OrbitalCommons/gumstick/current-df40-connectors/docs/antenna/ABRACON-QUESTIONS.md

> Historical Abracon proposal, superseded by the Pulse integration in INTEGRATION.md. Do not use these old coordinates or part numbers for assembly.

# Vendor clarification draft — not sent

We are integrating ACAG0201-2450-T into a 20 × 44.15 mm four-layer Wi-Fi PCB, with the antenna at the 20 mm end. Please provide current reference Gerber/DXF/CAD and confirm:

1. The 2025-09-20 component datasheet p.5 land pattern specifies 0.6 / 0.8 / 0.6 mm across the two pads. The p.6 reference drawing appears to label the central spacing as 0.7 mm. Which copper edges does that dimension measure, and which exact pad/cutout geometry should a new design use?
2. Exact layer-by-layer ground/feed polygons, PCB-edge datum, antenna body/pad position, and allowed ground connection geometry. Is the 3 × 5 mm envelope valid with the current antenna revision, and what are the minimum ground-plane dimensions?
3. Confirm marked-end/pad-1 input orientation in top-view placement CAD and tape/reel orientation for assembly.
4. Are the March 2025 EVB matching notes still applicable after the September 2025 product update? Please provide the latest EVB stackup and S-parameters or tuning guidance.
5. Suitability at the short edge of a 20 × 44.15 mm board, with a mating carrier below the module but the antenna end overhanging that carrier. Any additional minimum separation or enclosure guidance?

We understand final matching values require measurement on our assembled geometry.
