OrbitalCommons/gumstick/current-df40-connectors/fab/bom/module-bom.csv

Refs | Value | Footprint | Qty | DNP
C1 | 3.3pF | Module:C1_CAPC1005X60 | 1
C2 | 3.3pF | Module:C2_CAPC1005X60 | 1
C6 | 12pF | Module:C6_CAPC1005X60 | 1
C7 | 12pF | Module:C7_CAPC1005X60 | 1
C32 | 1uF | Module:C32_CAPC1005X60 | 1
C33 | 10uF | Module:C33_C_0603_1608Metric | 1
C34 | 10uF | Module:C34_C_0603_1608Metric | 1
C35 | 0.1uF | Module:C35_CAPC1005X60 | 1
C37 | 0.1uF | Module:C37_CAPC1005X60 | 1
C38 | 0.1uF | Module:C38_CAPC1005X60 | 1
C39 | 0.1uF | Module:C39_CAPC1005X60 | 1
C40 | 0.1uF | Module:C40_CAPC1005X60 | 1
C41 | 0.1uF | Module:C41_CAPC1005X60 | 1
C42 | 0.1uF | Module:C42_CAPC1005X60 | 1
C43 | 10uF | Module:C43_C_0603_1608Metric | 1
C44 | 0.1uF | Module:C44_CAPC1005X60 | 1
C45 | 10uF | Module:C45_C_0603_1608Metric | 1
C46 | 0.1uF | Module:C46_CAPC1005X60 | 1
C48 | 0.1uF | Module:C48_CAPC1005X60 | 1
C49 | 0.1uF | Module:C49_CAPC1005X60 | 1
C50 | 0.1uF | Module:C50_CAPC1005X60 | 1
C52 | 0.1uF | Module:C52_CAPC1005X60 | 1
C60 | 10uF / 10V | Module:C60_C_0603_1608Metric | 1
C61 | 22uF / 10V | Module:C61_C_0603_1608Metric | 1
C62 | 1uF / 6.3V | Module:C62_C_0603_1608Metric | 1
C63 | 1uF / 6.3V | Module:C63_C_0603_1608Metric | 1
C66 | 1uF / 6.3V | Module:C66_C_0603_1608Metric | 1
C67 | 22uF / 10V | Module:C67_C_0603_1608Metric | 1
D1 | FC-B1010RGBT-HG | Module:D1_RGBLED | 1
J1 | DF40C(2.0)-40DS-0.4V(51) | Module:J1_DF40C_40DS_2mm | 1
J2 | DF40C-40DP-0.4V(51) | Module:J2_DF40C_40DP | 1
J3 | U.FL-R-SMT-1(01) | Module:J3_U.FL_Hirose_U.FL-R-SMT-1_Vertical | 1
L1 | 100ohm @100MHz | Module:L1_L_0603_1608Metric | 1
L2 | 100ohm @100MHz | Module:L2_L_0603_1608Metric | 1
L3 | 2.2nH | Module:L3_INDC1006X60N | 1
L4 | 2.2uH | Module:L4_L_XFL3012_222MEC | 1
R3 | 0R | Module:R3_RESC1005X40 | 1
R20 | 10kR | Module:R20_RESC1005X40 | 1
R22 | 10kR | Module:R22_RESC1005X40 | 1
R28 | 10kR | Module:R28_RESC1005X40 | 1
R29 | 10kR | Module:R29_RESC1005X40 | 1
R62 | 100kR | Module:R62_R_0402_1005Metric | 1
R64 | 75kR | Module:R64_R_0402_1005Metric | 1
R65 | 24kR | Module:R65_R_0402_1005Metric | 1
U1 | ESP32-S2FH4 | Module:U1_QFN56_ESP32-S2FH4_EXP-M | 1
U2 | iCE40UP5K-SG48 | Module:U2_ICE40-QFN | 1
U3 | TPS62160DGKR | Module:U3_VSSOP-8_3x3mm_P0.65mm | 1
U4 | TLV75512PDBVR | Module:U4_SOT-23-5 | 1
Y1 | 40MHz / CL10pF | Module:Y1_JGHC_S2240000101050 | 1
