OrbitalCommons/gumstick/programming-carrier/fab/bom/carrier-bom.csv

Comment | Designator | Quantity | Footprint | MPN | LCSC Part # | Supplier URL
4.7uF | C1,C2 | 2 | Carrier:C_0603_1608Metric | CL10A475KO8NNNC | C19666 | https://www.lcsc.com/product-detail/C19666.html
100nF | C3,C10,C11,C12,C13,C14,C15,C16,C17,C18 | 10 | Carrier:C_0603_1608Metric | CC0603KRX7R9BB104 | C14663 | https://www.lcsc.com/product-detail/C14663.html
GREEN | D1,D2,D10,D11,D12,D13,D14,D15,D16,D17,D18,D19,D20,D21,D22,D23,D24,D25,D26,D27,D28,D29,D30,D31,D32,D33,D34,D35,D36,D42,D43,D44,D45,D46,D47,D48,D49,D50,D51,D52,D53,D54,D55,D56,D57,D58,D59,D60,D61,D62,D63,D64,D65,D66,D67,D68,D69,D70,D71 | 59 | Carrier:LED_0603_1608Metric | XL-1608SYGC-06 | C965805 | https://www.lcsc.com/product-detail/C965805.html
RED | D74,D75,D76 | 3 | Carrier:LED_0603_1608Metric | KT-0603R | C2286 | https://www.lcsc.com/product-detail/C2286.html
500mA PTC | F1 | 1 | Carrier:Fuse_1206_3216Metric | 1206L050/15YR | C151162 | https://www.lcsc.com/product-detail/C151162.html
DF40C-40DP-0.4V(51) | J1 | 1 | Carrier:J1_Module_v1_Mate | DF40C-40DP-0.4V(51) | C424643 | https://www.lcsc.com/product-detail/C424643.html
DF40C(2.0)-40DS-0.4V(51) | J2 | 1 | Carrier:J2_Module_v1_Mate | DF40C(2.0)-40DS-0.4V(51) | C597934 | https://www.lcsc.com/product-detail/C597934.html
USB-C USB2 | J3 | 1 | Carrier:USB_C_Receptacle_HRO_TYPE-C-31-M-12 | TYPE-C-31-M-12 | C165948 | https://www.lcsc.com/product-detail/C165948.html
5.1kR | R1,R2 | 2 | Carrier:R_0603_1608Metric | 0603WAF5101T5E | C23186 | https://www.lcsc.com/product-detail/C23186.html
2.2kR | R3 | 1 | Carrier:R_0603_1608Metric | 0603WAF2201T5E | C4190 | https://www.lcsc.com/product-detail/C4190.html
1kR | R4,R5,R10,R11,R12,R13,R14,R15,R16,R17,R18,R19,R20,R21,R22,R23,R24,R25,R26,R27,R28,R29,R30,R31,R32,R33,R34,R35,R36,R42,R43,R44,R45,R46,R47,R48,R49,R50,R51,R52,R53,R54,R55,R56,R57,R58,R59,R60,R61,R62,R63,R64,R65,R66,R67,R68,R69,R70,R71,R74,R75,R76 | 62 | Carrier:R_0603_1608Metric | 0603WAF1001T5E | C21190 | https://www.lcsc.com/product-detail/C21190.html
100kR | R110,R111,R112,R113,R114,R115,R116,R117,R118,R119,R120,R121,R122,R123,R124,R125,R126,R127,R128,R129,R130,R131,R132,R133,R134,R135,R136,R142,R143,R144,R145,R146,R147,R148,R149,R150,R151,R152,R153,R154,R155,R156,R157,R158,R159,R160,R161,R162,R163,R164,R165,R166,R167,R168,R169,R170,R171,R174,R175,R176 | 60 | Carrier:R_0603_1608Metric | 0603WAF1003T5E | C25803 | https://www.lcsc.com/product-detail/C25803.html
BOOT / RUN | SW1 | 1 | Carrier:SW_SPDT_CK_JS102011SAQN | JS102011SAQN | C221660 | https://www.lcsc.com/product-detail/C221660.html
RESET / GPIO46 INPUT | SW2,SW3 | 2 | Carrier:SW_SPST_TL3342 | TL3342F160QG | C2886898 | https://www.lcsc.com/product-detail/C2886898.html
AP2112K-3.3 | U1 | 1 | Carrier:SOT-23-5 | AP2112K-3.3TRG1 | C51118 | https://www.lcsc.com/product-detail/C51118.html
USBLC6-2SC6 | U2 | 1 | Carrier:SOT-23-6 | USBLC6-2SC6 | C7519 | https://www.lcsc.com/product-detail/C7519.html
SN74LVC541APWR | U3,U4,U5,U6,U7,U8,U9,U10,U11 | 9 | Carrier:TSSOP-20_4.4x6.5mm_P0.65mm | SN74LVC541APWR | C113281 | https://www.lcsc.com/product-detail/C113281.html
