OrbitalCommons/gumstick/current-df40-connectors/3dmodels/ACAG0201-2450.step

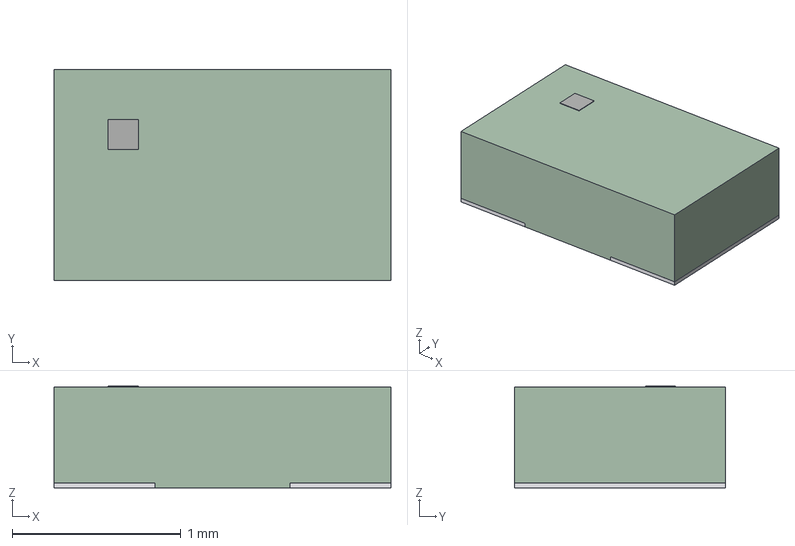
[picture p10: CAD file, 2026-09-26]
current-df40-connectors/3dmodels/ACAG0201-2450.step
2.00 x 1.25 x 0.604 mm
nominal_body
terminal_1
terminal_2
top_orientation_mark
