OrbitalCommons/gumstick/current-df40-connectors/fab/module.step

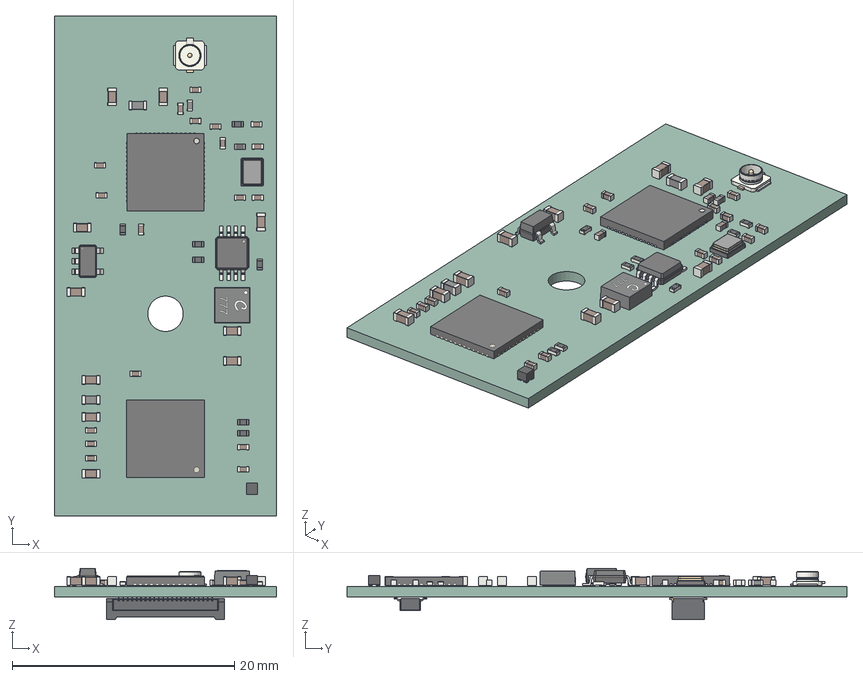
[picture p11: CAD file, 2026-10-06]
current-df40-connectors/fab/module.step
20.0 x 45.0 x 4.62 mm
L_0603_1608Metric x 2
C_0402_1005Metric x 18
SOT-23-5
C_0603_1608Metric x 10
R_0402_1005Metric x 8
U.FL_Hirose_U.FL-R-SMT-1_Vertical
VSSOP-8_3x3mm_P0.65mm
a48c614c-8773-11ed-8f9d-58fb8493fcfb_part
a48c63fe-8773-11ed-8f9d-58fb8493fcfb_part
a48c65a2-8773-11ed-8f9d-58fb8493fcfb_part
a48c66d8-8773-11ed-8f9d-58fb8493fcfb_part
QFN-48-1EP_7x7mm_Pitch0.5mm
Crystal_SMD_2520-4Pin_2.5x2.0mm
XFL3012
black_package
terminal_1
terminal_2
terminal_3
terminal_4
L_0402_1005Metric
DF40C_40DP
DF40C_2_0_40DS
module_PCB
