OrbitalCommons/gumstick/current-df40-connectors/renders/current-df40-connectors.stl

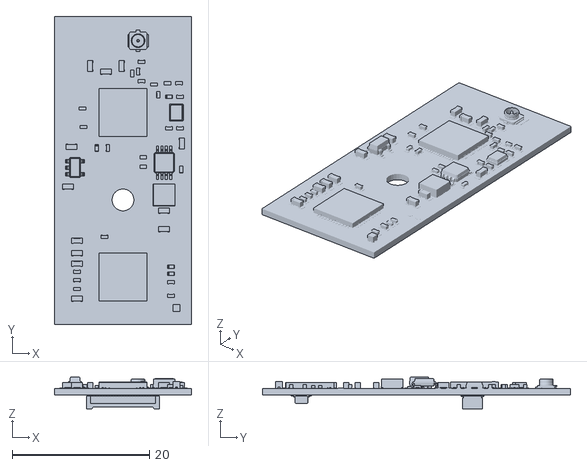
[picture p12: CAD file, 2026-10-20]
current-df40-connectors/renders/current-df40-connectors.stl
20.0 x 45.0 x 4.62
