OrbitalCommons/gumstick/future-m2-goldfingers/3dmodels/FC-B1010RGBT-HG_approx.step

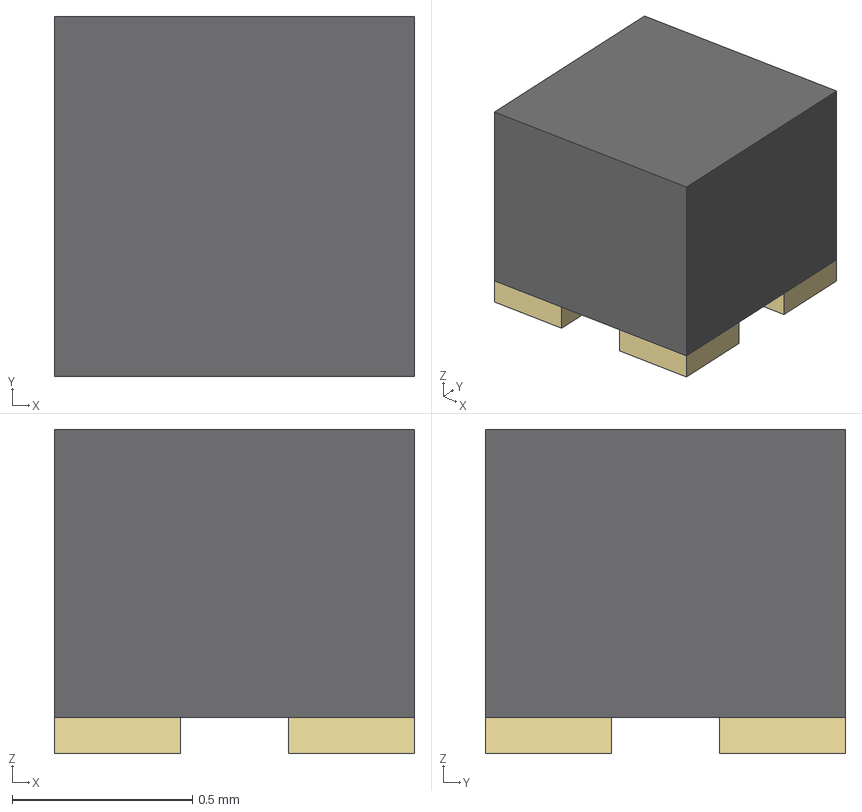
[picture p13: CAD file, 2026-10-08]
future-m2-goldfingers/3dmodels/FC-B1010RGBT-HG_approx.step
1.00 x 1.00 x 0.9 mm
black_package
terminal_1
terminal_2
terminal_3
terminal_4
