OrbitalCommons/gumstick/future-m2-goldfingers/renders/future-m2-goldfingers.stl

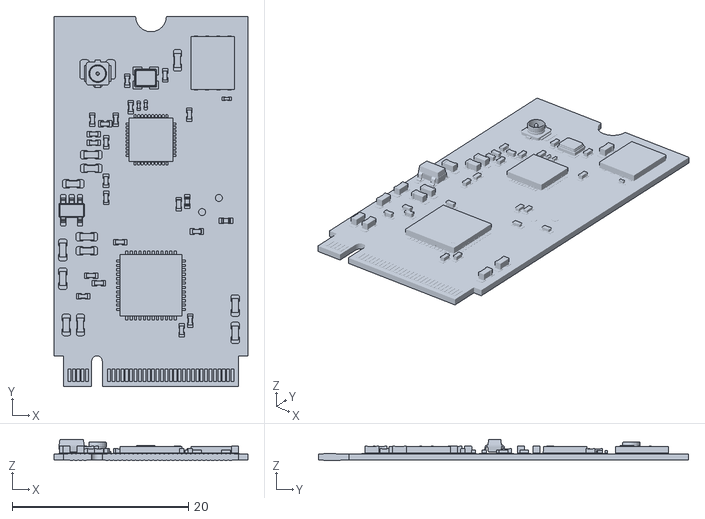
[picture p14: CAD file, 2026-10-20]
future-m2-goldfingers/renders/future-m2-goldfingers.stl
22.0 x 42.0 x 2.40
