OrbitalCommons/gumstick/programming-carrier/3dmodels/DF40C_40DP.step

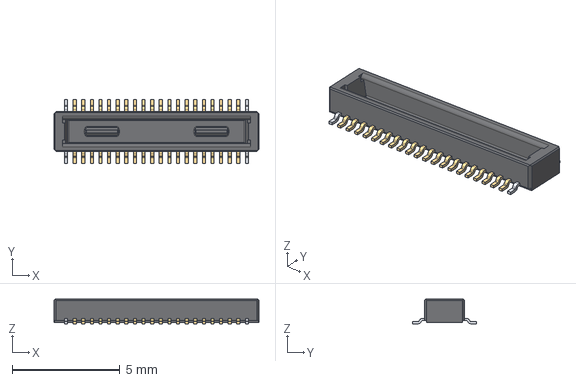
[picture p15: CAD file, 2026-09-26]
programming-carrier/3dmodels/DF40C_40DP.step
9.52 x 2.97 x 1.14 mm
