OrbitalCommons/gumstick/programming-carrier/renders/programming-carrier.stl

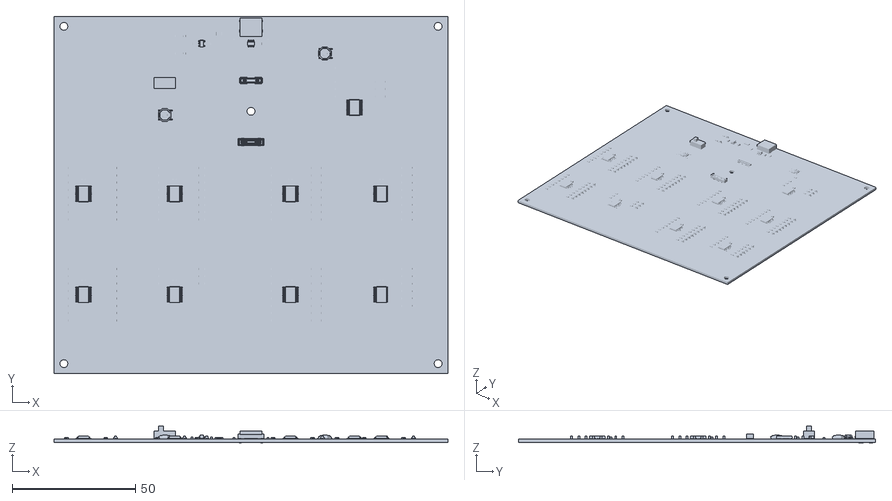
[picture p16: CAD file, 2026-10-20]
programming-carrier/renders/programming-carrier.stl
160.0 x 145.0 x 6.74
