OrbitalCommons/gumstick/current-df40-connectors/3dmodels/ANT2012LL00R2400A.step

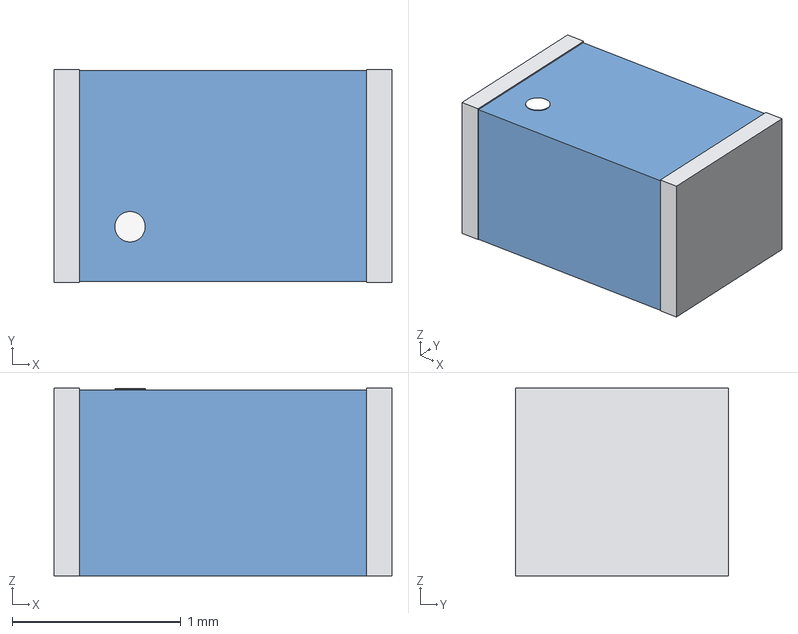
[picture p17: CAD file, 2026-09-26]
current-df40-connectors/3dmodels/ANT2012LL00R2400A.step
2.00 x 1.26 x 1.11 mm
ceramic
terminal_1
terminal_2
feed_mark
