OrbitalCommons/gumstick/programming-carrier/3dmodels/USB_C_HRO_envelope.step

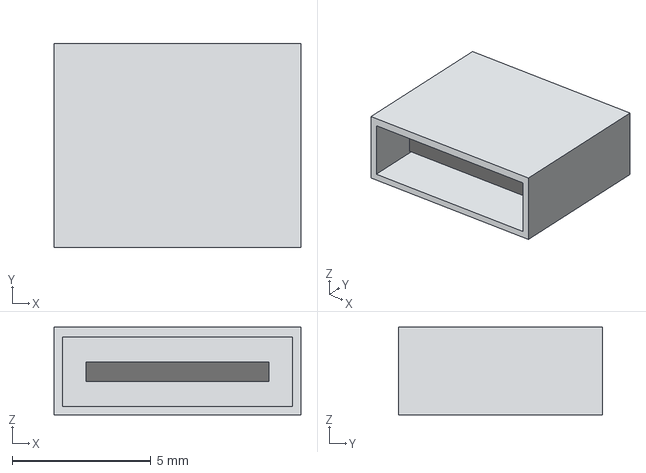
[picture p18: CAD file, 2026-09-26]
programming-carrier/3dmodels/USB_C_HRO_envelope.step
8.90 x 7.35 x 3.16 mm
shield
tongue
