OrbitalCommons/gumstick/current-df40-connectors/3dmodels/XFL3012_approx.step

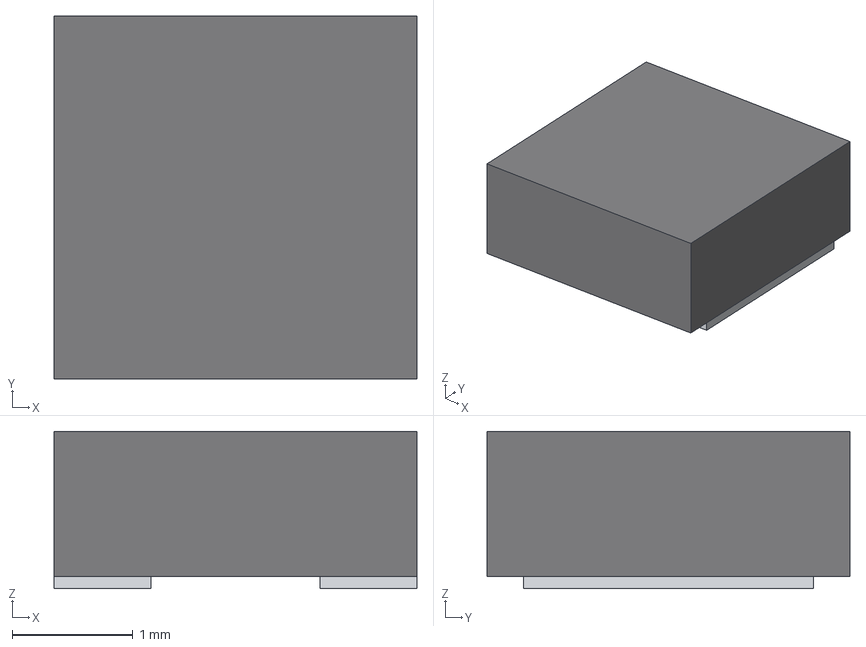
[picture p19: CAD file, 2026-09-26]
current-df40-connectors/3dmodels/XFL3012_approx.step
3.00 x 3.00 x 1.30 mm
molded_body
terminal_1
terminal_2
