OrbitalCommons/gumstick/programming-carrier/3dmodels/CK_JS102011SAQN_envelope.step

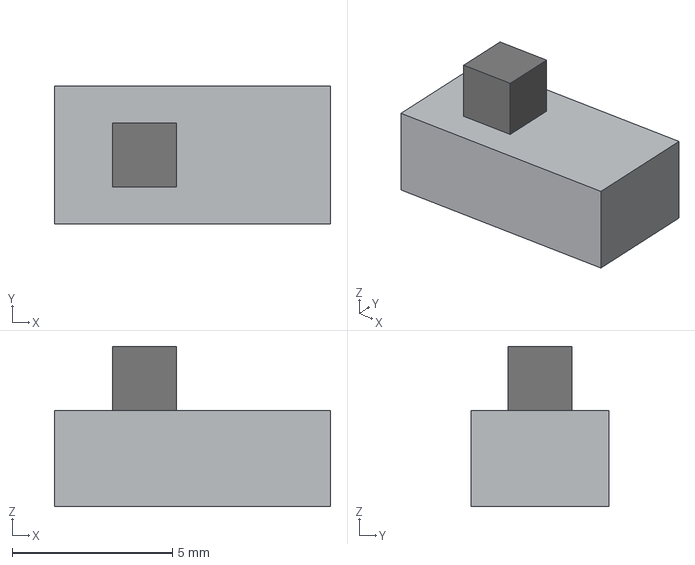
[picture p20: CAD file, 2026-09-26]
programming-carrier/3dmodels/CK_JS102011SAQN_envelope.step
8.60 x 4.30 x 5.00 mm
actuator
