OrbitalCommons/gumstick/programming-carrier/3dmodels/DF40C_2_0_40DS.step

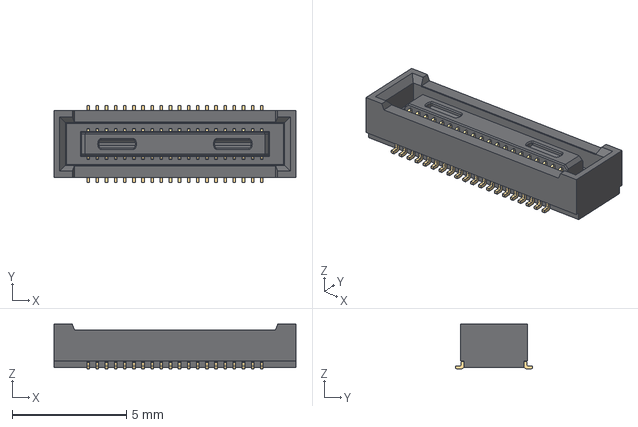
[picture p21: CAD file, 2026-09-26]
programming-carrier/3dmodels/DF40C_2_0_40DS.step
10.6 x 3.38 x 1.95 mm
