OrbitalCommons/gumstick/current-df40-connectors/fab/ASSEMBLY-STATUS.md

# Engineering exports — external U.FL only, 2026-09-26

BOM/CPL, Gerbers/drills, schematic PDF and model regenerated together. Chip antenna and selector branches removed; 47 purchased placements remain. Use jlcpcb/BOM_module.csv with jlcpcb/CPL_module.csv. J3 supplier ID remains unresolved. Validate assembly orientation, mating cable clearance, actual impedance stackup and RF performance before release. An external antenna is required. See ../docs/antenna/INTEGRATION.md.
