OrbitalCommons/gumstick/future-m2-goldfingers/docs/module-schematic.pdf

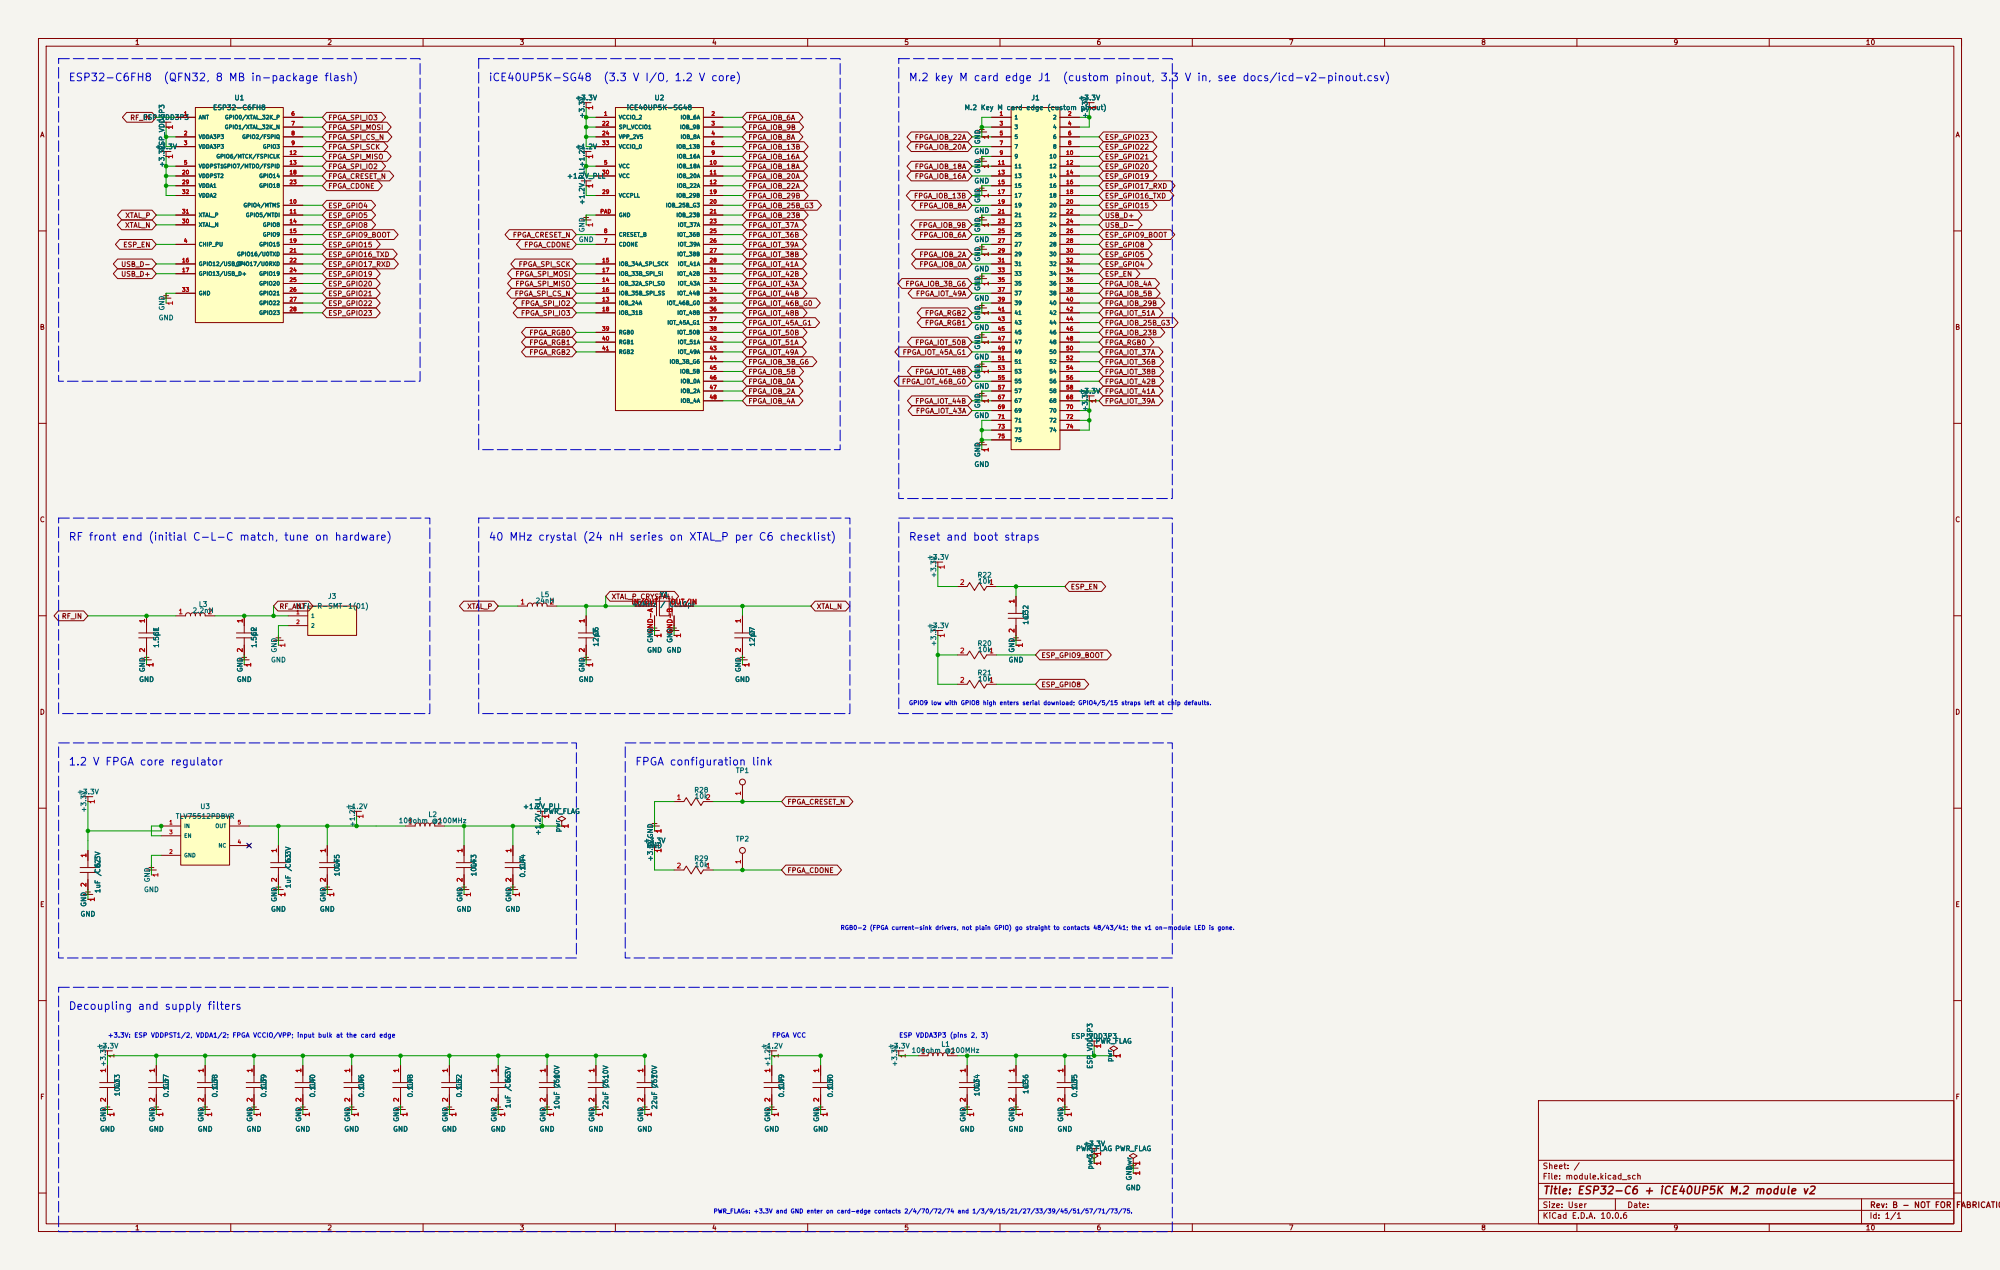
[picture p22: page 1]

ESP32-C6FH8 (QFN32, 8 MB in-package flash)

M.2 key M card edge J1 (custom pinout, 3.3 V in, see docs/icd-v2-pinout.csv)

J1 M.2 Key M card edge (custom pinout) 1

RF front end (initial C-L-C match, tune on hardware)

40 MHz crystal (24 nH series on XTAL_P per C6 checklist)

Reset and boot straps

GPIO9 low with GPIO8 high enters serial download; GPIO4/5/15 straps left at chip defaults. RGB0-2 (FPGA current-sink drivers, not plain GPIO) go straight to contacts 48/43/41; the v1 on-module LED is gone. FPGA VCC FPGA configuration link

Decoupling and supply filters

1 2 C67 22uF / 10V pwr 1 PWR_FLAG +3.3V 1 pwr 1 PWR_FLAG GND1 GND GND1 GND GND1 GND
