OrbitalCommons/gumstick/current-df40-connectors/fab/module-schematic.pdf

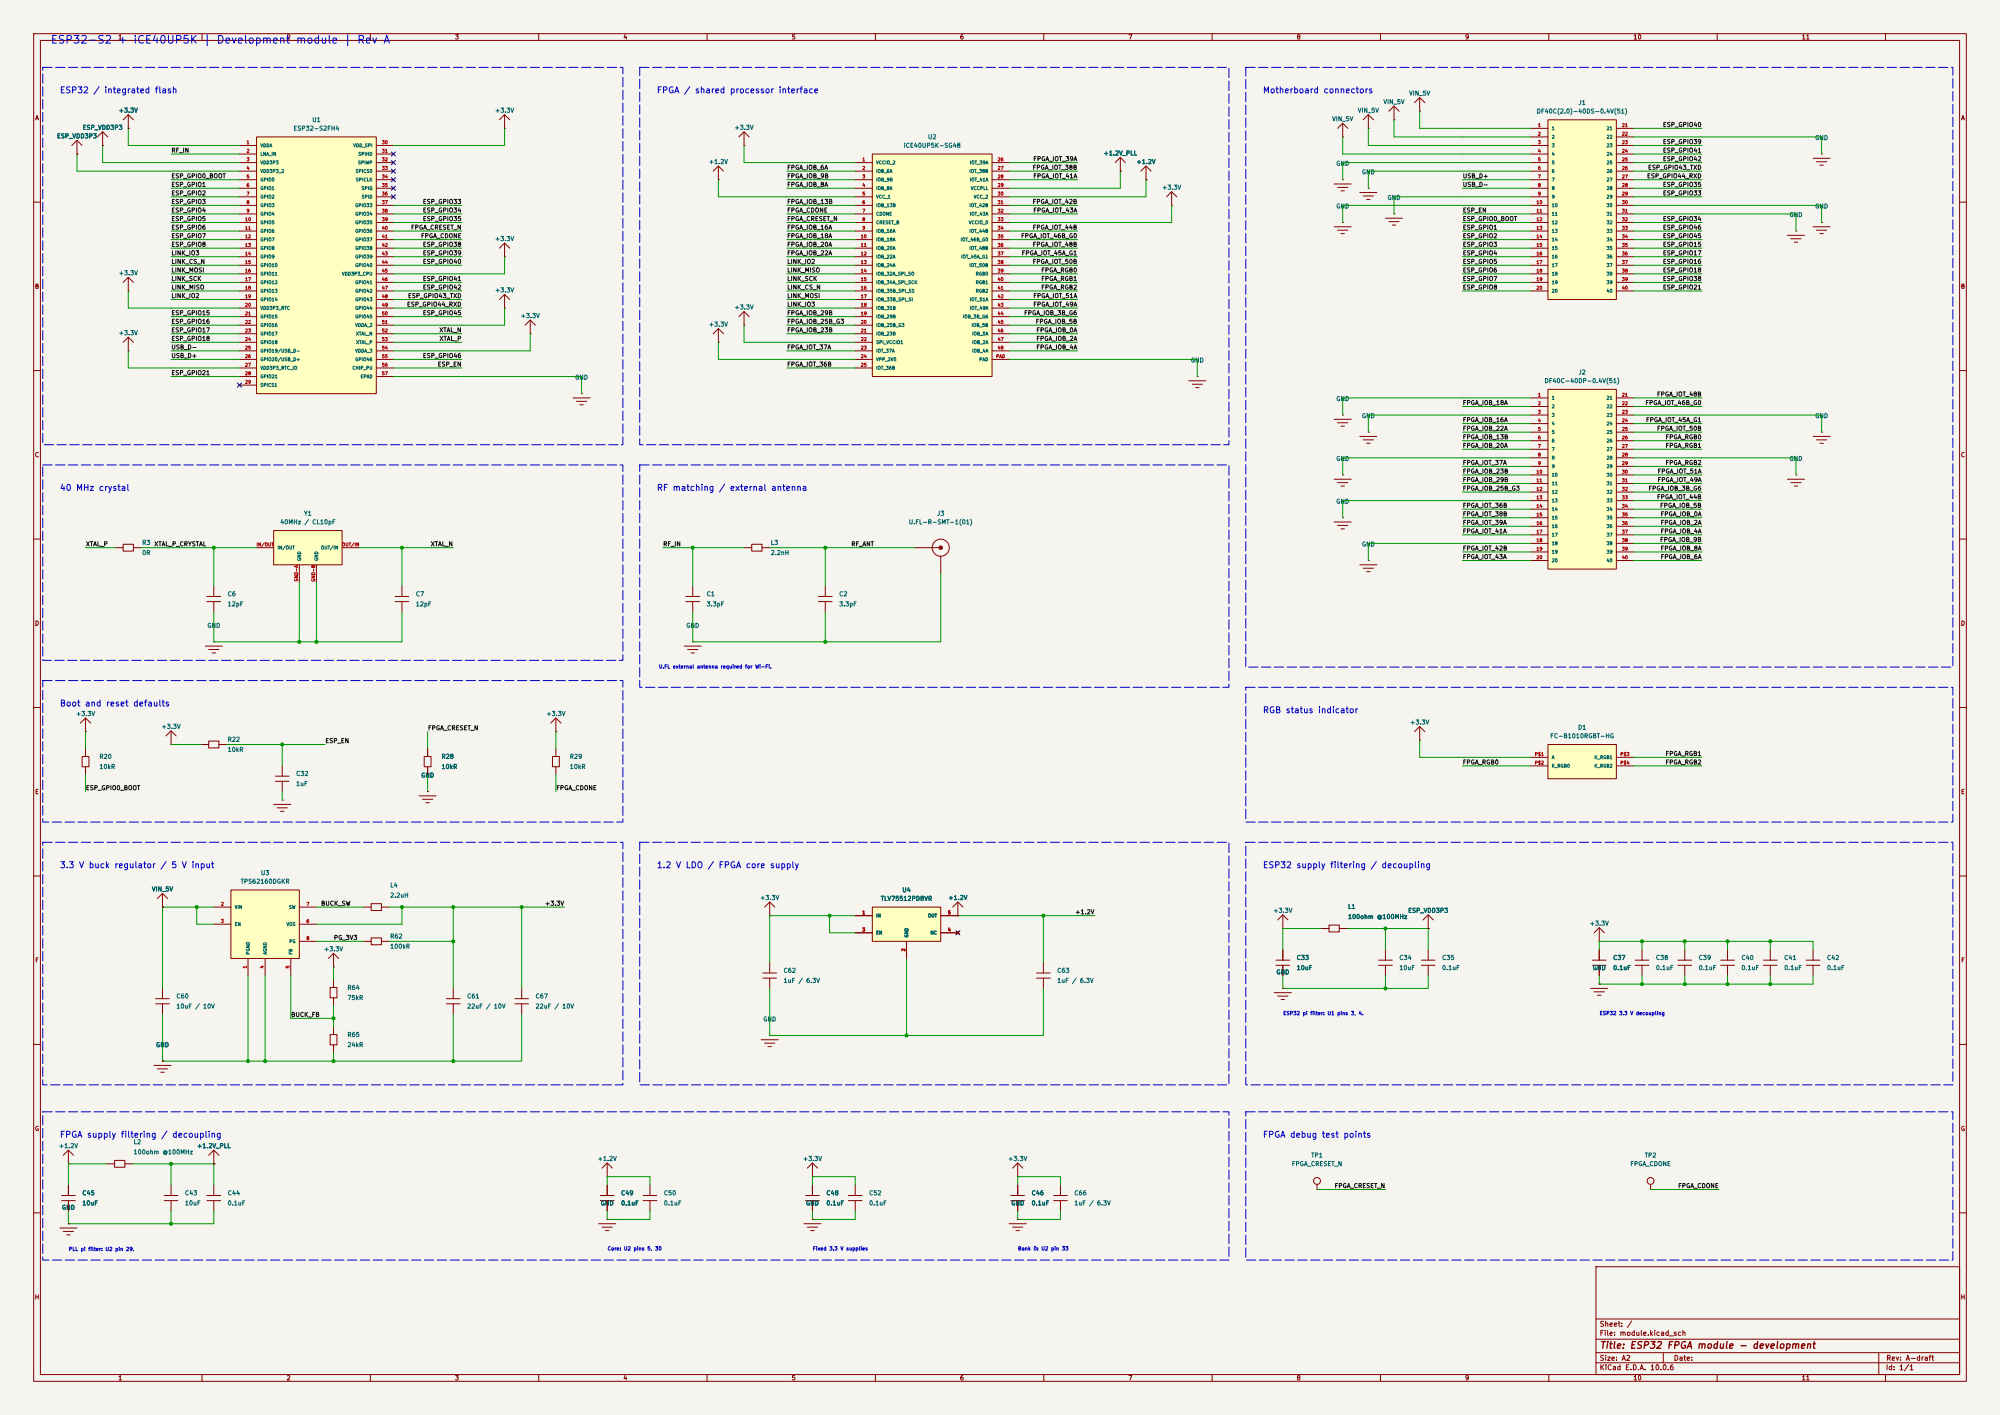
[picture p23: page 1]

Boot and reset defaults

ESP32 3.3 V decoupling PLL pi filter: U2 pin 29.

Fixed 3.3 V supplies FPGA supply filtering / decoupling

Sheet: /
File: module.kicad_sch
Title: ESP32 FPGA module - development

Size: A2 | Rev: A-draft
KiCad E.D.A. 10.0.6 | Id: 1/1
