OrbitalCommons/gumstick/future-m2-goldfingers/module.kicad_pcb

## KiCad design future-m2-goldfingers/module.kicad_pcb (2026-10-09)

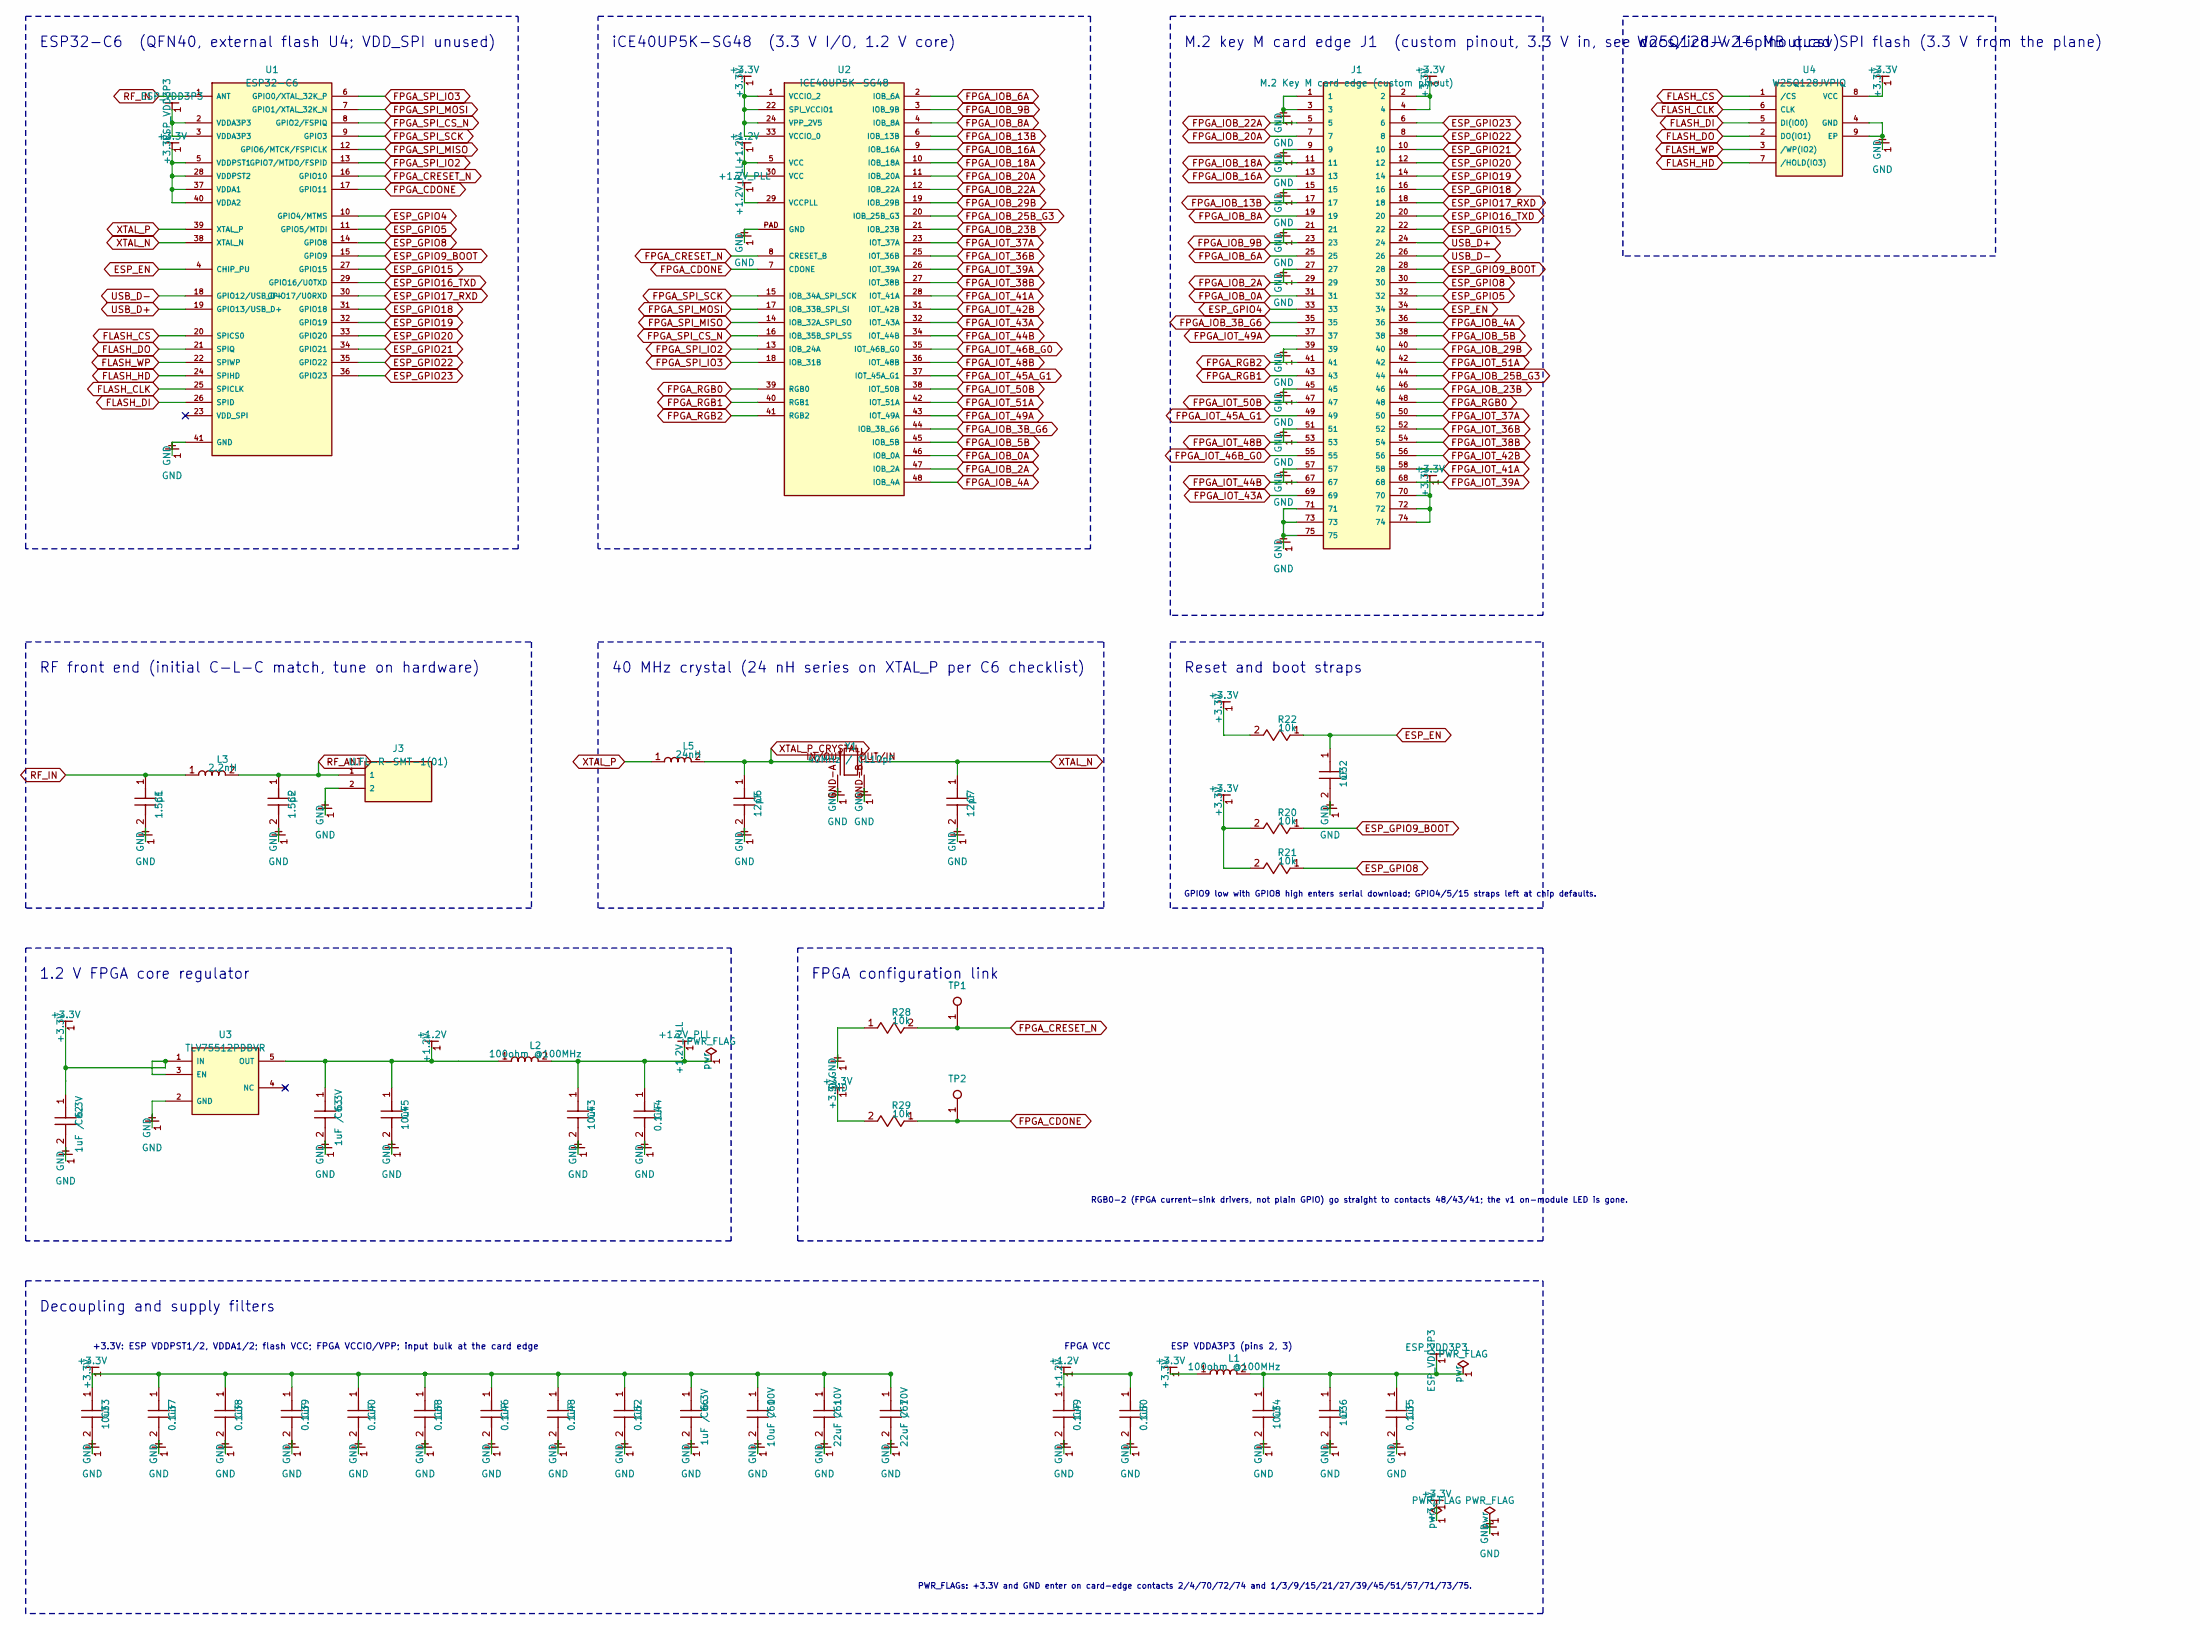
[picture p24: schematic module.kicad_sch, ESP32-C6 + iCE40UP5K M.2 module v2]

Parts:
C1, C2: 1.5pF; C_0402
C6, C7: 12pF; C_0402
C32, C36: 1uF; C_0402
C33, C34, C43, C45: 10uF; C_0603
C35, C37, C38, C40, C44, C46, C48, C49, C50, C52: 0.1uF; C_0402
C39, C68: 0.1uF; C_0201
C60: 10uF / 10V; C_0603
C61, C67: 22uF / 10V; C_0603
C62, C63, C66: 1uF / 6.3V; C_0603
J1: M.2 Key M card edge (custom pinout); M2_CardEdge_KeyM_2242
J3: U.FL-R-SMT-1(01); UFL_Vertical
L1, L2: 100ohm @100MHz; L_0603
L3: 2.2nH; L_0402
L5: 24nH; L_0201
R20, R21, R22, R28, R29: 10k; R_0402
TP1: FPGA_CRESET_N; TestPoint_0p8
TP2: FPGA_CDONE; TestPoint_0p8
U1: ESP32-C6; QFN-40-1EP_5x5mm_P0.4mm_EP3.3x3.3mm
U2: iCE40UP5K-SG48; ICE40-QFN
U3: TLV75512PDBVR; SOT-23-5
U4: W25Q128JVPIQ; WSON-8-1EP_6x5mm_P1.27mm_EP3.4x4.3mm
Y1: 40MHz / CL10pF; Crystal_2520_4pin

Connections:
+1.2V: C45.1, C49.1, C50.1, C63.1, L2.1, U2.5 (VCC), U2.30 (VCC), U3.5 (OUT)
+1.2V_PLL: C43.1, C44.1, L2.2, U2.29 (VCCPLL)
ESP_EN: C32.1, J1.34, R22.1, U1.4 (CHIP_PU)
ESP_GPIO4: J1.33, U1.10 (GPIO4/MTMS)
ESP_GPIO5: J1.32, U1.11 (GPIO5/MTDI)
ESP_GPIO8: J1.30, R21.1, U1.14 (GPIO8)
ESP_GPIO9_BOOT: J1.28, R20.1, U1.15 (GPIO9)
ESP_GPIO15: J1.22, U1.27 (GPIO15)
ESP_GPIO16_TXD: J1.20, U1.29 (GPIO16/U0TXD)
ESP_GPIO17_RXD: J1.18, U1.30 (GPIO17/U0RXD)
ESP_GPIO18: J1.16, U1.31 (GPIO18)
ESP_GPIO19: J1.14, U1.32 (GPIO19)
ESP_GPIO20: J1.12, U1.33 (GPIO20)
ESP_GPIO21: J1.10, U1.34 (GPIO21)
ESP_GPIO22: J1.8, U1.35 (GPIO22)
ESP_GPIO23: J1.6, U1.36 (GPIO23)
ESP_VDD3P3: C34.1, C35.1, C36.1, L1.2, U1.2 (VDDA3P3), U1.3 (VDDA3P3)
FLASH_CLK: U1.25 (SPICLK), U4.6 (CLK)
FLASH_CS: U1.20 (SPICS0), U4.1 (/CS)
FLASH_DI: U1.26 (SPID), U4.5 (DI(IO0))
FLASH_DO: U1.21 (SPIQ), U4.2 (DO(IO1))
FLASH_HD: U1.24 (SPIHD), U4.7 (/HOLD(IO3))
FLASH_WP: U1.22 (SPIWP), U4.3 (/WP(IO2))
FPGA_CDONE: R29.1, TP2.1, U1.17 (GPIO11), U2.7 (CDONE)
FPGA_CRESET_N: R28.2, TP1.1, U1.16 (GPIO10), U2.8 (CRESET_B)
FPGA_IOB_0A: J1.31, U2.46 (IOB_0A)
FPGA_IOB_3B_G6: J1.35, U2.44 (IOB_3B_G6)
FPGA_IOB_4A: J1.36, U2.48 (IOB_4A)
FPGA_IOB_5B: J1.38, U2.45 (IOB_5B)
FPGA_IOB_6A: J1.25, U2.2 (IOB_6A)
FPGA_IOB_8A: J1.19, U2.4 (IOB_8A)
FPGA_IOB_16A: J1.13, U2.9 (IOB_16A)
FPGA_IOB_20A: J1.7, U2.11 (IOB_20A)
FPGA_IOB_23B: J1.46, U2.21 (IOB_23B)
FPGA_IOB_25B_G3: J1.44, U2.20 (IOB_25B_G3)
FPGA_IOB_29B: J1.40, U2.19 (IOB_29B)
FPGA_IOT_36B: J1.52, U2.25 (IOT_36B)
FPGA_IOT_37A: J1.50, U2.23 (IOT_37A)
FPGA_IOT_38B: J1.54, U2.27 (IOT_38B)
FPGA_IOT_41A: J1.58, U2.28 (IOT_41A)
FPGA_IOT_42B: J1.56, U2.31 (IOT_42B)
FPGA_IOT_43A: J1.69, U2.32 (IOT_43A)
FPGA_IOT_45A_G1: J1.49, U2.37 (IOT_45A_G1)
FPGA_IOT_46B_G0: J1.55, U2.35 (IOT_46B_G0)
FPGA_IOT_49A: J1.37, U2.43 (IOT_49A)
FPGA_IOT_51A: J1.42, U2.42 (IOT_51A)
FPGA_RGB0: J1.48, U2.39 (RGB0)
FPGA_RGB1: J1.43, U2.40 (RGB1)
FPGA_SPI_CS_N: U1.8 (GPIO2/FSPIQ), U2.16 (IOB_35B_SPI_SS)
FPGA_SPI_IO2: U1.13 (GPIO7/MTDO/FSPID), U2.13 (IOB_24A)
FPGA_SPI_IO3: U1.6 (GPIO0/XTAL_32K_P), U2.18 (IOB_31B)
FPGA_SPI_MISO: U1.12 (GPIO6/MTCK/FSPICLK), U2.14 (IOB_32A_SPI_SO)
FPGA_SPI_MOSI: U1.7 (GPIO1/XTAL_32K_N), U2.17 (IOB_33B_SPI_SI)
FPGA_SPI_SCK: U1.9 (GPIO3), U2.15 (IOB_34A_SPI_SCK)
RF_ANT: C2.1, J3.1, L3.2
RF_IN: C1.1, L3.1, U1.1 (ANT)
USB_D+: J1.24, U1.19 (GPIO13/USB_D+)
USB_D-: J1.26, U1.18 (GPIO12/USB_D-)
XTAL_N: C7.1, U1.38 (XTAL_N), Y1.OUT/IN
XTAL_P: L5.1, U1.39 (XTAL_P)
XTAL_P_CRYSTAL: C6.1, L5.2, Y1.IN/OUT

Notes on the sheet:
ESP32-C6 (QFN40, external flash U4; VDD_SPI unused)
W25Q128JV 16 MB quad SPI flash (3.3 V from the plane)
iCE40UP5K-SG48 (3.3 V I/O, 1.2 V core)
M.2 key M card edge J1 (custom pinout, 3.3 V in, see docs/icd-v2-pinout.csv)
RF front end (initial C-L-C match, tune on hardware)
40 MHz crystal (24 nH series on XTAL_P per C6 checklist)
Reset and boot straps
GPIO9 low with GPIO8 high enters serial download; GPIO4/5/15 straps left at chip defaults.
1.2 V FPGA core regulator
FPGA configuration link
RGB0-2 (FPGA current-sink drivers, not plain GPIO) go straight to contacts 48/43/41; the v1 on-module LED is gone.
Decoupling and supply filters
+3.3V: ESP VDDPST1/2, VDDA1/2; flash VCC; FPGA VCCIO/VPP; input bulk at the card edge
FPGA VCC
ESP VDDA3P3 (pins 2, 3)
PWR_FLAGs: +3.3V and GND enter on card-edge contacts 2/4/70/72/74 and 1/3/9/15/21/27/39/45/51/57/71/73/75.

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
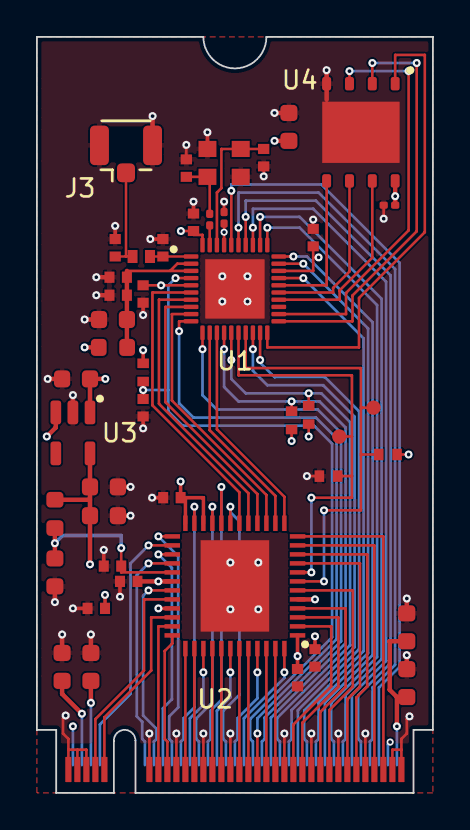
[picture p25: board future-m2-goldfingers/module.kicad_pcb from above]

Board: 4 copper layers, 22.0 x 42.0 mm, 46 parts (0 on the bottom side), 73 nets.
