OrbitalCommons/gumstick/current-df40-connectors/module.kicad_pcb

## KiCad design current-df40-connectors/module.kicad_pcb (2026-10-06, an earlier design)

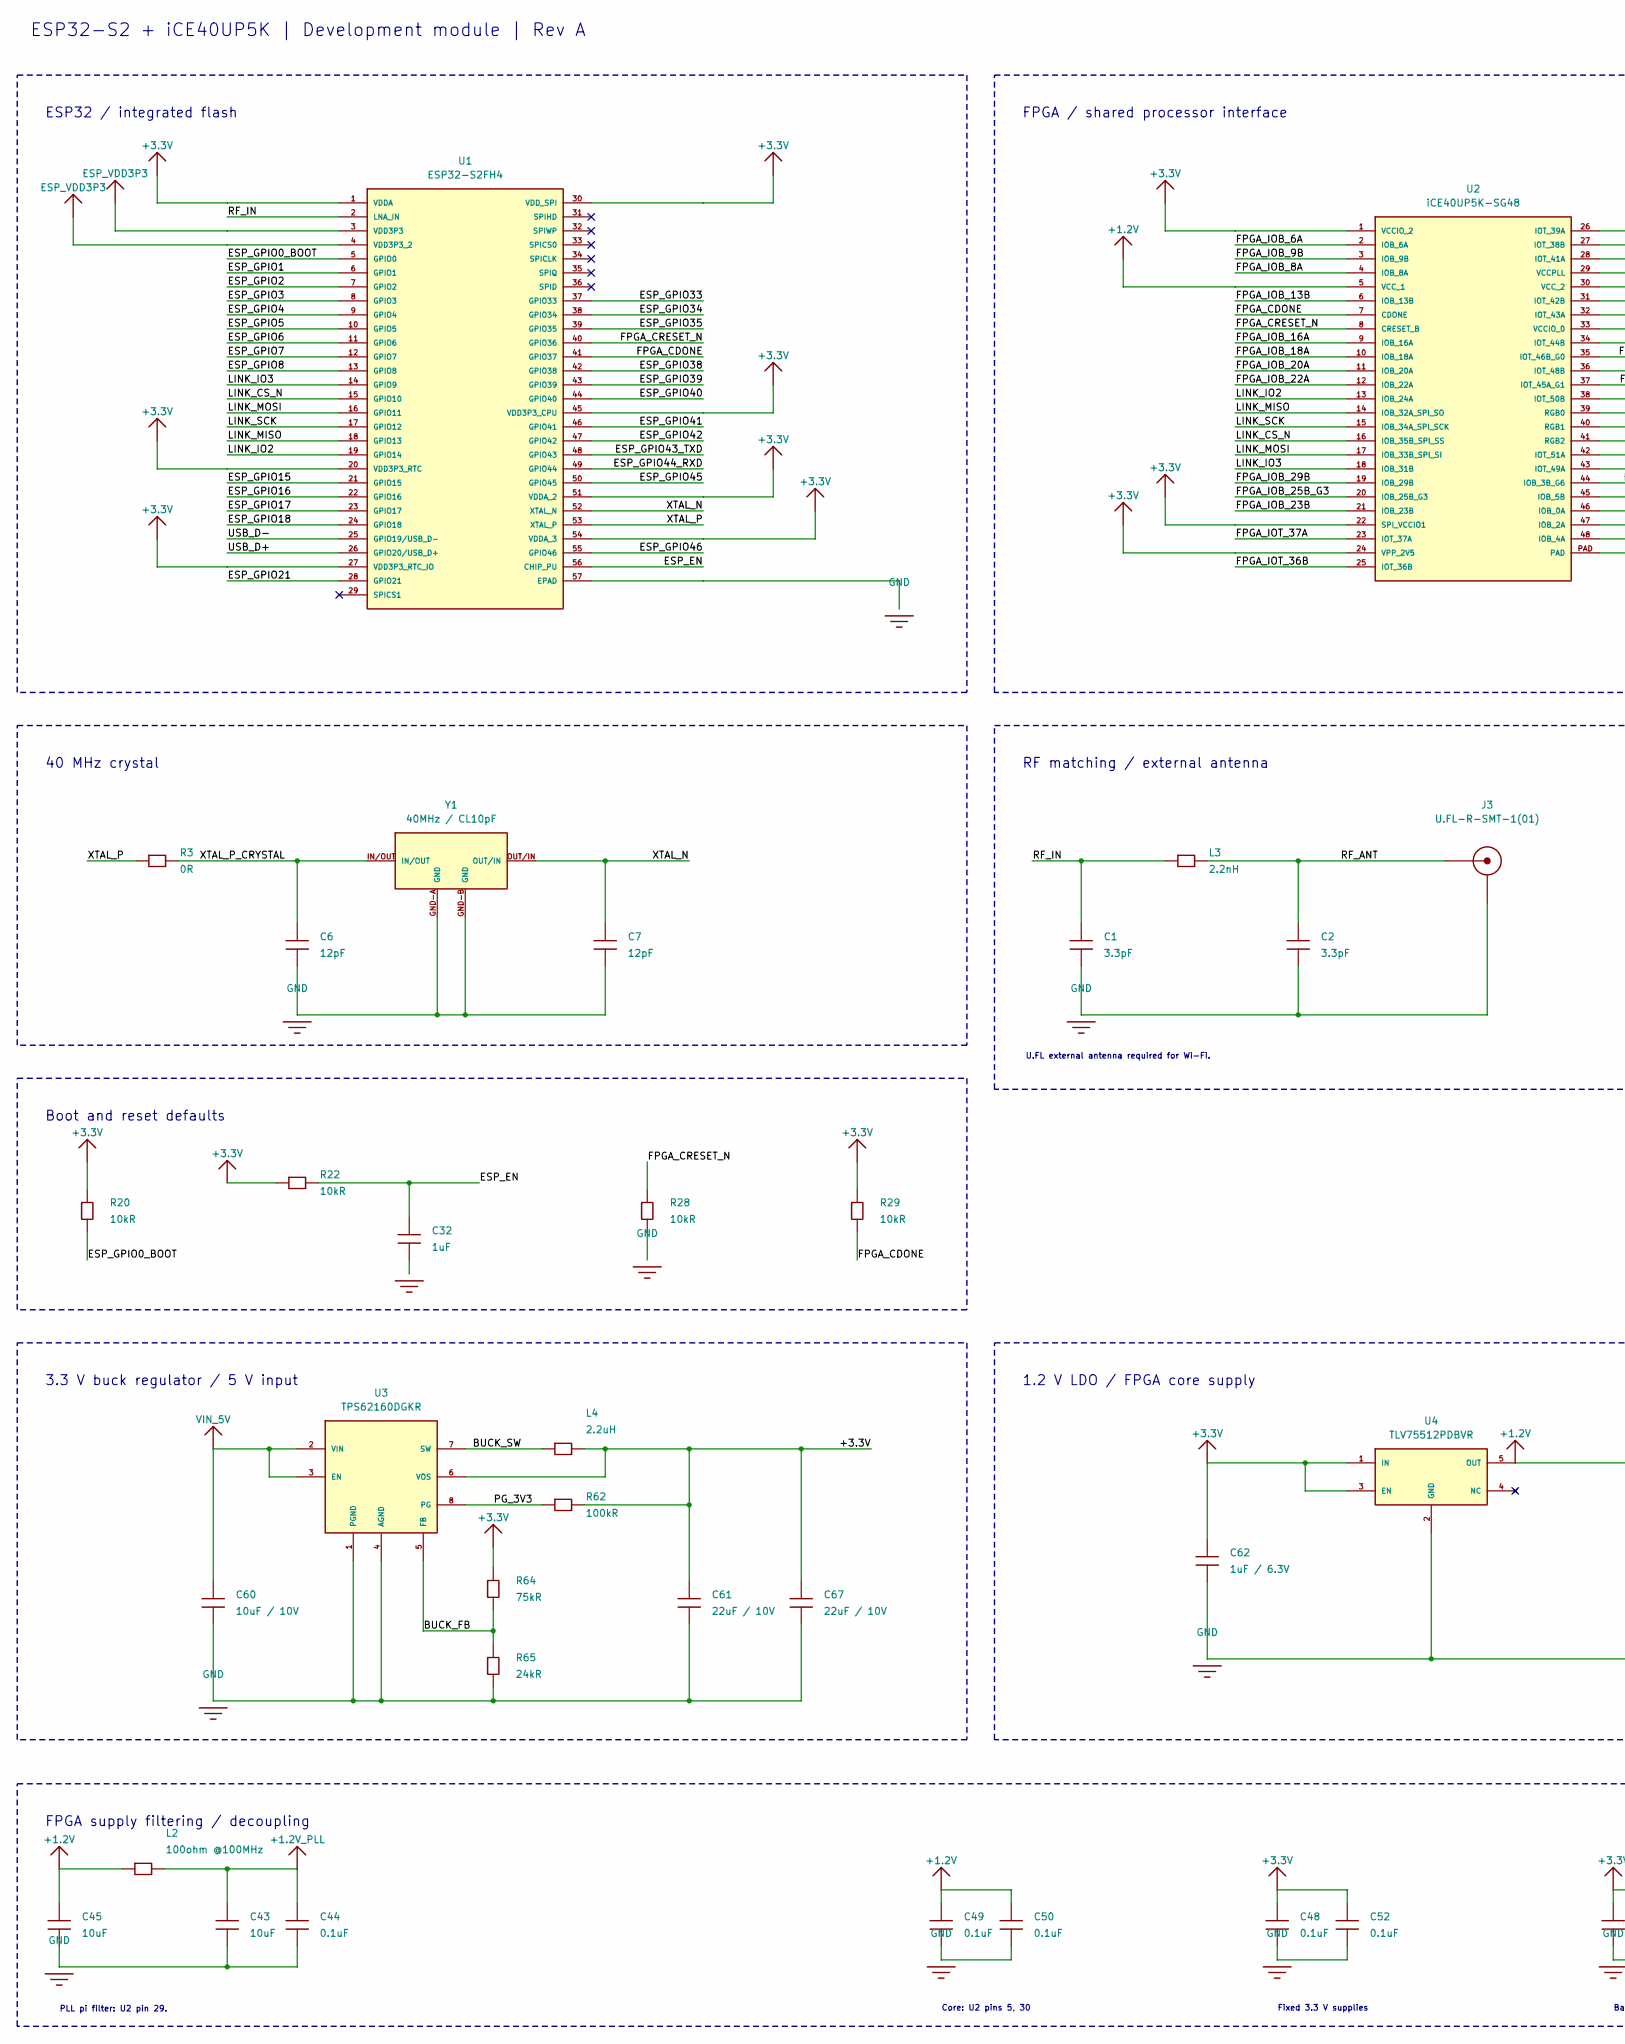
[picture p26: schematic module.kicad_sch, ESP32 FPGA module - development, part in row 1, column 1]

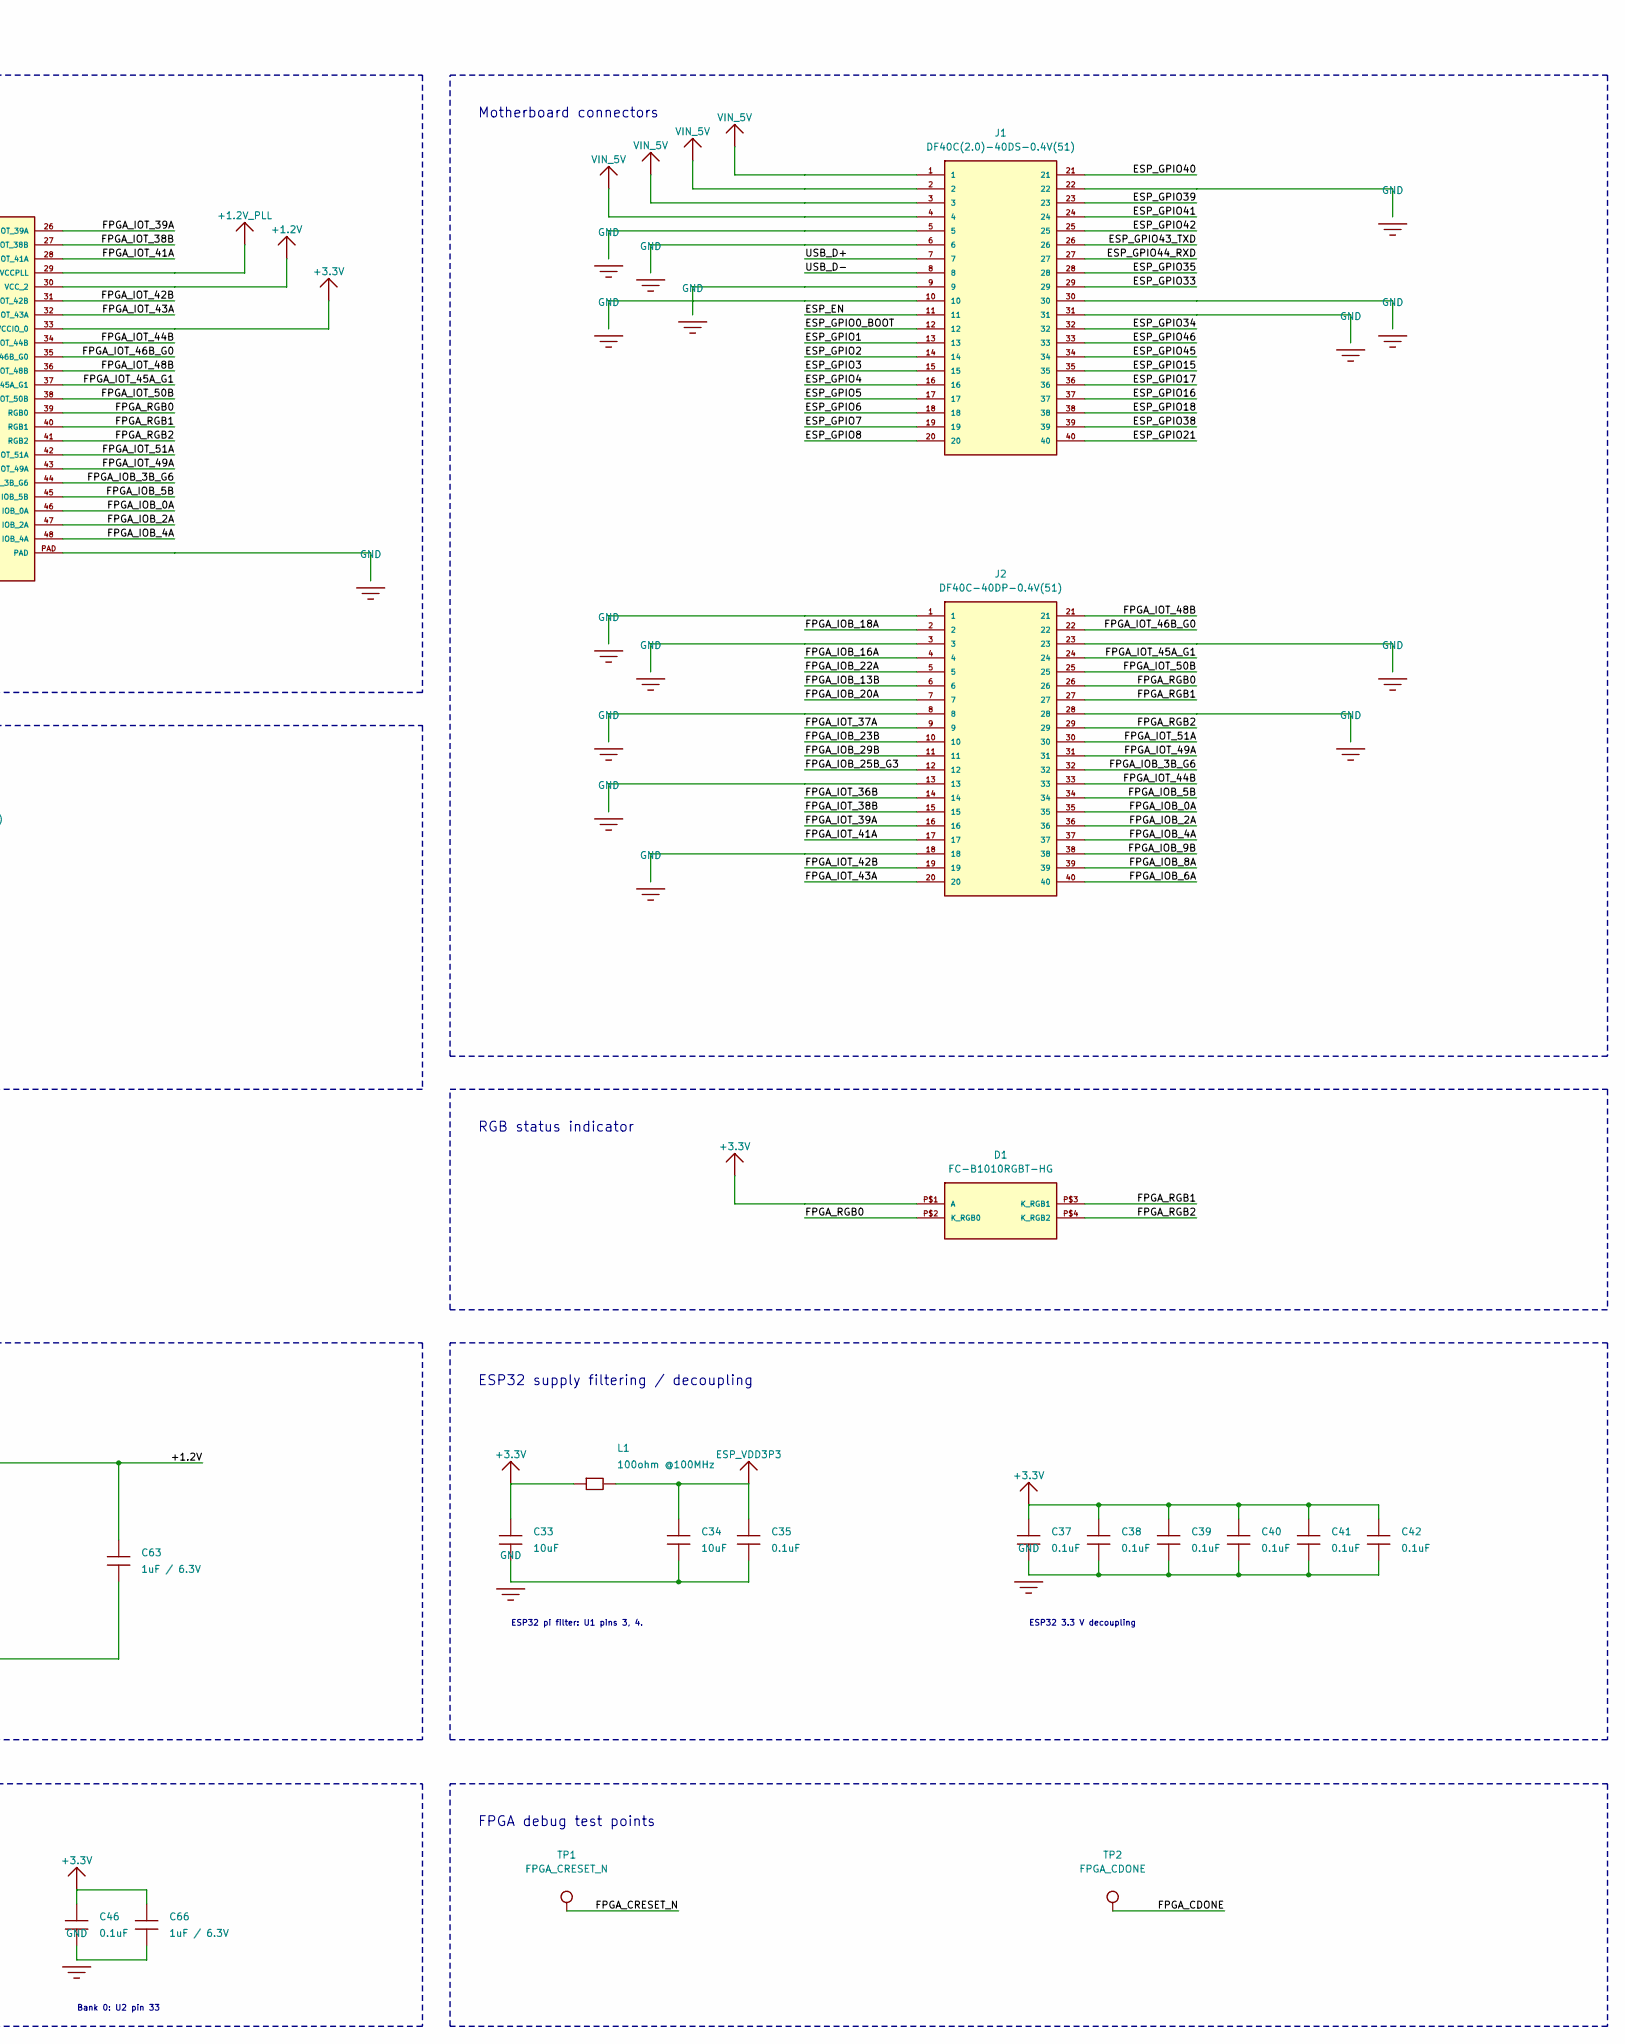
[picture p27: schematic module.kicad_sch, ESP32 FPGA module - development, part in row 1, column 2]

Parts:
C1: 3.3pF; C1_CAPC1005X60; MPN GJM1555C1H3R3BB01D; LCSC C76906
C2: 3.3pF; C2_CAPC1005X60; MPN GJM1555C1H3R3BB01D; LCSC C76906
C6: 12pF; C6_CAPC1005X60; MPN CL05C120JB5NNNC; LCSC C26406
C7: 12pF; C7_CAPC1005X60; MPN CL05C120JB5NNNC; LCSC C26406
C32: 1uF; C32_CAPC1005X60; MPN CL05A105KO5NNNC; LCSC C29266
C33: 10uF; C33_C_0603_1608Metric; MPN CL10A106KP8NNNC; LCSC C19702
C34: 10uF; C34_C_0603_1608Metric; MPN CL10A106KP8NNNC; LCSC C19702
C35: 0.1uF; C35_CAPC1005X60; MPN CL05B104KO5NNNC; LCSC C1525
C37: 0.1uF; C37_CAPC1005X60; MPN CL05B104KO5NNNC; LCSC C1525
C38: 0.1uF; C38_CAPC1005X60; MPN CL05B104KO5NNNC; LCSC C1525
C39: 0.1uF; C39_CAPC1005X60; MPN CL05B104KO5NNNC; LCSC C1525
C40: 0.1uF; C40_CAPC1005X60; MPN CL05B104KO5NNNC; LCSC C1525
C41: 0.1uF; C41_CAPC1005X60; MPN CL05B104KO5NNNC; LCSC C1525
C42: 0.1uF; C42_CAPC1005X60; MPN CL05B104KO5NNNC; LCSC C1525
C43: 10uF; C43_C_0603_1608Metric; MPN CL10A106KP8NNNC; LCSC C19702
C44: 0.1uF; C44_CAPC1005X60; MPN CL05B104KO5NNNC; LCSC C1525
C45: 10uF; C45_C_0603_1608Metric; MPN CL10A106KP8NNNC; LCSC C19702
C46: 0.1uF; C46_CAPC1005X60; MPN CL05B104KO5NNNC; LCSC C1525
C48: 0.1uF; C48_CAPC1005X60; MPN CL05B104KO5NNNC; LCSC C1525
C49: 0.1uF; C49_CAPC1005X60; MPN CL05B104KO5NNNC; LCSC C1525
C50: 0.1uF; C50_CAPC1005X60; MPN CL05B104KO5NNNC; LCSC C1525
C52: 0.1uF; C52_CAPC1005X60; MPN CL05B104KO5NNNC; LCSC C1525
C60: 10uF / 10V; C60_C_0603_1608Metric; MPN CL10A106KP8NNNC; LCSC C19702
C61: 22uF / 10V; C61_C_0603_1608Metric; MPN CL10A226MPCNUBE; LCSC C5355402
C62: 1uF / 6.3V; C62_C_0603_1608Metric; MPN CL10A105KB8NNNC; LCSC C15849
C63: 1uF / 6.3V; C63_C_0603_1608Metric; MPN CL10A105KB8NNNC; LCSC C15849
C66: 1uF / 6.3V; C66_C_0603_1608Metric; MPN CL10A105KB8NNNC; LCSC C15849
C67: 22uF / 10V; C67_C_0603_1608Metric; MPN CL10A226MPCNUBE; LCSC C5355402
D1: FC-B1010RGBT-HG; D1_RGBLED; MPN FC-B1010RGBT-HG; LCSC C158099
J1: DF40C(2.0)-40DS-0.4V(51); J1_DF40C_40DS_2mm; MPN DF40C(2.0)-40DS-0.4V(51); LCSC C597934
J2: DF40C-40DP-0.4V(51); J2_DF40C_40DP; MPN DF40C-40DP-0.4V(51); LCSC C424643
J3: U.FL-R-SMT-1(01); J3_U.FL_Hirose_U.FL-R-SMT-1_Vertical; MPN U.FL-R-SMT-1(01)
L1: 100ohm @100MHz; L1_L_0603_1608Metric; MPN BLM18KG101TN1D; LCSC C160981
L2: 100ohm @100MHz; L2_L_0603_1608Metric; MPN BLM18KG101TN1D; LCSC C160981
L3: 2.2nH; L3_INDC1006X60N; MPN LQG15HS2N2S02D; LCSC C86061
L4: 2.2uH; L4_L_XFL3012_222MEC; MPN XFL3012-222MEC; LCSC C3911432
R3: 0R; R3_RESC1005X40; MPN 0402WGF0000TCE; LCSC C17168
R20: 10kR; R20_RESC1005X40; MPN RC0402FR-0710KL; LCSC C60490
R22: 10kR; R22_RESC1005X40; MPN RC0402FR-0710KL; LCSC C60490
R28: 10kR; R28_RESC1005X40; MPN RC0402FR-0710KL; LCSC C60490
R29: 10kR; R29_RESC1005X40; MPN RC0402FR-0710KL; LCSC C60490
R62: 100kR; R62_R_0402_1005Metric; MPN RC0402FR-07100KL; LCSC C60491
R64: 75kR; R64_R_0402_1005Metric; MPN 0402WGF7502TCE; LCSC C25798
R65: 24kR; R65_R_0402_1005Metric; MPN 0402WGF2402TCE; LCSC C25769
TP1: FPGA_CRESET_N; TestPoint_0p8
TP2: FPGA_CDONE; TestPoint_0p8
U1: ESP32-S2FH4; U1_QFN56_ESP32-S2FH4_EXP-M; MPN ESP32-S2FH4; LCSC C2840995
U2: iCE40UP5K-SG48; U2_ICE40-QFN; MPN ICE40UP5K-SG48I; LCSC C2678152
U3: TPS62160DGKR; U3_VSSOP-8_3x3mm_P0.65mm; MPN TPS62160DGKR; LCSC C60726
U4: TLV75512PDBVR; U4_SOT-23-5; MPN TLV75512PDBVR; LCSC C2877864
Y1: 40MHz / CL10pF; Y1_JGHC_S2240000101050; MPN S2240000101050; LCSC C426970

Connections:
+1.2V: C45.1, C49.1, C50.1, C63.1, L2.1, U2.5 (VCC_1), U2.30 (VCC_2), U4.5 (OUT)
+1.2V_PLL: C43.1, C44.1, L2.2, U2.29 (VCCPLL)
+3.3V: C33.1, C37.1, C38.1, C39.1, C40.1, C41.1, C42.1, C46.1, C48.1, C52.1, C61.1, C62.1, C66.1, C67.1, D1.P$1 (A), L1.1, L4.2, R20.2, R22.2, R29.2, R62.2, R64.1, U1.1 (VDDA), U1.20 (VDD3P3_RTC), U1.27 (VDD3P3_RTC_IO), U1.30 (VDD_SPI), U1.45 (VDD3P3_CPU), U1.51 (VDDA_2), U1.54 (VDDA_3), U2.1 (VCCIO_2), U2.22 (SPI_VCCIO1), U2.24 (VPP_2V5), U2.33 (VCCIO_0), U3.6 (VOS), U4.1 (IN), U4.3 (EN)
/BUCK_FB: R64.2, R65.1, U3.5 (FB)
/BUCK_SW: L4.1, U3.7 (SW)
/ESP_EN: C32.1, J1.11, R22.1, U1.56 (CHIP_PU)
/ESP_GPIO0_BOOT: J1.12, R20.1, U1.5 (GPIO0)
/ESP_GPIO1: J1.13, U1.6 (GPIO1)
/ESP_GPIO2: J1.14, U1.7 (GPIO2)
/ESP_GPIO3: J1.15, U1.8 (GPIO3)
/ESP_GPIO4: J1.16, U1.9 (GPIO4)
/ESP_GPIO5: J1.17, U1.10 (GPIO5)
/ESP_GPIO6: J1.18, U1.11 (GPIO6)
/ESP_GPIO7: J1.19, U1.12 (GPIO7)
/ESP_GPIO8: J1.20, U1.13 (GPIO8)
/ESP_GPIO15: J1.35, U1.21 (GPIO15)
/ESP_GPIO16: J1.37, U1.22 (GPIO16)
/ESP_GPIO17: J1.36, U1.23 (GPIO17)
/ESP_GPIO18: J1.38, U1.24 (GPIO18)
/ESP_GPIO21: J1.40, U1.28 (GPIO21)
/ESP_GPIO33: J1.29, U1.37 (GPIO33)
/ESP_GPIO34: J1.32, U1.38 (GPIO34)
/ESP_GPIO35: J1.28, U1.39 (GPIO35)
/ESP_GPIO38: J1.39, U1.42 (GPIO38)
/ESP_GPIO39: J1.23, U1.43 (GPIO39)
/ESP_GPIO40: J1.21, U1.44 (GPIO40)
/ESP_GPIO41: J1.24, U1.46 (GPIO41)
/ESP_GPIO42: J1.25, U1.47 (GPIO42)
/ESP_GPIO43_TXD: J1.26, U1.48 (GPIO43)
/ESP_GPIO44_RXD: J1.27, U1.49 (GPIO44)
/ESP_GPIO45: J1.34, U1.50 (GPIO45)
/ESP_GPIO46: J1.33, U1.55 (GPIO46)
/FPGA_CDONE: R29.1, TP2.1, U1.41 (GPIO37), U2.7 (CDONE)
/FPGA_CRESET_N: R28.2, TP1.1, U1.40 (GPIO36), U2.8 (CRESET_B)
/FPGA_IOB_0A: J2.35, U2.46 (IOB_0A)
/FPGA_IOB_2A: J2.36, U2.47 (IOB_2A)
/FPGA_IOB_3B_G6: J2.32, U2.44 (IOB_3B_G6)
/FPGA_IOB_4A: J2.37, U2.48 (IOB_4A)
/FPGA_IOB_5B: J2.34, U2.45 (IOB_5B)
/FPGA_IOB_6A: J2.40, U2.2 (IOB_6A)
/FPGA_IOB_8A: J2.39, U2.4 (IOB_8A)
/FPGA_IOB_9B: J2.38, U2.3 (IOB_9B)
/FPGA_IOB_13B: J2.6, U2.6 (IOB_13B)
/FPGA_IOB_16A: J2.4, U2.9 (IOB_16A)
/FPGA_IOB_18A: J2.2, U2.10 (IOB_18A)
/FPGA_IOB_20A: J2.7, U2.11 (IOB_20A)
/FPGA_IOB_22A: J2.5, U2.12 (IOB_22A)
/FPGA_IOB_23B: J2.10, U2.21 (IOB_23B)
/FPGA_IOB_25B_G3: J2.12, U2.20 (IOB_25B_G3)
/FPGA_IOB_29B: J2.11, U2.19 (IOB_29B)
/FPGA_IOT_36B: J2.14, U2.25 (IOT_36B)
/FPGA_IOT_37A: J2.9, U2.23 (IOT_37A)
/FPGA_IOT_38B: J2.15, U2.27 (IOT_38B)
/FPGA_IOT_39A: J2.16, U2.26 (IOT_39A)
/FPGA_IOT_41A: J2.17, U2.28 (IOT_41A)
/FPGA_IOT_42B: J2.19, U2.31 (IOT_42B)
/FPGA_IOT_43A: J2.20, U2.32 (IOT_43A)
/FPGA_IOT_44B: J2.33, U2.34 (IOT_44B)
/FPGA_IOT_45A_G1: J2.24, U2.37 (IOT_45A_G1)
/FPGA_IOT_46B_G0: J2.22, U2.35 (IOT_46B_G0)
/FPGA_IOT_48B: J2.21, U2.36 (IOT_48B)
/FPGA_IOT_49A: J2.31, U2.43 (IOT_49A)
/FPGA_IOT_50B: J2.25, U2.38 (IOT_50B)
/FPGA_IOT_51A: J2.30, U2.42 (IOT_51A)
/FPGA_RGB0: D1.P$2 (K_RGB0), J2.26, U2.39 (RGB0)
/FPGA_RGB1: D1.P$3 (K_RGB1), J2.27, U2.40 (RGB1)
/FPGA_RGB2: D1.P$4 (K_RGB2), J2.29, U2.41 (RGB2)
/LINK_CS_N: U1.15 (GPIO10), U2.16 (IOB_35B_SPI_SS)
/LINK_IO2: U1.19 (GPIO14), U2.13 (IOB_24A)
/LINK_IO3: U1.14 (GPIO9), U2.18 (IOB_31B)
/LINK_MISO: U1.18 (GPIO13), U2.14 (IOB_32A_SPI_SO)
/LINK_MOSI: U1.16 (GPIO11), U2.17 (IOB_33B_SPI_SI)
/LINK_SCK: U1.17 (GPIO12), U2.15 (IOB_34A_SPI_SCK)
/PG_3V3: R62.1, U3.8 (PG)
/RF_ANT: C2.1, J3.1 (RF), L3.2
/RF_IN: C1.1, L3.1, U1.2 (LNA_IN)
/USB_D+: J1.7, U1.26 (GPIO20/USB_D+)
/USB_D-: J1.8, U1.25 (GPIO19/USB_D-)
/XTAL_N: C7.1, U1.52 (XTAL_N), Y1.OUT/IN
/XTAL_P: R3.1, U1.53 (XTAL_P)
/XTAL_P_CRYSTAL: C6.1, R3.2, Y1.IN/OUT
ESP_VDD3P3: C34.1, C35.1, L1.2, U1.3 (VDD3P3), U1.4 (VDD3P3_2)
GND: C1.2, C2.2, C6.2, C7.2, C32.2, C33.2, C34.2, C35.2, C37.2, C38.2, C39.2, C40.2, C41.2, C42.2, C43.2, C44.2, C45.2, C46.2, C48.2, C49.2, C50.2, C52.2, C60.2, C61.2, C62.2, C63.2, C66.2, C67.2, J1.5, J1.6, J1.9, J1.10, J1.22, J1.30, J1.31, J2.1, J2.3, J2.8, J2.13, J2.18, J2.23, J2.28, J3.2 (GND), R28.1, R65.2, U1.57 (EPAD), U2.PAD, U3.1 (PGND), U3.4 (AGND), U4.2 (GND), Y1.GND-A (GND), Y1.GND-B (GND)
VIN_5V: C60.1, J1.1, J1.2, J1.3, J1.4, U3.2 (VIN), U3.3 (EN)

Notes on the sheet:
ESP32-S2 + iCE40UP5K | Development module | Rev A
ESP32 / integrated flash
FPGA / shared processor interface
Motherboard connectors
40 MHz crystal
RF matching / external antenna
U.FL external antenna required for Wi-Fi.
Boot and reset defaults
RGB status indicator
3.3 V buck regulator / 5 V input
1.2 V LDO / FPGA core supply
ESP32 supply filtering / decoupling
FPGA supply filtering / decoupling
FPGA debug test points
ESP32 pi filter: U1 pins 3, 4.
PLL pi filter: U2 pin 29.
ESP32 3.3 V decoupling
Core: U2 pins 5, 30
Fixed 3.3 V supplies
Bank 0: U2 pin 33

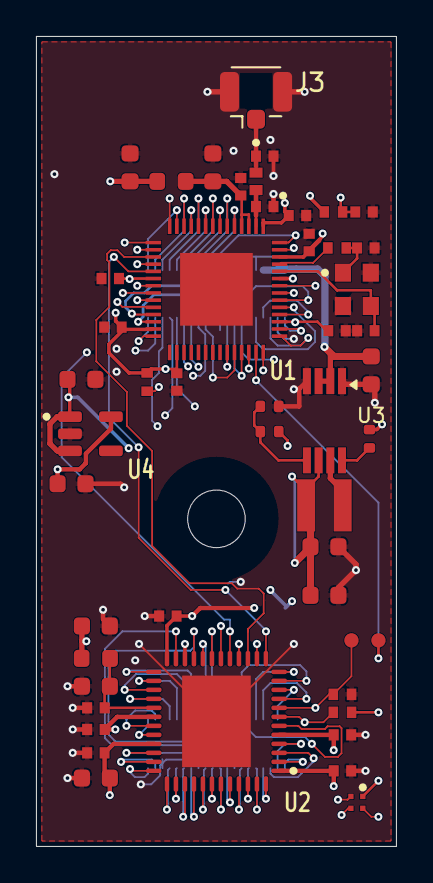
[picture p28: board current-df40-connectors/module.kicad_pcb from above]

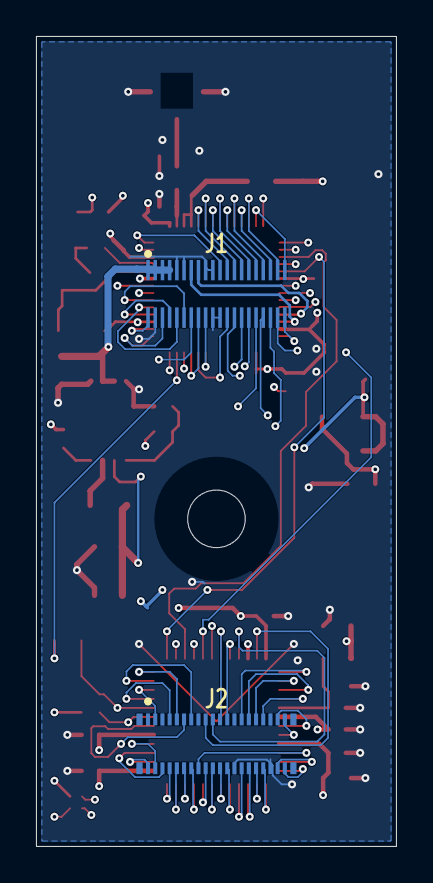
[picture p29: board current-df40-connectors/module.kicad_pcb from below]

Board: 4 copper layers, 20.0 x 45.0 mm, 52 parts (2 on the bottom side), 84 nets.

Other parts of the board:
H1: MountingHole_3.2mm_M3
