OrbitalCommons/gumstick/programming-carrier/carrier.kicad_pcb

## KiCad design programming-carrier/carrier.kicad_pcb (2026-10-06)

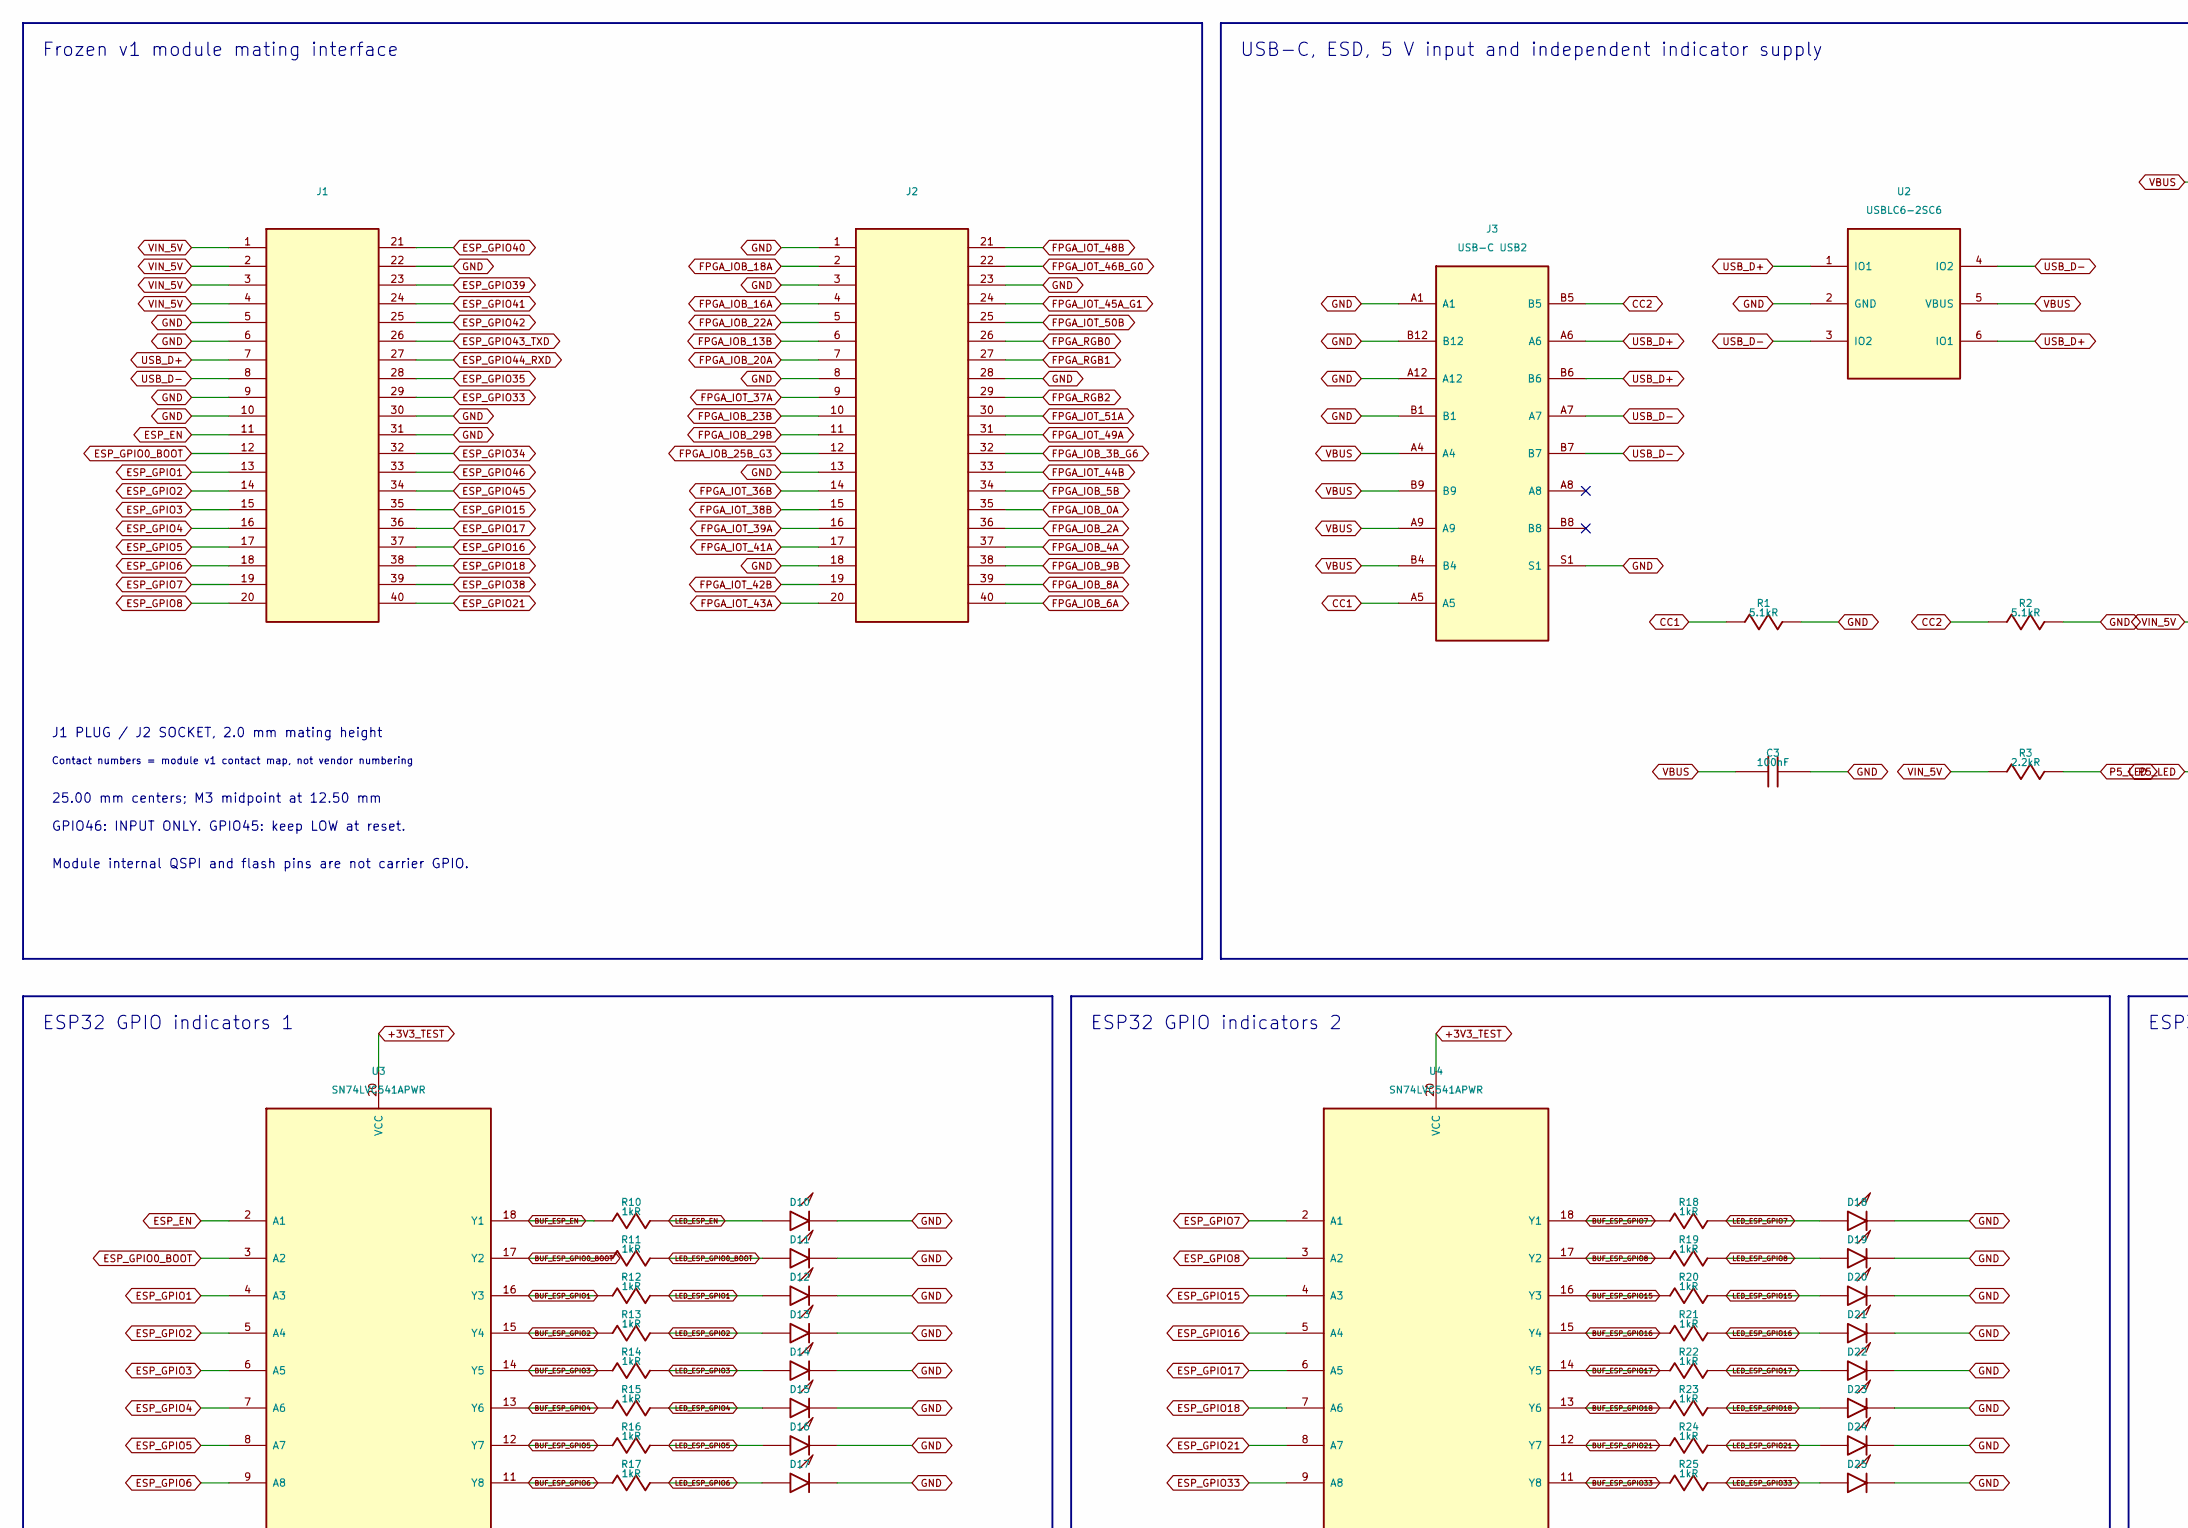
[picture p30: schematic carrier.kicad_sch, Module v1 programming and GPIO test carrier, part in row 1, column 1]

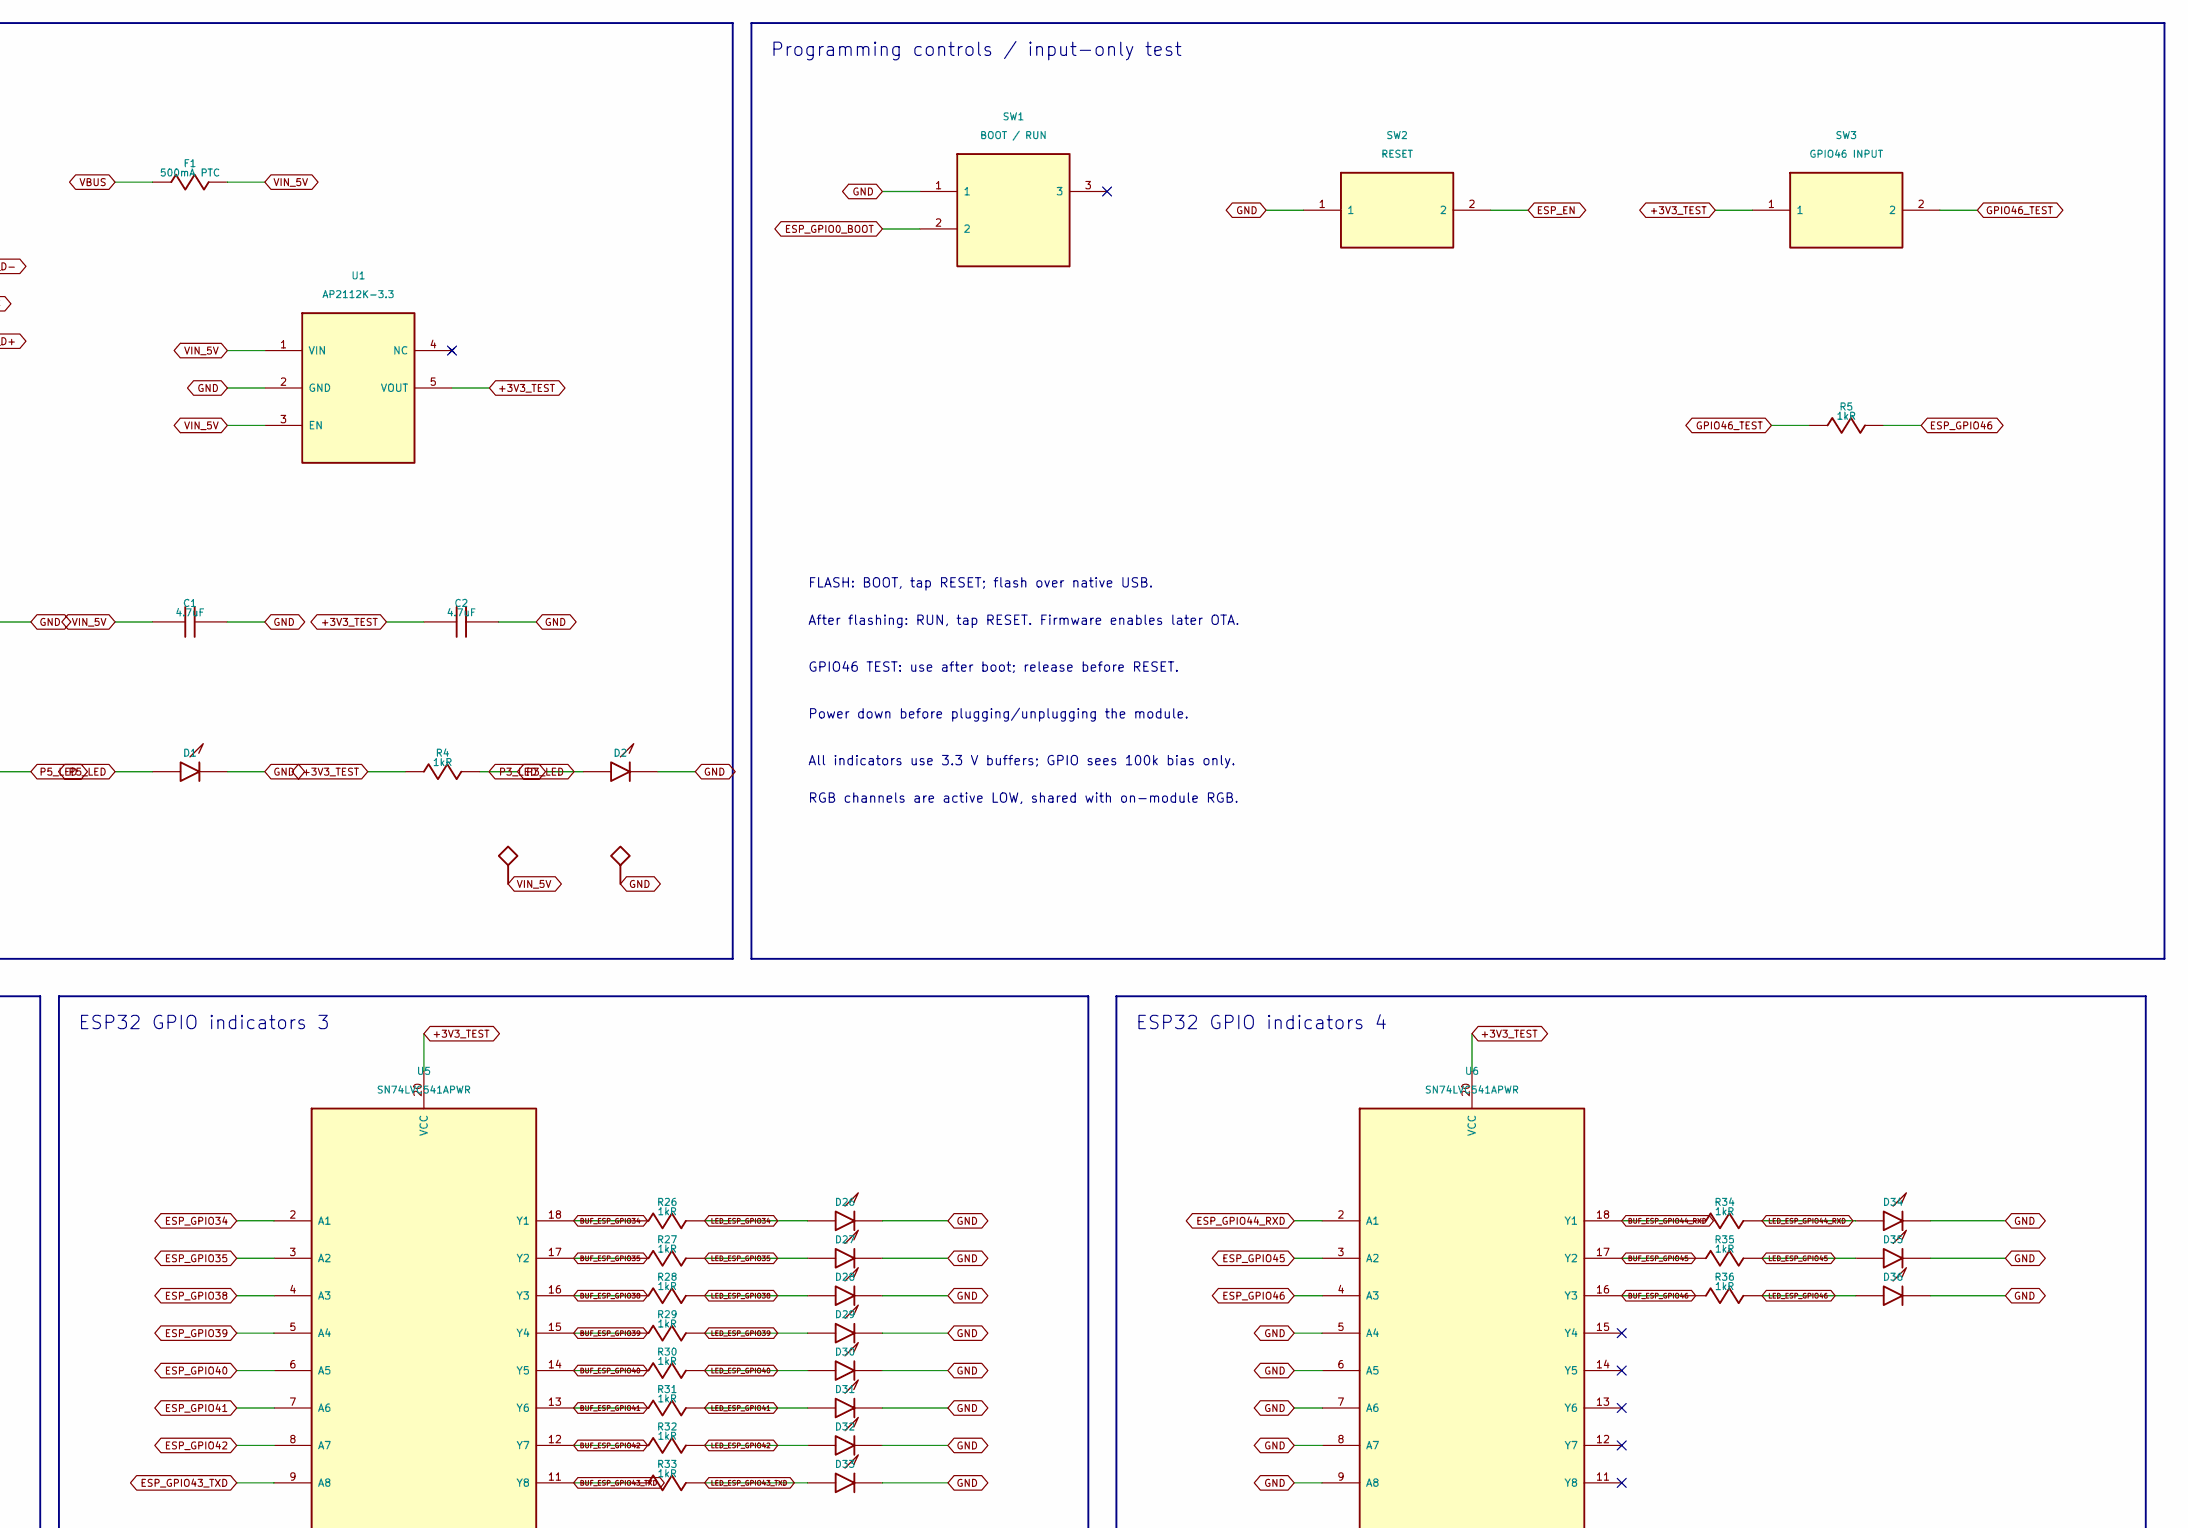
[picture p31: schematic carrier.kicad_sch, Module v1 programming and GPIO test carrier, part in row 1, column 2]

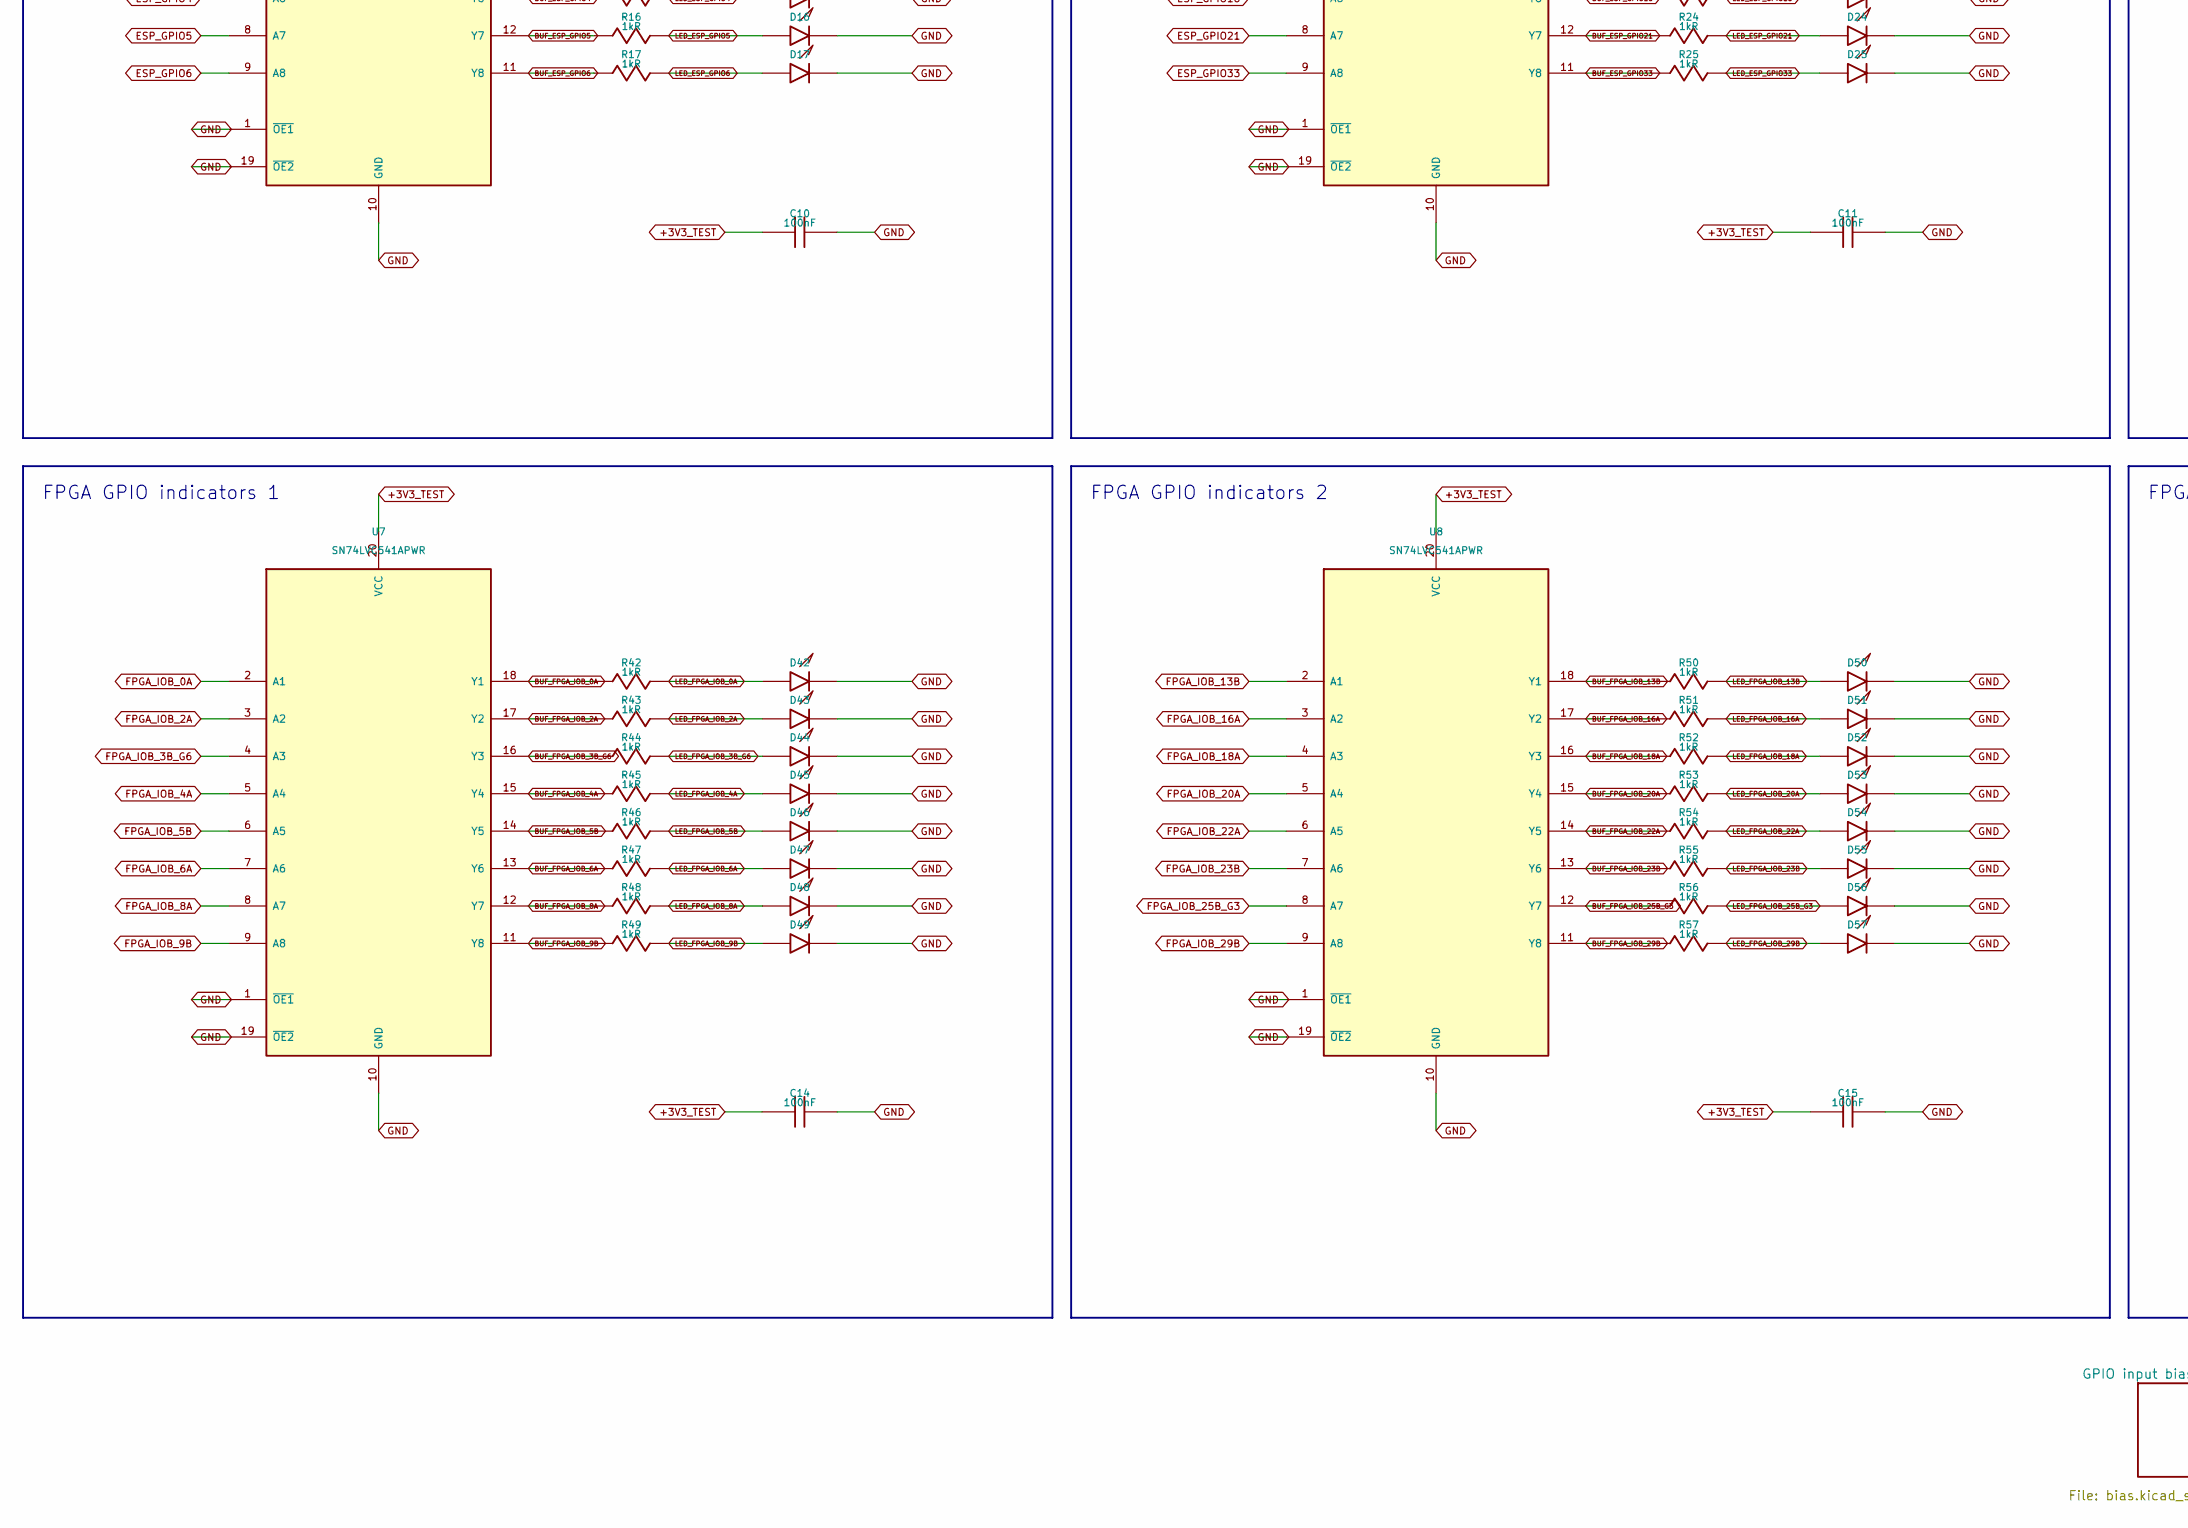
[picture p32: schematic carrier.kicad_sch, Module v1 programming and GPIO test carrier, part in row 2, column 1]

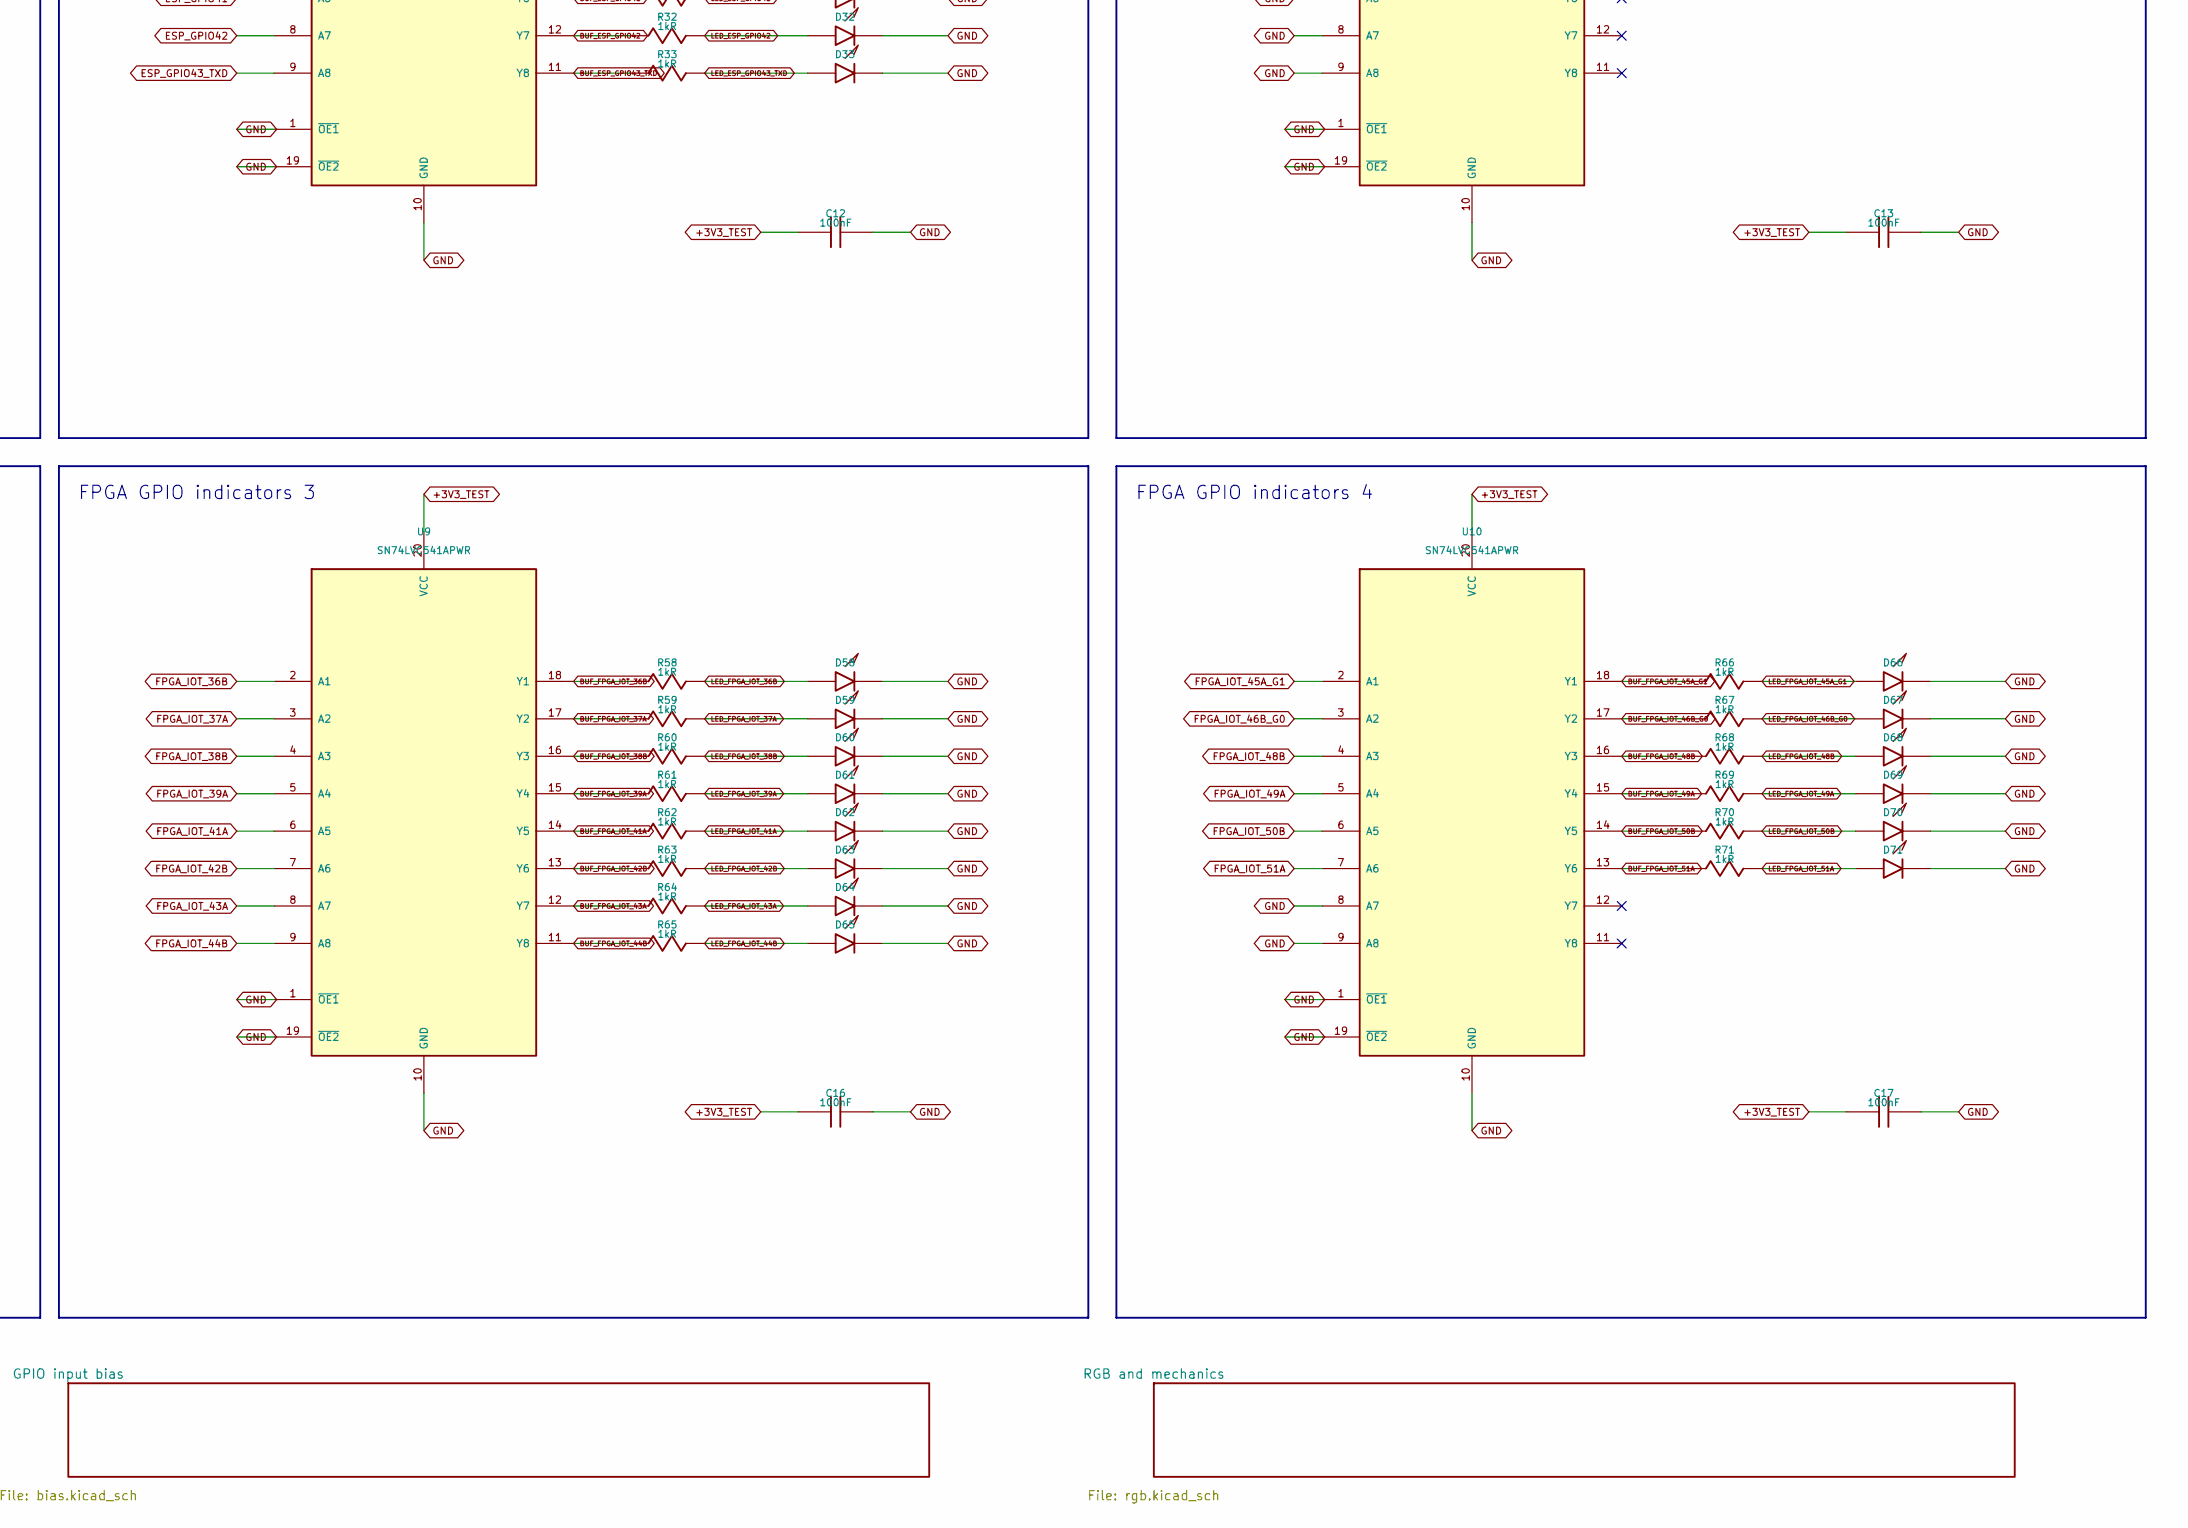
[picture p33: schematic carrier.kicad_sch, Module v1 programming and GPIO test carrier, part in row 2, column 2]

Parts:
C1, C2: 4.7uF; C_0603_1608Metric; MPN CL10A475KO8NNNC; LCSC C19666
C3, C10, C11, C12, C13, C14, C15, C16, C17: 100nF; C_0603_1608Metric; MPN CC0603KRX7R9BB104; LCSC C14663
D1, D2, D10, D11, D12, D13, D14, D15, D16, D17, D18, D19, D20, D21, D22, D23, D24, D25, D26, D27, D28, D29, D30, D31, D32, D33, D34, D35, D36, D42, D43, D44, D45, D46, D47, D48, D49, D50, D51, D52, D53, D54, D55, D56, D57, D58, D59, D60, D61, D62, D63, D64, D65, D66, D67, D68, D69, D70, D71: GREEN; LED_0603_1608Metric; MPN XL-1608SYGC-06; LCSC C965805
F1: 500mA PTC; Fuse_1206_3216Metric; MPN 1206L050/15YR; LCSC C151162
J1: DF40C-40DP-0.4V(51); J1_Module_v1_Mate; MPN DF40C-40DP-0.4V(51); LCSC C424643
J2: DF40C(2.0)-40DS-0.4V(51); J2_Module_v1_Mate; MPN DF40C(2.0)-40DS-0.4V(51); LCSC C597934
J3: USB-C USB2; USB_C_Receptacle_HRO_TYPE-C-31-M-12; MPN TYPE-C-31-M-12; LCSC C165948
R1, R2: 5.1kR; R_0603_1608Metric; MPN 0603WAF5101T5E; LCSC C23186
R3: 2.2kR; R_0603_1608Metric; MPN 0603WAF2201T5E; LCSC C4190
R4, R5, R10, R11, R12, R13, R14, R15, R16, R17, R18, R19, R20, R21, R22, R23, R24, R25, R26, R27, R28, R29, R30, R31, R32, R33, R34, R35, R36, R42, R43, R44, R45, R46, R47, R48, R49, R50, R51, R52, R53, R54, R55, R56, R57, R58, R59, R60, R61, R62, R63, R64, R65, R66, R67, R68, R69, R70, R71: 1kR; R_0603_1608Metric; MPN 0603WAF1001T5E; LCSC C21190
SW1: BOOT / RUN; SW_SPDT_CK_JS102011SAQN; MPN JS102011SAQN; LCSC C221660
SW2: RESET; SW_SPST_TL3342; MPN TL3342F160QG; LCSC C2886898
SW3: GPIO46 INPUT; SW_SPST_TL3342; MPN TL3342F160QG; LCSC C2886898
U1: AP2112K-3.3; SOT-23-5; MPN AP2112K-3.3TRG1; LCSC C51118
U2: USBLC6-2SC6; SOT-23-6; MPN USBLC6-2SC6; LCSC C7519
U3, U4, U5, U6, U7, U8, U9, U10: SN74LVC541APWR; TSSOP-20_4.4x6.5mm_P0.65mm; MPN SN74LVC541APWR; LCSC C113281

Connections:
+3V3_TEST: C2.1, C10.1, C11.1, C12.1, C13.1, C14.1, C15.1, C16.1, C17.1, R4.1, SW3.1, U1.5 (VOUT), U3.20 (VCC), U4.20 (VCC), U5.20 (VCC), U6.20 (VCC), U7.20 (VCC), U8.20 (VCC), U9.20 (VCC), U10.20 (VCC); also elsewhere on the board
BUF_ESP_EN: R10.1, U3.18 (Y1)
BUF_ESP_GPIO0_BOOT: R11.1, U3.17 (Y2)
BUF_ESP_GPIO1: R12.1, U3.16 (Y3)
BUF_ESP_GPIO2: R13.1, U3.15 (Y4)
BUF_ESP_GPIO3: R14.1, U3.14 (Y5)
BUF_ESP_GPIO4: R15.1, U3.13 (Y6)
BUF_ESP_GPIO5: R16.1, U3.12 (Y7)
BUF_ESP_GPIO6: R17.1, U3.11 (Y8)
BUF_ESP_GPIO7: R18.1, U4.18 (Y1)
BUF_ESP_GPIO8: R19.1, U4.17 (Y2)
BUF_ESP_GPIO15: R20.1, U4.16 (Y3)
BUF_ESP_GPIO16: R21.1, U4.15 (Y4)
BUF_ESP_GPIO17: R22.1, U4.14 (Y5)
BUF_ESP_GPIO18: R23.1, U4.13 (Y6)
BUF_ESP_GPIO21: R24.1, U4.12 (Y7)
BUF_ESP_GPIO33: R25.1, U4.11 (Y8)
BUF_ESP_GPIO34: R26.1, U5.18 (Y1)
BUF_ESP_GPIO35: R27.1, U5.17 (Y2)
BUF_ESP_GPIO38: R28.1, U5.16 (Y3)
BUF_ESP_GPIO39: R29.1, U5.15 (Y4)
BUF_ESP_GPIO40: R30.1, U5.14 (Y5)
BUF_ESP_GPIO41: R31.1, U5.13 (Y6)
BUF_ESP_GPIO42: R32.1, U5.12 (Y7)
BUF_ESP_GPIO43_TXD: R33.1, U5.11 (Y8)
BUF_ESP_GPIO44_RXD: R34.1, U6.18 (Y1)
BUF_ESP_GPIO45: R35.1, U6.17 (Y2)
BUF_ESP_GPIO46: R36.1, U6.16 (Y3)
BUF_FPGA_IOB_0A: R42.1, U7.18 (Y1)
BUF_FPGA_IOB_2A: R43.1, U7.17 (Y2)
BUF_FPGA_IOB_3B_G6: R44.1, U7.16 (Y3)
BUF_FPGA_IOB_4A: R45.1, U7.15 (Y4)
BUF_FPGA_IOB_5B: R46.1, U7.14 (Y5)
BUF_FPGA_IOB_6A: R47.1, U7.13 (Y6)
BUF_FPGA_IOB_8A: R48.1, U7.12 (Y7)
BUF_FPGA_IOB_9B: R49.1, U7.11 (Y8)
BUF_FPGA_IOB_13B: R50.1, U8.18 (Y1)
BUF_FPGA_IOB_16A: R51.1, U8.17 (Y2)
BUF_FPGA_IOB_18A: R52.1, U8.16 (Y3)
BUF_FPGA_IOB_20A: R53.1, U8.15 (Y4)
BUF_FPGA_IOB_22A: R54.1, U8.14 (Y5)
BUF_FPGA_IOB_23B: R55.1, U8.13 (Y6)
BUF_FPGA_IOB_25B_G3: R56.1, U8.12 (Y7)
BUF_FPGA_IOB_29B: R57.1, U8.11 (Y8)
BUF_FPGA_IOT_36B: R58.1, U9.18 (Y1)
BUF_FPGA_IOT_37A: R59.1, U9.17 (Y2)
BUF_FPGA_IOT_38B: R60.1, U9.16 (Y3)
BUF_FPGA_IOT_39A: R61.1, U9.15 (Y4)
BUF_FPGA_IOT_41A: R62.1, U9.14 (Y5)
BUF_FPGA_IOT_42B: R63.1, U9.13 (Y6)
BUF_FPGA_IOT_43A: R64.1, U9.12 (Y7)
BUF_FPGA_IOT_44B: R65.1, U9.11 (Y8)
BUF_FPGA_IOT_45A_G1: R66.1, U10.18 (Y1)
BUF_FPGA_IOT_46B_G0: R67.1, U10.17 (Y2)
BUF_FPGA_IOT_48B: R68.1, U10.16 (Y3)
BUF_FPGA_IOT_49A: R69.1, U10.15 (Y4)
BUF_FPGA_IOT_50B: R70.1, U10.14 (Y5)
BUF_FPGA_IOT_51A: R71.1, U10.13 (Y6)
CC1: J3.A5, R1.1
CC2: J3.B5, R2.1
ESP_EN: J1.11, SW2.2, U3.2 (A1); also elsewhere on the board
ESP_GPIO0_BOOT: J1.12, SW1.2, U3.3 (A2); also elsewhere on the board
ESP_GPIO1: J1.13, U3.4 (A3); also elsewhere on the board
ESP_GPIO2: J1.14, U3.5 (A4); also elsewhere on the board
ESP_GPIO3: J1.15, U3.6 (A5); also elsewhere on the board
ESP_GPIO4: J1.16, U3.7 (A6); also elsewhere on the board
ESP_GPIO5: J1.17, U3.8 (A7); also elsewhere on the board
ESP_GPIO6: J1.18, U3.9 (A8); also elsewhere on the board
ESP_GPIO7: J1.19, U4.2 (A1); also elsewhere on the board
ESP_GPIO8: J1.20, U4.3 (A2); also elsewhere on the board
ESP_GPIO15: J1.35, U4.4 (A3); also elsewhere on the board
ESP_GPIO16: J1.37, U4.5 (A4); also elsewhere on the board
ESP_GPIO17: J1.36, U4.6 (A5); also elsewhere on the board
ESP_GPIO18: J1.38, U4.7 (A6); also elsewhere on the board
ESP_GPIO21: J1.40, U4.8 (A7); also elsewhere on the board
ESP_GPIO33: J1.29, U4.9 (A8); also elsewhere on the board
ESP_GPIO34: J1.32, U5.2 (A1); also elsewhere on the board
ESP_GPIO35: J1.28, U5.3 (A2); also elsewhere on the board
ESP_GPIO38: J1.39, U5.4 (A3); also elsewhere on the board
ESP_GPIO39: J1.23, U5.5 (A4); also elsewhere on the board
ESP_GPIO40: J1.21, U5.6 (A5); also elsewhere on the board
ESP_GPIO41: J1.24, U5.7 (A6); also elsewhere on the board
ESP_GPIO42: J1.25, U5.8 (A7); also elsewhere on the board
ESP_GPIO43_TXD: J1.26, U5.9 (A8); also elsewhere on the board
ESP_GPIO44_RXD: J1.27, U6.2 (A1); also elsewhere on the board
ESP_GPIO45: J1.34, U6.3 (A2); also elsewhere on the board
ESP_GPIO46: J1.33, R5.2, U6.4 (A3); also elsewhere on the board
FPGA_IOB_0A: J2.35, U7.2 (A1); also elsewhere on the board
FPGA_IOB_2A: J2.36, U7.3 (A2); also elsewhere on the board
FPGA_IOB_3B_G6: J2.32, U7.4 (A3); also elsewhere on the board
FPGA_IOB_4A: J2.37, U7.5 (A4); also elsewhere on the board
FPGA_IOB_5B: J2.34, U7.6 (A5); also elsewhere on the board
FPGA_IOB_6A: J2.40, U7.7 (A6); also elsewhere on the board
FPGA_IOB_8A: J2.39, U7.8 (A7); also elsewhere on the board
FPGA_IOB_9B: J2.38, U7.9 (A8); also elsewhere on the board
FPGA_IOB_13B: J2.6, U8.2 (A1); also elsewhere on the board
FPGA_IOB_16A: J2.4, U8.3 (A2); also elsewhere on the board
FPGA_IOB_18A: J2.2, U8.4 (A3); also elsewhere on the board
FPGA_IOB_20A: J2.7, U8.5 (A4); also elsewhere on the board
FPGA_IOB_22A: J2.5, U8.6 (A5); also elsewhere on the board
FPGA_IOB_23B: J2.10, U8.7 (A6); also elsewhere on the board
FPGA_IOB_25B_G3: J2.12, U8.8 (A7); also elsewhere on the board
FPGA_IOB_29B: J2.11, U8.9 (A8); also elsewhere on the board
FPGA_IOT_36B: J2.14, U9.2 (A1); also elsewhere on the board
FPGA_IOT_37A: J2.9, U9.3 (A2); also elsewhere on the board
FPGA_IOT_38B: J2.15, U9.4 (A3); also elsewhere on the board
FPGA_IOT_39A: J2.16, U9.5 (A4); also elsewhere on the board
FPGA_IOT_41A: J2.17, U9.6 (A5); also elsewhere on the board
FPGA_IOT_42B: J2.19, U9.7 (A6); also elsewhere on the board
FPGA_IOT_43A: J2.20, U9.8 (A7); also elsewhere on the board
FPGA_IOT_44B: J2.33, U9.9 (A8); also elsewhere on the board
FPGA_IOT_45A_G1: J2.24, U10.2 (A1); also elsewhere on the board
FPGA_IOT_46B_G0: J2.22, U10.3 (A2); also elsewhere on the board
FPGA_IOT_48B: J2.21, U10.4 (A3); also elsewhere on the board
FPGA_IOT_49A: J2.31, U10.5 (A4); also elsewhere on the board
FPGA_IOT_50B: J2.25, U10.6 (A5); also elsewhere on the board
FPGA_IOT_51A: J2.30, U10.7 (A6); also elsewhere on the board
FPGA_RGB0: J2.26; also elsewhere on the board
FPGA_RGB1: J2.27; also elsewhere on the board
FPGA_RGB2: J2.29; also elsewhere on the board
GND: C1.2, C2.2, C3.2, C10.2, C11.2, C12.2, C13.2, C14.2, C15.2, C16.2, C17.2, D1.1, D2.1, D10.1, D11.1, D12.1, D13.1, D14.1, D15.1, D16.1, D17.1, D18.1, D19.1, D20.1, D21.1, D22.1, D23.1, D24.1, D25.1, D26.1, D27.1, D28.1, D29.1, D30.1, D31.1, D32.1, D33.1, D34.1, D35.1, D36.1, D42.1, D43.1, D44.1, D45.1, D46.1, D47.1, D48.1, D49.1, D50.1, D51.1, D52.1, D53.1, D54.1, D55.1, D56.1, D57.1, D58.1, D59.1, D60.1, D61.1, D62.1, D63.1, D64.1, D65.1, D66.1, D67.1, D68.1, D69.1, D70.1, D71.1, J1.5, J1.6, J1.9, J1.10, J1.22, J1.30, J1.31, J2.1, J2.3, J2.8, J2.13, J2.18, J2.23, J2.28, J3.A1, J3.A12, J3.B1, J3.B12, J3.S1, R1.2, R2.2, SW1.1, SW2.1, U1.2 (GND), U2.2 (GND), U3.1 (~OE1), U3.10 (GND), U3.19 (~OE2), U4.1 (~OE1), U4.10 (GND), U4.19 (~OE2), U5.1 (~OE1), U5.10 (GND), U5.19 (~OE2), U6.1 (~OE1), U6.5 (A4), U6.6 (A5), U6.7 (A6), U6.8 (A7), U6.9 (A8), U6.10 (GND), U6.19 (~OE2), U7.1 (~OE1), U7.10 (GND), U7.19 (~OE2), U8.1 (~OE1), U8.10 (GND), U8.19 (~OE2), U9.1 (~OE1), U9.10 (GND), U9.19 (~OE2), U10.1 (~OE1), U10.8 (A7), U10.9 (A8), U10.10 (GND), U10.19 (~OE2); also elsewhere on the board
GPIO46_TEST: R5.1, SW3.2
LED_ESP_EN: D10.2, R10.2
LED_ESP_GPIO0_BOOT: D11.2, R11.2
LED_ESP_GPIO1: D12.2, R12.2
LED_ESP_GPIO2: D13.2, R13.2
LED_ESP_GPIO3: D14.2, R14.2
LED_ESP_GPIO4: D15.2, R15.2
LED_ESP_GPIO5: D16.2, R16.2
LED_ESP_GPIO6: D17.2, R17.2
LED_ESP_GPIO7: D18.2, R18.2
LED_ESP_GPIO8: D19.2, R19.2
LED_ESP_GPIO15: D20.2, R20.2
LED_ESP_GPIO16: D21.2, R21.2
LED_ESP_GPIO17: D22.2, R22.2
LED_ESP_GPIO18: D23.2, R23.2
LED_ESP_GPIO21: D24.2, R24.2
LED_ESP_GPIO33: D25.2, R25.2
LED_ESP_GPIO34: D26.2, R26.2
LED_ESP_GPIO35: D27.2, R27.2
LED_ESP_GPIO38: D28.2, R28.2
LED_ESP_GPIO39: D29.2, R29.2
LED_ESP_GPIO40: D30.2, R30.2
LED_ESP_GPIO41: D31.2, R31.2
LED_ESP_GPIO42: D32.2, R32.2
LED_ESP_GPIO43_TXD: D33.2, R33.2
LED_ESP_GPIO44_RXD: D34.2, R34.2
LED_ESP_GPIO45: D35.2, R35.2
LED_ESP_GPIO46: D36.2, R36.2
LED_FPGA_IOB_0A: D42.2, R42.2
LED_FPGA_IOB_2A: D43.2, R43.2
LED_FPGA_IOB_3B_G6: D44.2, R44.2
LED_FPGA_IOB_4A: D45.2, R45.2
LED_FPGA_IOB_5B: D46.2, R46.2
LED_FPGA_IOB_6A: D47.2, R47.2
LED_FPGA_IOB_8A: D48.2, R48.2
LED_FPGA_IOB_9B: D49.2, R49.2
LED_FPGA_IOB_13B: D50.2, R50.2
LED_FPGA_IOB_16A: D51.2, R51.2
LED_FPGA_IOB_18A: D52.2, R52.2
LED_FPGA_IOB_20A: D53.2, R53.2
LED_FPGA_IOB_22A: D54.2, R54.2
LED_FPGA_IOB_23B: D55.2, R55.2
LED_FPGA_IOB_25B_G3: D56.2, R56.2
LED_FPGA_IOB_29B: D57.2, R57.2
LED_FPGA_IOT_36B: D58.2, R58.2
LED_FPGA_IOT_37A: D59.2, R59.2
LED_FPGA_IOT_38B: D60.2, R60.2
LED_FPGA_IOT_39A: D61.2, R61.2
LED_FPGA_IOT_41A: D62.2, R62.2
LED_FPGA_IOT_42B: D63.2, R63.2
LED_FPGA_IOT_43A: D64.2, R64.2
LED_FPGA_IOT_44B: D65.2, R65.2
LED_FPGA_IOT_45A_G1: D66.2, R66.2
LED_FPGA_IOT_46B_G0: D67.2, R67.2
LED_FPGA_IOT_48B: D68.2, R68.2
LED_FPGA_IOT_49A: D69.2, R69.2
LED_FPGA_IOT_50B: D70.2, R70.2
LED_FPGA_IOT_51A: D71.2, R71.2
P3_LED: D2.2, R4.2
P5_LED: D1.2, R3.2
USB_D+: J1.7, J3.A6, J3.B6, U2.1 (IO1), U2.6 (IO1)
USB_D-: J1.8, J3.A7, J3.B7, U2.3 (IO2), U2.4 (IO2)
VBUS: C3.1, F1.1, J3.A4, J3.A9, J3.B4, J3.B9, U2.5 (VBUS)
VIN_5V: C1.1, F1.2, J1.1, J1.2, J1.3, J1.4, R3.1, U1.1 (VIN), U1.3 (EN)

Notes on the sheet:
Frozen v1 module mating interface
J1 PLUG / J2 SOCKET, 2.0 mm mating height
Contact numbers = module v1 contact map, not vendor numbering
25.00 mm centers; M3 midpoint at 12.50 mm
GPIO46: INPUT ONLY. GPIO45: keep LOW at reset.
Module internal QSPI and flash pins are not carrier GPIO.
USB-C, ESD, 5 V input and independent indicator supply
Programming controls / input-only test
FLASH: BOOT, tap RESET; flash over native USB.
After flashing: RUN, tap RESET. Firmware enables later OTA.
GPIO46 TEST: use after boot; release before RESET.
Power down before plugging/unplugging the module.
All indicators use 3.3 V buffers; GPIO sees 100k bias only.
RGB channels are active LOW, shared with on-module RGB.
ESP32 GPIO indicators 1
ESP32 GPIO indicators 2
ESP32 GPIO indicators 3
ESP32 GPIO indicators 4
FPGA GPIO indicators 1
FPGA GPIO indicators 2
FPGA GPIO indicators 3
FPGA GPIO indicators 4
