OrbitalCommons/gumstick/programming-carrier/carrier.kicad_pcb

## KiCad design programming-carrier/carrier.kicad_pcb (continued)

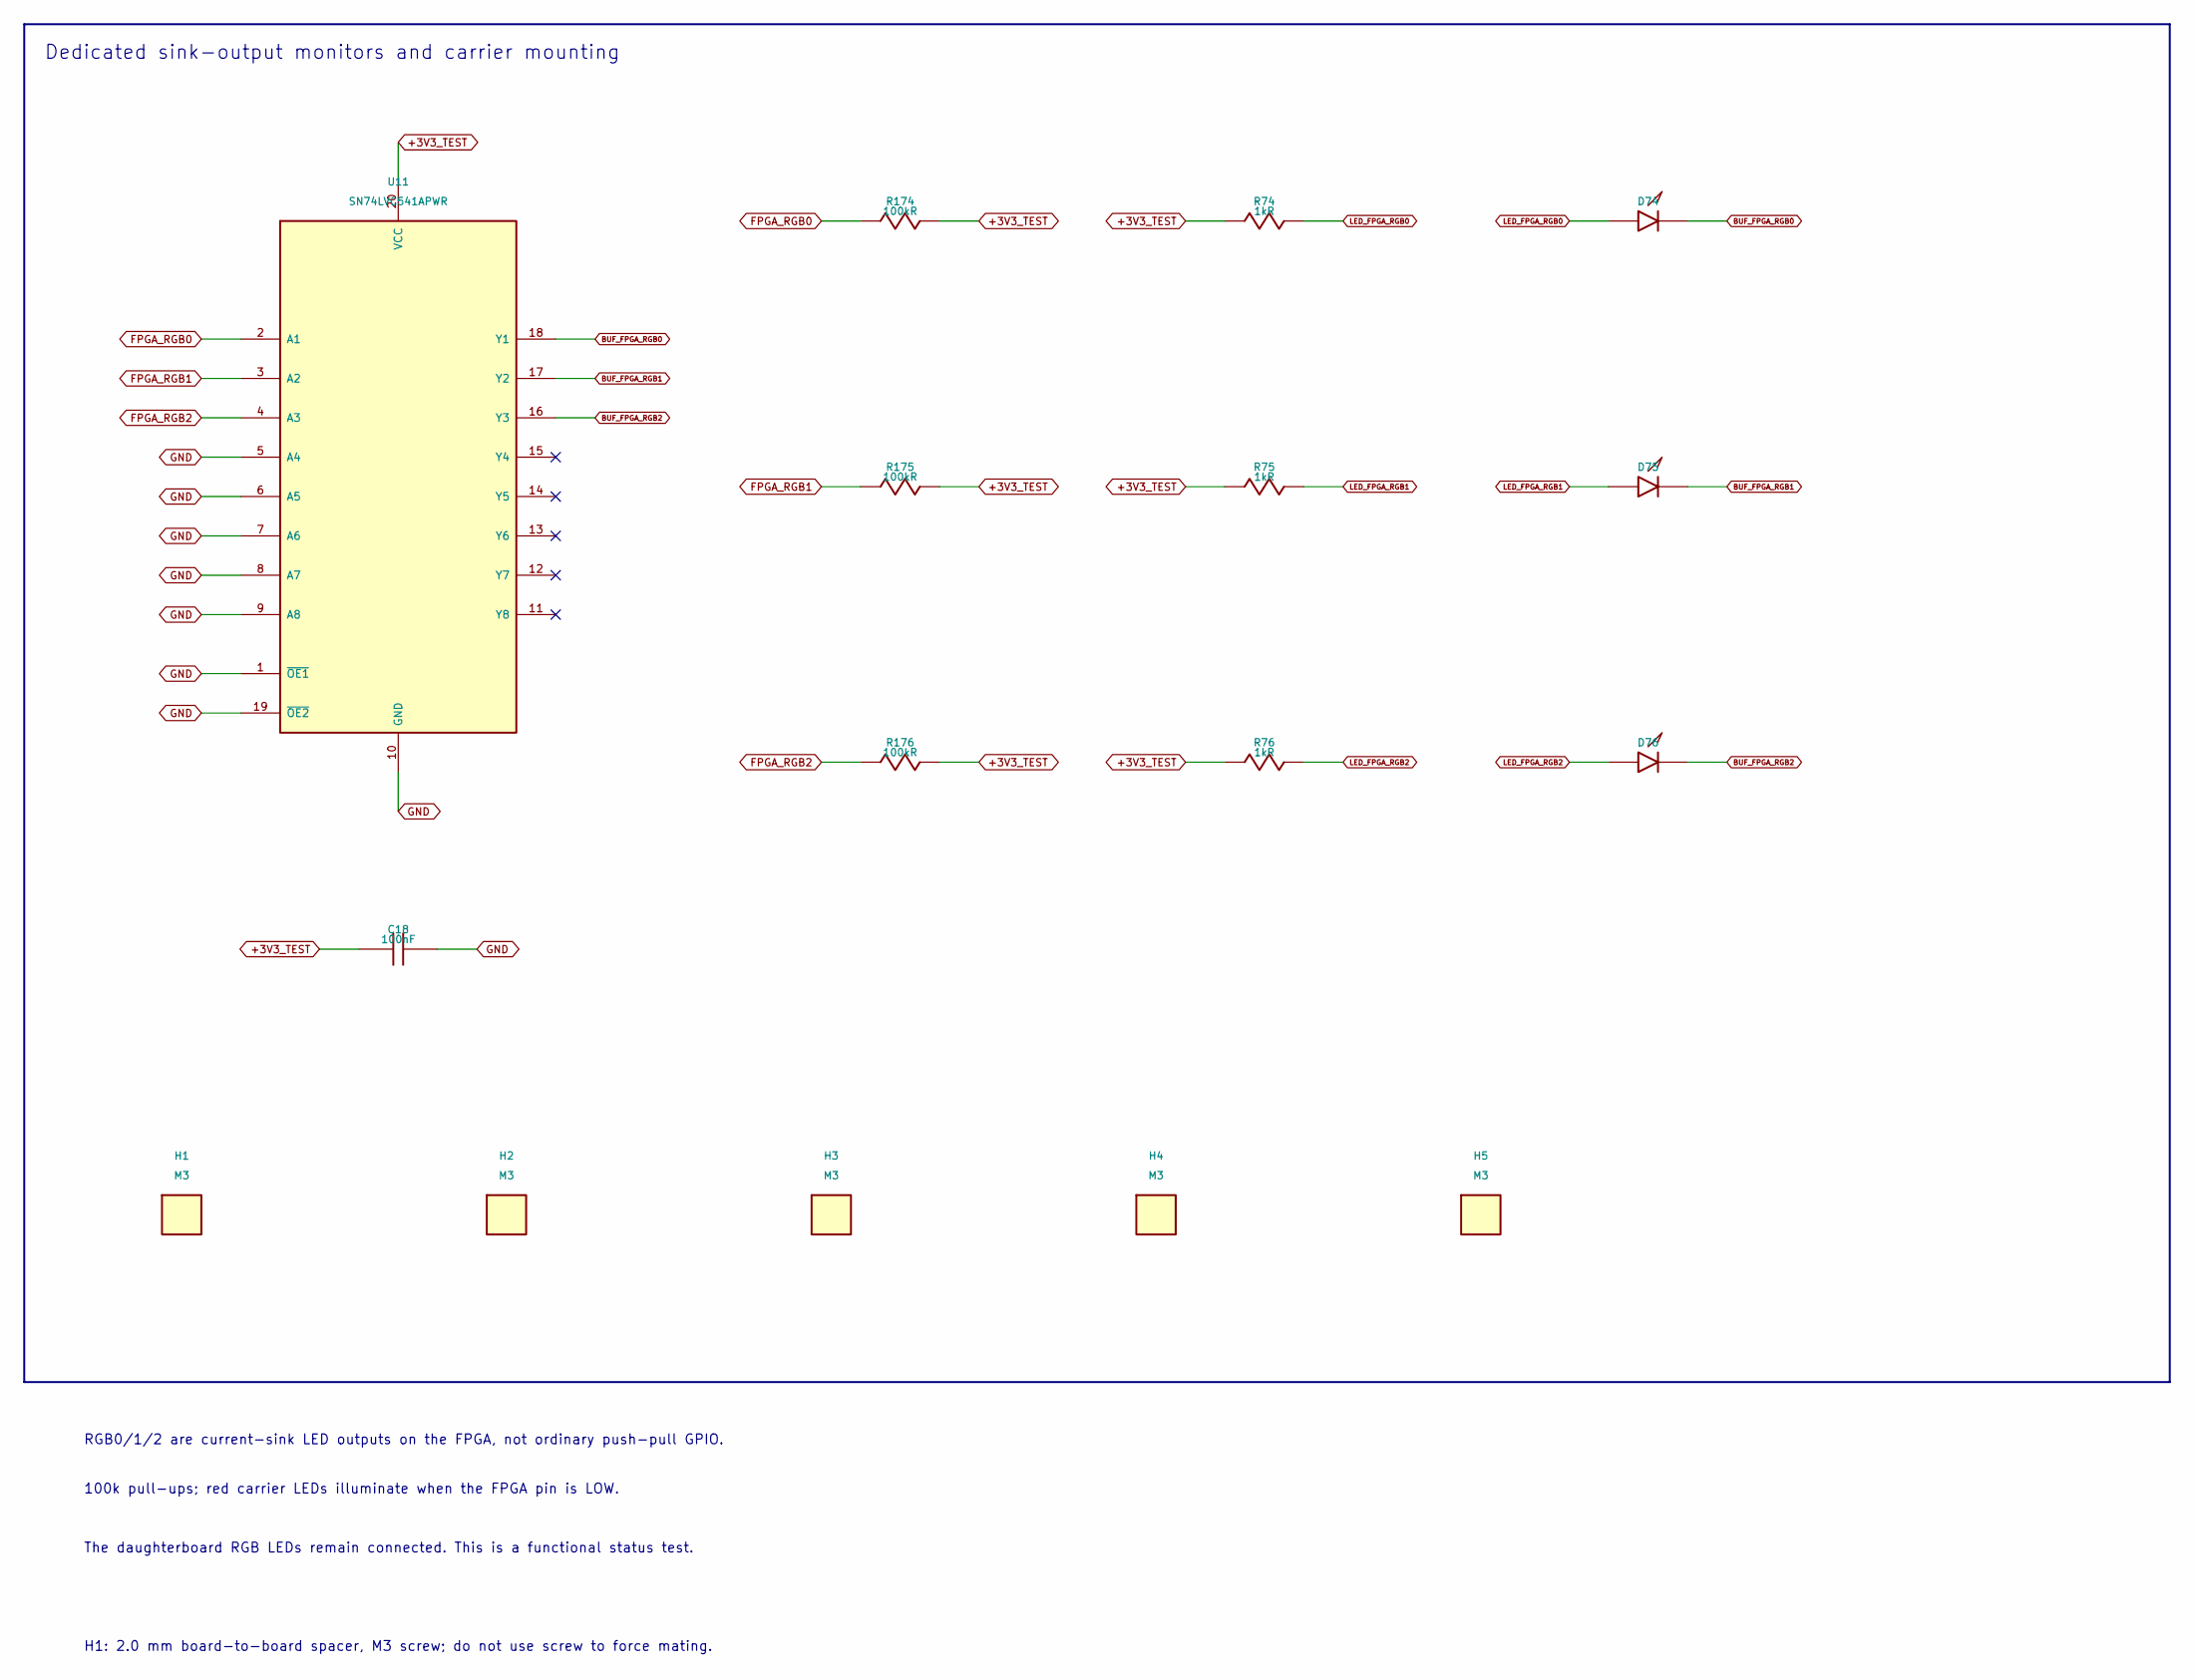
[picture p34: schematic rgb.kicad_sch, Module v1 programming and GPIO test carrier]

Parts:
C18: 100nF; C_0603_1608Metric; MPN CC0603KRX7R9BB104; LCSC C14663
D74, D75, D76: RED; LED_0603_1608Metric; MPN KT-0603R; LCSC C2286
H1, H2, H3, H4, H5: M3; MountingHole_3.2mm_M3; MPN M3
R74, R75, R76: 1kR; R_0603_1608Metric; MPN 0603WAF1001T5E; LCSC C21190
R174, R175, R176: 100kR; R_0603_1608Metric; MPN 0603WAF1003T5E; LCSC C25803
U11: SN74LVC541APWR; TSSOP-20_4.4x6.5mm_P0.65mm; MPN SN74LVC541APWR; LCSC C113281

Connections:
+3V3_TEST: C18.1, R74.1, R75.1, R76.1, R174.2, R175.2, R176.2, U11.20 (VCC); also elsewhere on the board
BUF_FPGA_RGB0: D74.1, U11.18 (Y1)
BUF_FPGA_RGB1: D75.1, U11.17 (Y2)
BUF_FPGA_RGB2: D76.1, U11.16 (Y3)
FPGA_RGB0: R174.1, U11.2 (A1); also elsewhere on the board
FPGA_RGB1: R175.1, U11.3 (A2); also elsewhere on the board
FPGA_RGB2: R176.1, U11.4 (A3); also elsewhere on the board
GND: C18.2, U11.1 (~OE1), U11.5 (A4), U11.6 (A5), U11.7 (A6), U11.8 (A7), U11.9 (A8), U11.10 (GND), U11.19 (~OE2); also elsewhere on the board
LED_FPGA_RGB0: D74.2, R74.2
LED_FPGA_RGB1: D75.2, R75.2
LED_FPGA_RGB2: D76.2, R76.2

Notes on the sheet:
Dedicated sink-output monitors and carrier mounting
RGB0/1/2 are current-sink LED outputs on the FPGA, not ordinary push-pull GPIO.
100k pull-ups; red carrier LEDs illuminate when the FPGA pin is LOW.
The daughterboard RGB LEDs remain connected. This is a functional status test.
H1: 2.0 mm board-to-board spacer, M3 screw; do not use screw to force mating.

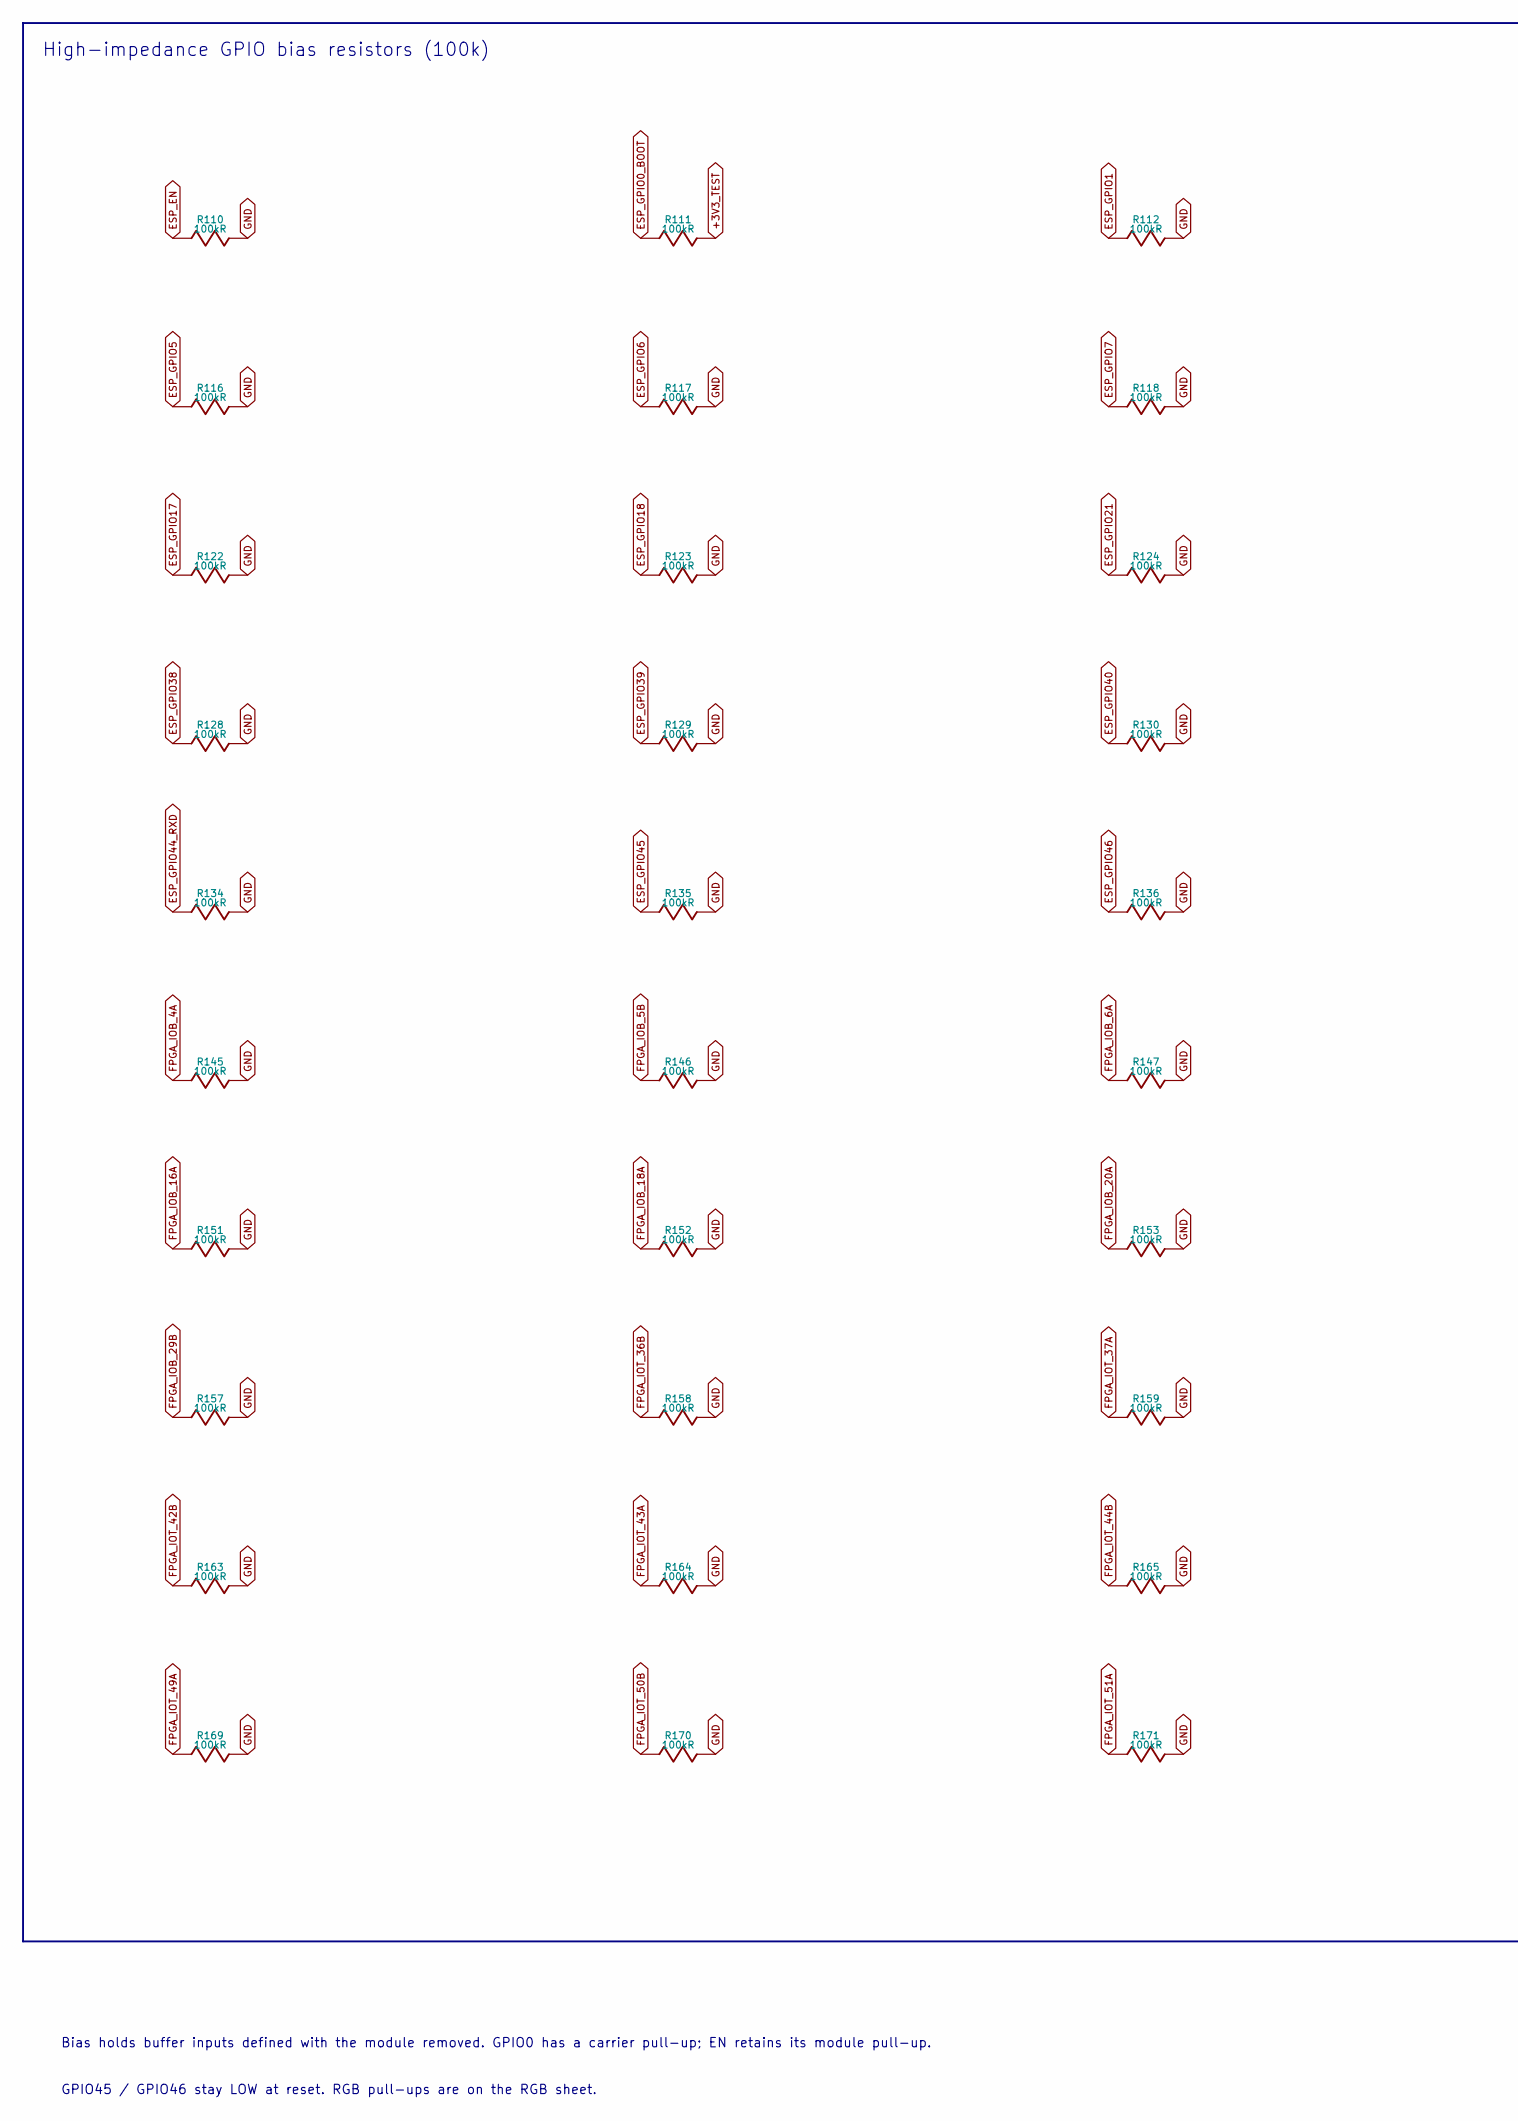
[picture p35: schematic bias.kicad_sch, Module v1 programming and GPIO test carrier, part in row 1, column 1]

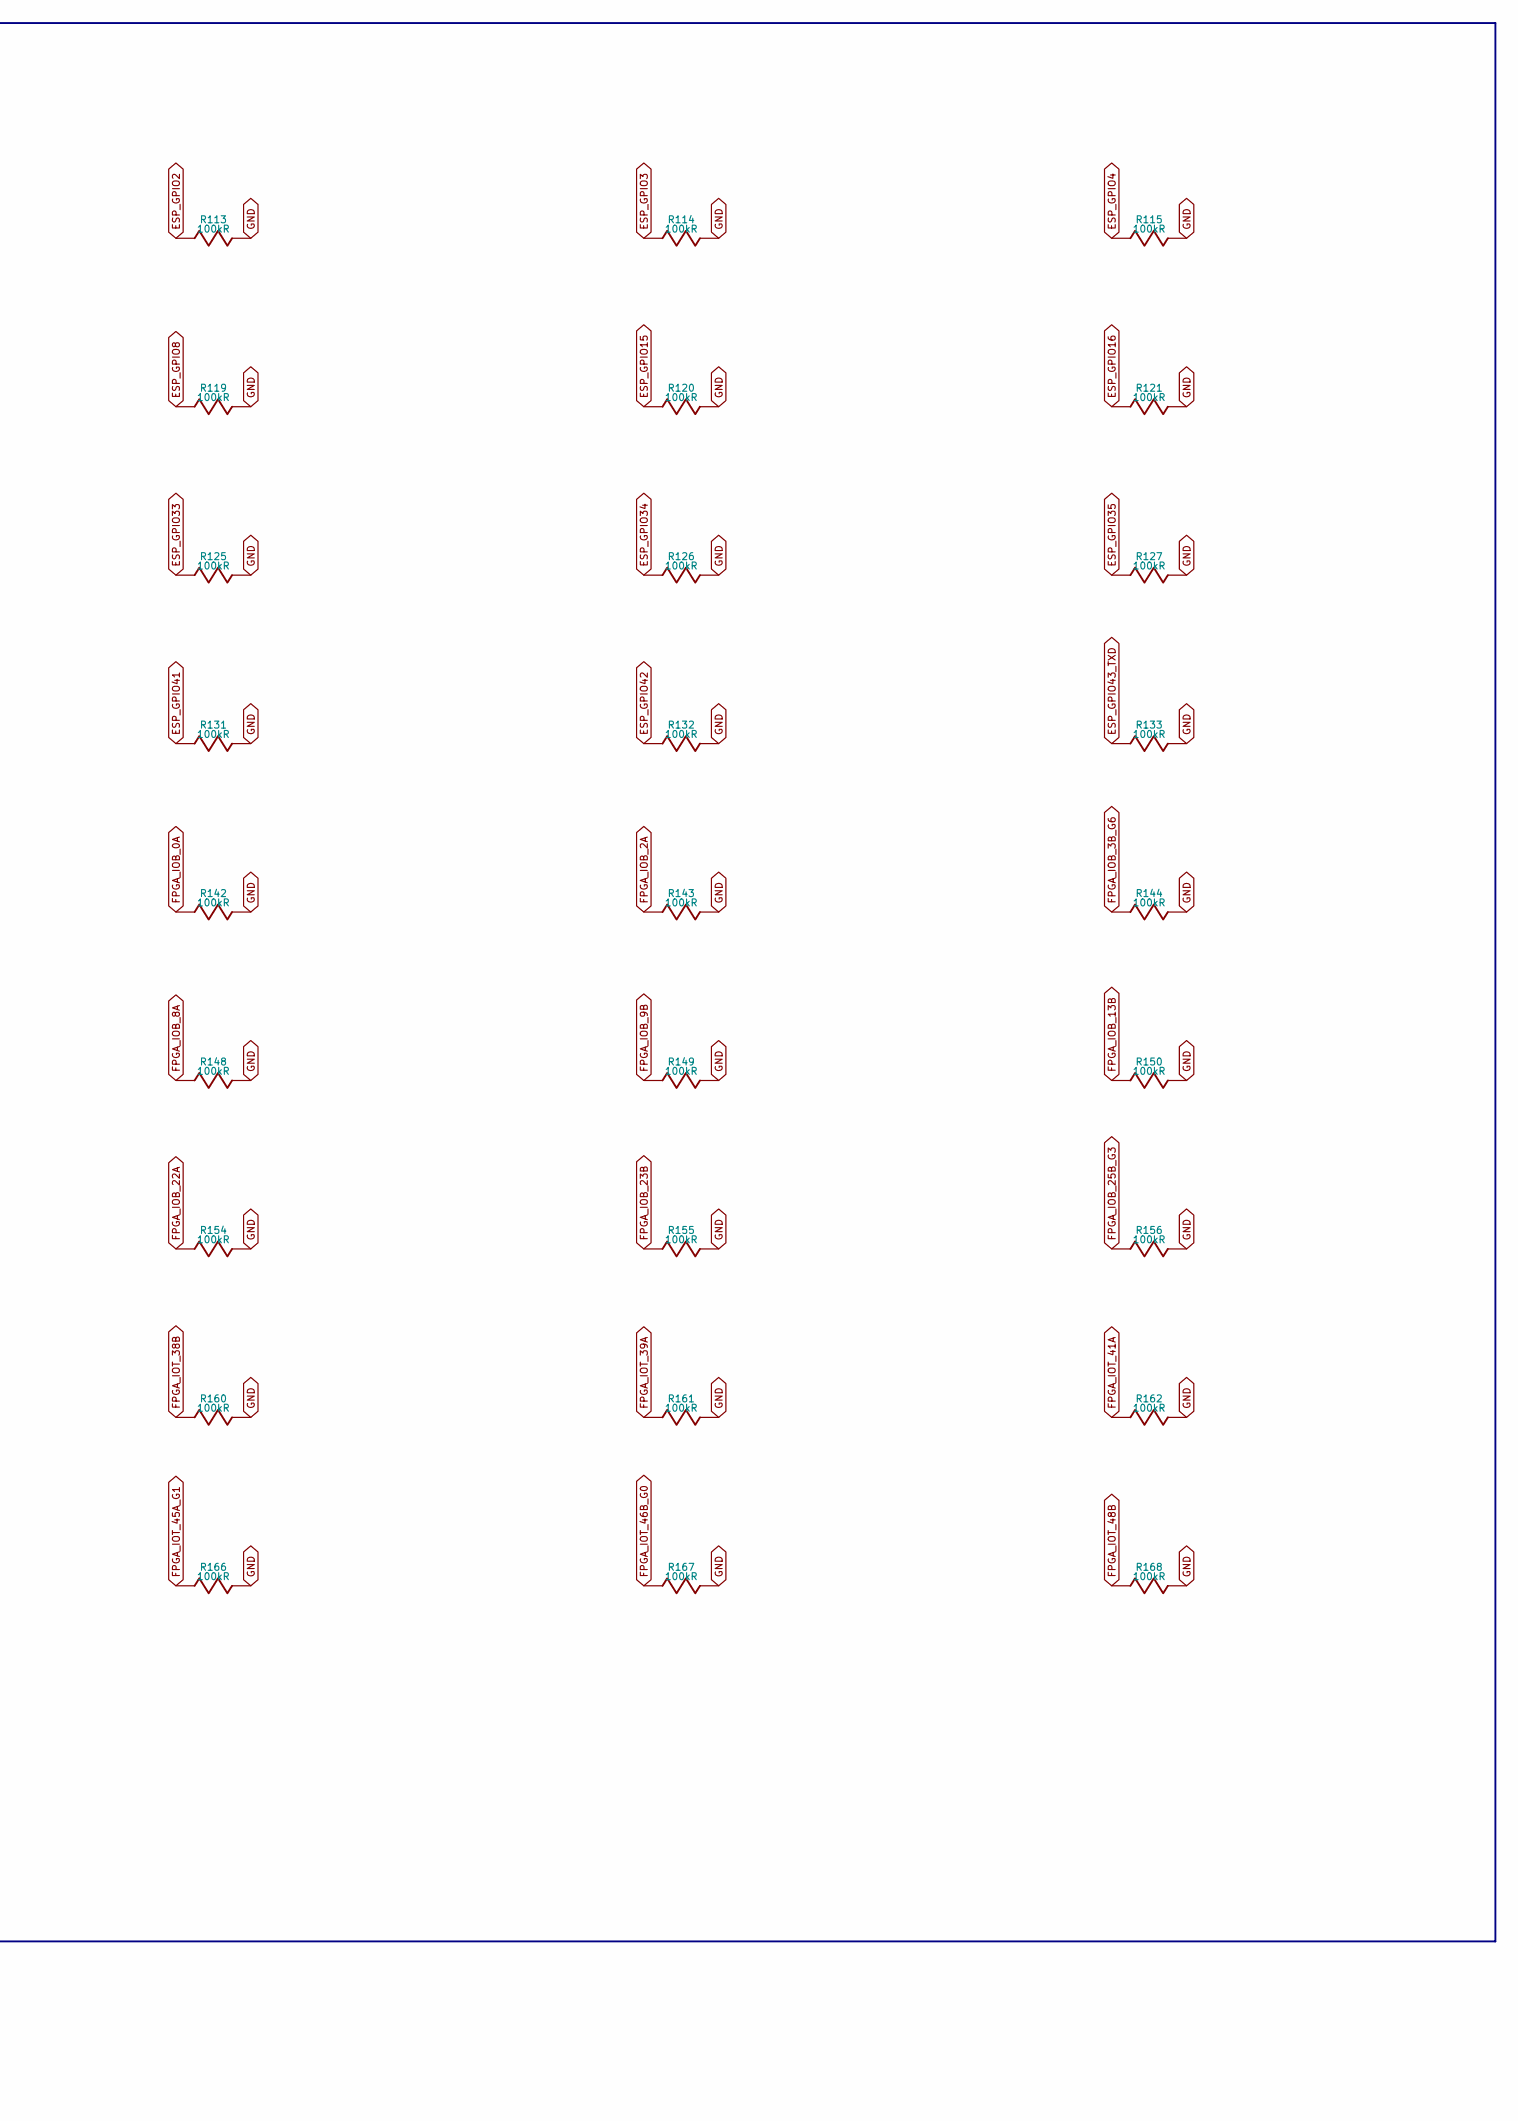
[picture p36: schematic bias.kicad_sch, Module v1 programming and GPIO test carrier, part in row 1, column 2]

Parts:
R110, R111, R112, R113, R114, R115, R116, R117, R118, R119, R120, R121, R122, R123, R124, R125, R126, R127, R128, R129, R130, R131, R132, R133, R134, R135, R136, R142, R143, R144, R145, R146, R147, R148, R149, R150, R151, R152, R153, R154, R155, R156, R157, R158, R159, R160, R161, R162, R163, R164, R165, R166, R167, R168, R169, R170, R171: 100kR; R_0603_1608Metric; MPN 0603WAF1003T5E; LCSC C25803

Connections:
+3V3_TEST: R111.2; also elsewhere on the board
ESP_EN: R110.1; also elsewhere on the board
ESP_GPIO0_BOOT: R111.1; also elsewhere on the board
ESP_GPIO1: R112.1; also elsewhere on the board
ESP_GPIO2: R113.1; also elsewhere on the board
ESP_GPIO3: R114.1; also elsewhere on the board
ESP_GPIO4: R115.1; also elsewhere on the board
ESP_GPIO5: R116.1; also elsewhere on the board
ESP_GPIO6: R117.1; also elsewhere on the board
ESP_GPIO7: R118.1; also elsewhere on the board
ESP_GPIO8: R119.1; also elsewhere on the board
ESP_GPIO15: R120.1; also elsewhere on the board
ESP_GPIO16: R121.1; also elsewhere on the board
ESP_GPIO17: R122.1; also elsewhere on the board
ESP_GPIO18: R123.1; also elsewhere on the board
ESP_GPIO21: R124.1; also elsewhere on the board
ESP_GPIO33: R125.1; also elsewhere on the board
ESP_GPIO34: R126.1; also elsewhere on the board
ESP_GPIO35: R127.1; also elsewhere on the board
ESP_GPIO38: R128.1; also elsewhere on the board
ESP_GPIO39: R129.1; also elsewhere on the board
ESP_GPIO40: R130.1; also elsewhere on the board
ESP_GPIO41: R131.1; also elsewhere on the board
ESP_GPIO42: R132.1; also elsewhere on the board
ESP_GPIO43_TXD: R133.1; also elsewhere on the board
ESP_GPIO44_RXD: R134.1; also elsewhere on the board
ESP_GPIO45: R135.1; also elsewhere on the board
ESP_GPIO46: R136.1; also elsewhere on the board
FPGA_IOB_0A: R142.1; also elsewhere on the board
FPGA_IOB_2A: R143.1; also elsewhere on the board
FPGA_IOB_3B_G6: R144.1; also elsewhere on the board
FPGA_IOB_4A: R145.1; also elsewhere on the board
FPGA_IOB_5B: R146.1; also elsewhere on the board
FPGA_IOB_6A: R147.1; also elsewhere on the board
FPGA_IOB_8A: R148.1; also elsewhere on the board
FPGA_IOB_9B: R149.1; also elsewhere on the board
FPGA_IOB_13B: R150.1; also elsewhere on the board
FPGA_IOB_16A: R151.1; also elsewhere on the board
FPGA_IOB_18A: R152.1; also elsewhere on the board
FPGA_IOB_20A: R153.1; also elsewhere on the board
FPGA_IOB_22A: R154.1; also elsewhere on the board
FPGA_IOB_23B: R155.1; also elsewhere on the board
FPGA_IOB_25B_G3: R156.1; also elsewhere on the board
FPGA_IOB_29B: R157.1; also elsewhere on the board
FPGA_IOT_36B: R158.1; also elsewhere on the board
FPGA_IOT_37A: R159.1; also elsewhere on the board
FPGA_IOT_38B: R160.1; also elsewhere on the board
FPGA_IOT_39A: R161.1; also elsewhere on the board
FPGA_IOT_41A: R162.1; also elsewhere on the board
FPGA_IOT_42B: R163.1; also elsewhere on the board
FPGA_IOT_43A: R164.1; also elsewhere on the board
FPGA_IOT_44B: R165.1; also elsewhere on the board
FPGA_IOT_45A_G1: R166.1; also elsewhere on the board
FPGA_IOT_46B_G0: R167.1; also elsewhere on the board
FPGA_IOT_48B: R168.1; also elsewhere on the board
FPGA_IOT_49A: R169.1; also elsewhere on the board
FPGA_IOT_50B: R170.1; also elsewhere on the board
FPGA_IOT_51A: R171.1; also elsewhere on the board
GND: R110.2, R112.2, R113.2, R114.2, R115.2, R116.2, R117.2, R118.2, R119.2, R120.2, R121.2, R122.2, R123.2, R124.2, R125.2, R126.2, R127.2, R128.2, R129.2, R130.2, R131.2, R132.2, R133.2, R134.2, R135.2, R136.2, R142.2, R143.2, R144.2, R145.2, R146.2, R147.2, R148.2, R149.2, R150.2, R151.2, R152.2, R153.2, R154.2, R155.2, R156.2, R157.2, R158.2, R159.2, R160.2, R161.2, R162.2, R163.2, R164.2, R165.2, R166.2, R167.2, R168.2, R169.2, R170.2, R171.2; also elsewhere on the board

Notes on the sheet:
High-impedance GPIO bias resistors (100k)
Bias holds buffer inputs defined with the module removed. GPIO0 has a carrier pull-up; EN retains its module pull-up.
GPIO45 / GPIO46 stay LOW at reset. RGB pull-ups are on the RGB sheet.

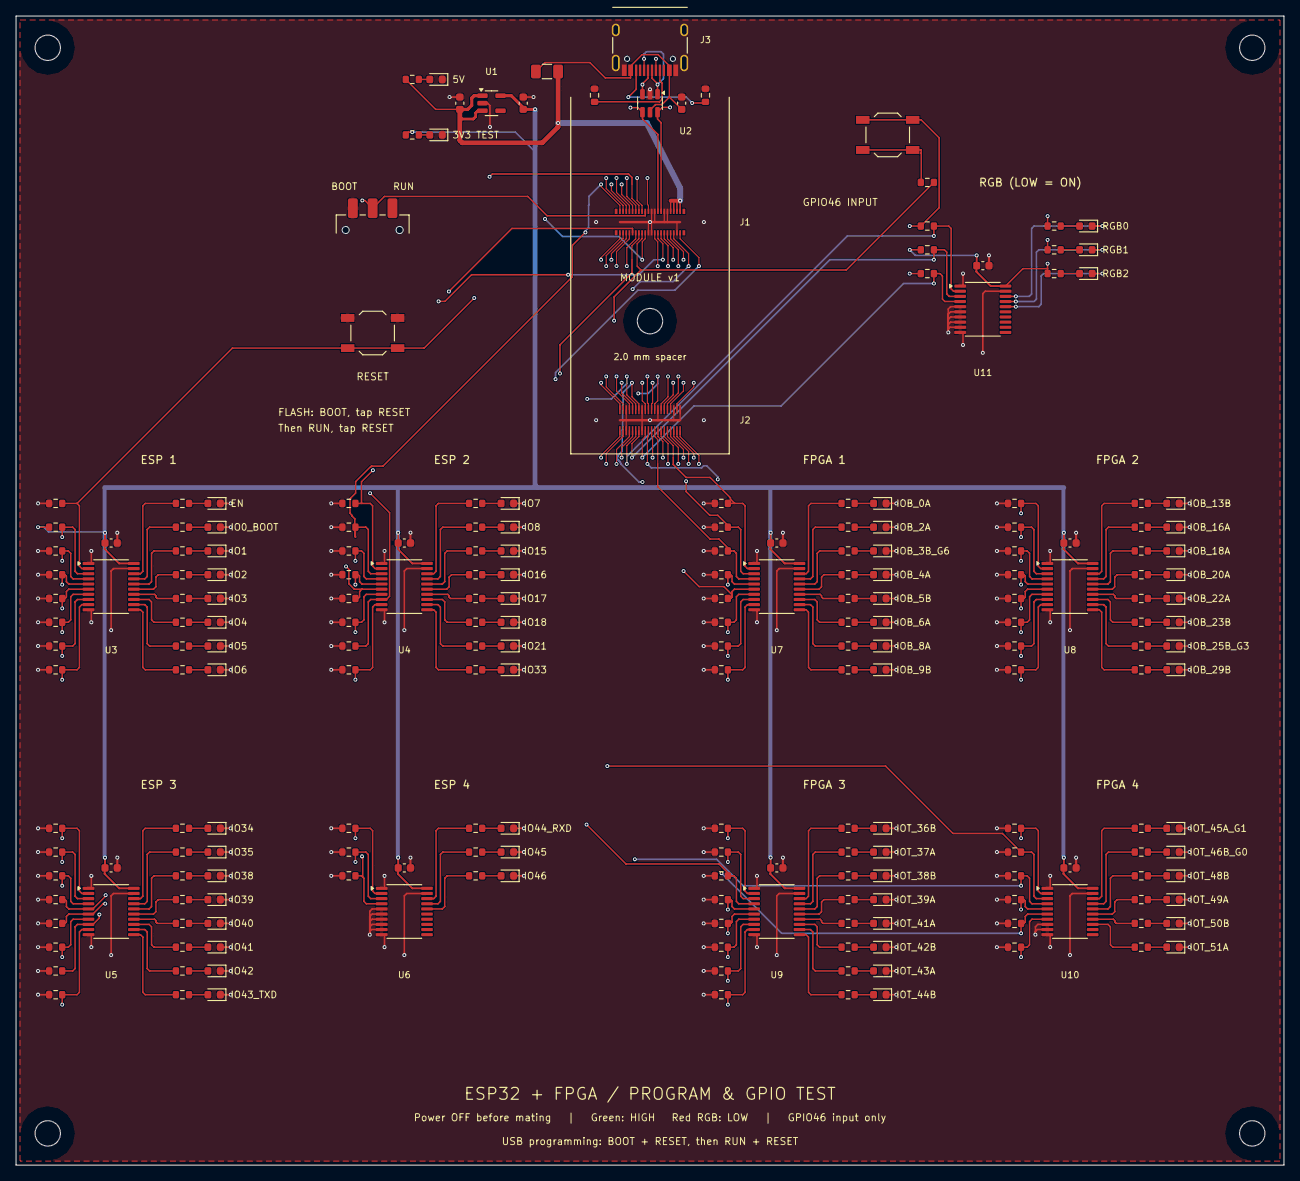
[picture p37: board carrier.kicad_pcb from above]

Board: 4 copper layers, 160.0 x 145.0 mm, 222 parts (0 on the bottom side), 191 nets.
