OrbitalCommons/gumstick/(commit log)

2026-09-26 Release v1: preserve ten-board ESP32 FPGA prototype order
    Archive exact ordered Gerbers, BOM, CPL and schematic PDF with checksums and clean validation reports. Include native designs, local libraries, models, sourcing notes and development tools; exclude temporary workspaces and duplicate imports.
2026-09-26 Add PCB playbook distilled from the bp-test layout session
    Preferences, schematic style, beyond-DRC review checklist, JLCPCB notes,
    agent workflow, tooling extraction plan, and a machine-readable profile.
2026-09-27 Point the KiCad PCB plugin at the playbook quality profile
2026-09-27 Checkpoint GPS calibrator carrier before connector-first routing
2026-09-28 Preserve GPS calibrator RFC v1 and fabrication review snapshot
2026-09-28 Document module v1 ICD, calibrator integration and fixture test procedures
2026-10-05 Recommend Kicadmium for KiCad workflows
2026-10-06 Add Tesla coil controller acquisition board and its generator tooling
    Development board: eight simultaneous ADC channels, module v1 carrier
    interface, two routed UD2.7-derived GDT bridges. Registers the project in
    .kicad-pcb.json (and makes it the workbench default), adds the tesla_*
    schematic/placement/routing scripts and review checks under tools/hardware,
    and links it from the top-level README. Not a fabrication release.
2026-10-06 Regenerate ESP32-FPGA module v1 fabrication outputs
    Refreshed gerbers, BOM/CPL, DRC/ERC/quality checks, schematic PDF, STEP and
    GLB from the current module.kicad_pcb; adds the previously untracked
    auxiliary gerber layers, JLCPCB package and kicad-pcb build manifest.
2026-10-06 Start ESP32-FPGA module v2 docs: ICD pinout, C6-FPGA link, design contract
2026-10-06 Add AGENTS.md with kicadmium setup and usage notes for agents
2026-10-06 Strip parenthetical noise from footprint descriptions on all boards
    User request: descriptions like "Resistor SMD 2512 (6332 Metric), square
    (rectangular) end terminal, IPC_7351 nominal, (Body size source:
    IPC-SM-782 page 72, https://...), generated with
    kicad-footprint-generator" take a lot of space and add nothing; every
    parenthesised group is noise. Every "(descr ...)" string in the five
    board files and the repo footprint libraries (boards/*/*.pretty,
    LED_SMD.pretty, Resistor_SMD.pretty, lcsc) has its parenthesised groups
    removed, with the resulting doubled commas and spaces tidied. The
    example above becomes "Resistor SMD 2512, square end terminal, IPC_7351
    nominal, generated with kicad-f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
2026-10-08 Add the ESP32-C6 + iCE40 M.2 module (v2): libraries, schematic, placed and routed board, ICD
    Bare ESP32-C6FH8 (QFN32) replaces the ESP32-S2 module and an M.2 2242 key-M card edge with a
    custom 67-contact pinout replaces the board-to-board connector. Same iCE40UP5K QSPI configuration
    link (SCK/MOSI/MISO/CS/IO2/IO3 + CRESET/CDONE), all through the GPIO matrix and off the strapping pins.
    Board: 22 x 42 x 0.8 mm, 4 layers (F.Cu, In1 GND, In2 +3.3 V with a +1.2 V island under U2, B.Cu).
    ESP signals ride a 15-lane B.Cu bus down the east margin to the back contacts; FPGA I/O drops
    straight to the front contacts or through vias to back contacts. Every front ground contact has its
    own via above the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
2026-10-08 Miter the ESP bus feeders east of U1 into their lanes
    Each B.Cu feeder ran east on its level and turned 90 degrees into its bus lane. They now take a
    45-degree leg as soon as the via field allows (nested legs, 0.36 mm steps, 0.4 mm off the R20/R21/
    C38/R29 vias), saving 1.0-4.3 mm per feeder (39 mm total). USB pair skew is 0.71 mm.
    ERC 0, DRC with parity 0/0 unconnected, lint info-only (22), quality unchanged.
2026-10-08 Strip the vendor drawings from the iCE40 footprint
    The v1 ICE40-QFN footprint carried its datasheet dimension drawing (56 lines, 10 notes on
    User.Drawings) and a 109-line hatched fab body. Keep copper, paste and mask only; draw a plain 7 mm
    fab outline with a pin-1 chamfer and add the missing courtyard.
    ERC 0, DRC with parity 0/0, lint info-only (22), quality errors 39 -> 31 (exposed-pad vias remain).
2026-10-08 Bring C38 and C49 onto their supply pins
    C38 (ESP VDDPST2, pin 20) moves 0.2 mm west to 1.97 mm by swapping the GPIO15 and USB D+ via drops
    and nudging the pin-20 plane via. C49 (FPGA core VCC, pin 30) now lies on the pin-30 line at 1.94 mm;
    the 1.2 V regulator trunk enters the inner-layer island through a new west lobe instead of a front
    track past the cap, and the PLL pin line narrows to 0.15 mm beside it.
    The remaining four cases (U2 pins 5, 29, 33 and ESP VDDA3P3) are boxed in by I/O exits on both
    sides of the pin at 0.5 mm pitch; the contract and README record the per-pin reason.
    ERC 0, DRC with parity 0/0, lint info-only (22), quality decoupling findings 9 -> 7.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
2026-10-08 Stagger the U2 west via drops into a tight zig-zag
    Pins 25-33 now alternate between two via columns 0.55 mm apart
    (x 106.75 / 106.2): 25 A, 26 B, 27 A, 28 B, 30 A (island feed), 31 B,
    33 A (plane via). Pin 31 lanes west on x 105.9 and re-enters contact 56
    with a south-east leg; the +1.2V island wall moves to x 107.3 so the
    pin-33 plane via stays in the +3.3V plane.
    ERC 0, DRC with parity 0, lint 22 infos (unchanged), quality unchanged.
2026-10-08 Meet the JLCPCB gold-finger rules on the M.2 card edge
    Per https://jlcpcb.com/help/article/jlcpcb-gold-fingers (read 2026-10-07):
    - fingers stop 0.6 mm inside the routed edge (their 30 degree bevel
    copper setback, 1.13 mm at 1.6 mm, scaled to the 0.8 mm card and
    rounded up); the inner pad ends stay at 2.0 / 2.5 mm;
    - one solder-mask window per side over the whole finger field, with
    mask bridges allowed on J1 and a rule area that keeps the pours out;
    - the end ground contacts 1/3 and 71/73/75, which used to join the
    pour, now run to the board-end vias on hand-drawn tracks;
    - fab notes, README and contract record ENIG + gold-finger option,
    30 degree bevel, and the >= 50 x 50 mm panel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
2026-10-08 Miter the nested ESP feeder corners and deepen their lane legs
    ESP_EN, GPIO4, GPIO5, GPIO8, GPIO9_BOOT and USB_D- each get a 0.8 mm
    45-degree corner off the via drop instead of a square turn. Their legs
    into the B.Cu lanes now start further west (x 115.7 .. 116.2) and step
    0.6 mm in y - x, set by GPIO8's in-line R21 via at x 116.0.
    ERC 0, DRC with parity 0, lint 24 infos (route.bend_count +2 from the
    added miters), quality unchanged.
2026-10-08 Set the v2 stackup from the M.2 thickness and size the RF feed for it
    M.2 fixes the card at 0.8 +/- 0.08 mm. JLCPCB's 0.8 mm 4-layer builds
    are 0.721-0.803 mm nominal with +/- 0.1 mm tolerance, so the board now
    uses the best-centred one, JLC04081H-3313 (0.799 mm: 35 um Cu / 0.0994
    mm 3313 prepreg / 0.5 mm core / 0.0994 mm 3313 / 35 um Cu), replacing
    the hand-trimmed 7628 build. Board thickness in the file is now 0.8 mm
    (it was the 1.6 mm default).
    The 50 ohm coated CPWG on 0.0994 mm 3313 is 0.14 mm with a 0.15 mm gap:
    JLCPCB's calculator gives 50.4 ohm, an independent 2D field solve 49.9
    ohm. tools/hardware/module_v2_impedance.py reproduces both and writes
    docs/rf-feed.json. RF netclass and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
2026-10-08 Move the 3.3 V input bulk caps to the power contacts
    C60, C61, C66 and C67 were meant to sit beside the power contacts but
    were placed at the mounting end, 35 mm away, where they only dropped
    into the planes through vias. They now sit at the contacts and feed
    straight into the contacts' own In2 vias:
    - C67 (22 uF) and C60 (10 uF) above contacts 70 and 72, each with a
    ground via;
    - C61 (22 uF) and C66 (1 uF) in the strip east of the FPGA fan above
    contact 2, sharing one feed. The ESP bus lanes run under that strip,
    so their ground pads return through the front pour (recorded with the
    other pour-return deviations). The contact-1 ground via moves to
    (120.7, 137.75) to clear the feed.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
2026-10-08 Drop CRESET/CDONE straight into U2 and pull the ESP bus 1.7 mm west
    CRESET and CDONE now turn west above the FPGA's east fan to vias on
    the pin-8 / pin-7 via columns (115.25, 125.6) and (115.95, 126.3), so
    their B.Cu hops are straight drops instead of diagonals across the
    middle of the board. That frees x 116.4 .. 118.1 for the ESP bus: all
    15 lanes move from 118.1 .. 121.6 to 116.4 .. 119.9, which shortens
    every bus net by 1.2-1.4 mm on B.Cu (512.6 -> 491.2 mm in total for
    the bus plus CRESET/CDONE).
    With the lanes out of the strip above contact 2, C61 and C66 get their
    ground vias back and drop off the pour-return deviation list.
    ERC 0, DRC with parity 0, lint 24 infos (unchanged), quali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
2026-10-08 Give the 0402 capacitors and the iCE40 their 3D bodies
    The C_0402 and ICE40-QFN footprints came from the v1 library without a
    model, so 18 capacitors (and L5, which uses the C_0402 land) and the
    FPGA had no body in the 3D view. The constructor now attaches KiCad's
    C_0402_1005Metric and QFN-48-1EP_7x7mm models (copied into 3dmodels/)
    to imported footprints that arrive without one; the iCE40 land has pin
    1 top-left like the stock QFN-48, so no rotation is needed.
    Only J1 (the card-edge fingers) and the bare TP1/TP2 pads remain
    without a model, which is intended.
    ERC 0, DRC with parity 0, lint 24 infos (unchanged), quality unchanged.
2026-10-08 Remove the 12 stray stitching vias and let lint catch future ones
    Twelve free-standing GND vias (the "plane stitching" list, including
    the one at 121.3, 106.8) touched no trace or pad. Lint never flagged
    them because the route script labelled every unattached ground via
    "stitching" (and any via within 1.6 mm of a capacitor ground pad
    "return") in the lint role map. Without those labels lint reports them
    as via.role_missing.
    The vias are gone, and roles are now assigned only to vias that a
    same-net trace touches (return / feed) or that sit in an exposed pad
    (thermal). Anything else stays unroled, so lint reports it.
    DRC with parity 0 and no isolated copper (every outer ground-pour
    island st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
2026-10-09 Move the v2 module to the QFN40 ESP32-C6 with a 16 MB flash
    U1 is now the flashless ESP32-C6 in QFN40 (LCSC C5364646, 0.4 mm pitch,
    3.3 mm exposed pad; KiCad's QFN-40 land with the pad shrunk to match),
    with a Winbond W25Q128JVPIQ 16 MB quad SPI flash (U4, LCSC C190862)
    on SPI0/1 in QIO mode.
    Pin changes: the QFN40 has GPIO10/11 but no GPIO14, so CRESET/CDONE
    move to GPIO10/11 and GPIO18 is new on the connector (13 GPIOs + USB +
    EN). The ESP bus grows to 16 back lanes; contact 33 (formerly ground)
    carries GPIO4 through its old via, and the other ESP contacts shift one
    slot east (USB is now on 26/24).
    Layout: U1 moved 0.5 mm south to make room for the crystal's 0201 L5
    and the 0201 VDDA1 ca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
2026-10-09 Bring the v2 manifest's stackup note up to date
    The project manifest still named the old JLC04081H-7628 stackup and the
    0.26 mm RF width from before the stackup change (69748cc). It now names
    JLC04081H-3313, the 0.14 / 0.15 mm CPWG, and the Standard PCBA panel
    requirement for gold fingers.
2026-10-12 Accept the calibrator's board legends as intentional silkscreen text
    Give gps-time-calibrator its own quality profile (a copy of the shared
    docs/pcb-playbook/pcb-profile.yaml) with silkscreen.explanatory_text set
    to info instead of forbid. The 25 findings are the ROW 0-3 / 0-15 bit
    grid legends, the board title and revision line, MODULE v1, GPS ANT,
    INPUT and OUTPUT, all deliberate. Other boards keep the strict setting.
    Quality errors 68 -> 43; the legends still list as info.
2026-10-12 Retarget the GPS feed and docs to a two-layer 1.6 mm build
    The GNSS_RF feed (U6.11 -> J5.1, 9.21 mm) is now a 0.90 mm grounded
    coplanar line with 0.20 mm clearance to the F.Cu GND pour (DRU rule
    updated; refilled pour measures 0.205 mm), plus six GND fence vias at
    1.05 mm either side (x 189.75 / 193.0 / 194.6) tying the coplanar
    grounds to B.Cu. B.Cu under the feed is solid GND.
    JLCPCB's coated grounded-CPW calculator (geometry only; the session
    re-ran the 4-layer case at 50.50 ohm) gives 49.9 ohm for 0.90/0.20 on
    ~1.53 mm FR4, Er 4.5. JLCPCB offers no controlled impedance on two
    layers, so this is nominal. Sensitivity: thickness +/-0.2 ohm, Er 4.2-4.8
    51.6-49.1 ohm, gap +/-0.03 mm 46.9-53.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
2026-10-15 GPS calibrator: final layout pass, BT1 clip, JLC corrections; submitted for manufacture
    Submitted to JLCPCB 2026-10-14 (2-layer 1.6 mm FR-4, 1 oz, ENIG,
    Economic PCBA, top side). Outputs in boards/gps-time-calibrator/fab
    were produced by tools/hardware/calibrator_export.py; fab/STATUS.md
    records the order and what is hand-assembled.
    Board changes
    - BT1: the Seiko ML414H cell went out of stock. Replaced with a Q&J
    CR1220-2 clip (LCSC C70381) for a user-fitted ML1220 rechargeable
    cell; footprint and STEP model drawn from the Q&J vendor drawing
    (+ contact toward -X, pin 1). D75/R181/TP27 moved to make room;
    "ML1220 ONLY" on silkscreen. Seiko footprint/model kept, unused.
    - D1/R3 power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
2026-10-15 Add the Jauch ML1220 datasheet and cite it for BT1
    Jauch 252290: 12.5 x 2.0 mm, 3 V, 18 mAh, 1 mA nominal charge current,
    -20 to +70 C. No charge voltage is given; keep the standard ML1220
    2.8-3.2 V window. The board's 3 k + BAS16 path charges at ~0.2 mA.
2026-10-20 Split the gumstick module out of bp-test
    Extracted from meawoppl/bp-test with history for the module, its
    successor and the programming carrier. Folder moves:
    boards/esp32-fpga-module -> current-df40-connectors (v1, ordered)
    boards/esp32-fpga-module-v2 -> future-m2-goldfingers (v2, M.2 draft)
    boards/programming-carrier -> programming-carrier
    - Rewrite repo-root paths in scripts/docs and re-resolve relative
    links for the new depth; links to boards that stay in bp-test now
    point at github.com/meawoppl/bp-test, calibrator links at
    OrbitalCommons/gps-time-calibrator.
    - .kicad-pcb.json lists only these three projects; prune
    libraries/datasheets to the parts these designs cite;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
2026-10-20 Add renders and 3D views of the three boards to the README
    kicad-cli (KiCad 10) top, bottom and angled renders (transparent,
    cropped) for the v1 DF40 module, v2 M.2 module and programming carrier;
    binary STLs for GitHub's 3D viewer (2.5 / 1.6 / 8.5 MB) and colour GLBs
    with tracks, soldermask and silkscreen. Boards were DRC/parity clean;
    no missing 3D models reported.
2026-10-21 Point carrier links at StratumZero (renamed from GPS time calibrator)
    The OrbitalCommons/gps-time-calibrator repo is now OrbitalCommons/stratumzero
    with its board folder at boards/stratumzero.
